sosoru/TrainUtilizingSystem/Schematics/submitted/2012_0119_ethernetboard_forPcbCart/ReadMe_FilieList.txt

Component Side:		EthernetBridge.cmp
Solder Side:		EthernetBridge.sol

Silk screen CMP:	EthernetBridge.plc
Solder stop mask CMP:	EthernetBridge.stc
Solder stop mask SOL:	EthernetBridge.sts
Outline:		EthernetBridge.out

Photoplotter info:	EthernetBridge.gpi
Drill rack:		EthernetBridge.drl
Drill data:		EthernetBridge.drd
Drill station info:	EthernetBridge.dri
