sosoru/TrainUtilizingSystem/Schematics/EthControlling/MotorController.htm

Partlist exported from C:/Users/Administrator/Documents/TrainUtilizingSystem/Schematics/EthControlling/MotorController.sch at 2012/06/23 19:24:36

Assembly variant:

Qty | Value | Device | Parts
4 | | CPOL-EUE2,5-6E | C1, C2, C26, C28
4 | 0.1 | R-EU_R1206 | R12, R15, R29, R35
12 | 0.1u | C-EUC0603 | C3, C4, C6, C7, C10, C14, C15, C16, C19, C20, C25, C27
4 | 1Meg | R-EU_R0603 | R3, R13, R28, R34
4 | 1N4148DO35-7 | 1N4148DO35-7 | D1, D2, D3, D4
8 | 1k | R-EU_R0603 | R6, R7, R17, R19, R25, R26, R32, R33
4 | 2SC1815 | 2SC1815 | T1, T2, T3, T4
12 | 3.3k | R-EU_R0603 | R1, R2, R10, R11, R14, R16, R21, R23, R30, R31, R36, R37
8 | 4.7u | C-EUC0603 | C5, C8, C9, C11, C17, C18, C23, C24
5 | 10k | R-EU_R0603 | R5, R8, R22, R39, R41
1 | 20.000M | XTAL/S | Q1
2 | 22p | C-EUC0603 | C21, C22
4 | 25k | R-EU_R0603 | R18, R20, R24, R27
1 | 47u | L-EUL3216C | L1
4 | 100k | R-EU_R0603 | R4, R9, R38, R40
1 | 100u | CPOL-EUE2-5 | C13
1 | 100u | CPOL-EUE2.5-6 | C12
4 | 942H | 942H | A, B, C, D
1 | AVR-JTAG-10 | AVR-JTAG-10 | JP1
4 | G | LED3MM | LED1, LED3, LED5, LED7
1 | MEGA164P/324P/644P-AU | MEGA164P/324P/644P-AU | IC2
4 | O | LED3MM | LED2, LED4, LED6, LED8
1 | OPA4234P | OPA4234P | IC3
5 | POLYSWITCH_20204/5 | POLYSWITCH_20204/5 | F1, F2, F3, F4, F5
4 | TB6559 | TB6559 | U$1, U$2, U$3, U$4
2 | TLP621-2 | TLP621-2 | IC1, IC4
1 | TUS_MODULE_SUPPLY | TUS_MODULE_SUPPLY | CONN
8 | XH-2 | XH-2 | A_NEXT, A_PREV, B_NEXT, B_PREV, C_NEXT, C_PREV, D_NEXT, D_PREV
