sosoru/TrainUtilizingSystem/(list of files, cad)

Other CAD files:
DeviceSoftware/TrainSensorModule/TrainSensorModule.obj
DeviceSoftware/TrainSensorModule/startup.obj
