sosoru/TrainUtilizingSystem/ServerUtility/TusSolution/TestProject_/VoltageTestCase.csv

Expected | Result
0.5 | 0.5
-0.1 | -0.1
1.1 | 1.1
