sosoru/TrainUtilizingSystem/Schematics/Box/Box_Bottom.pdf

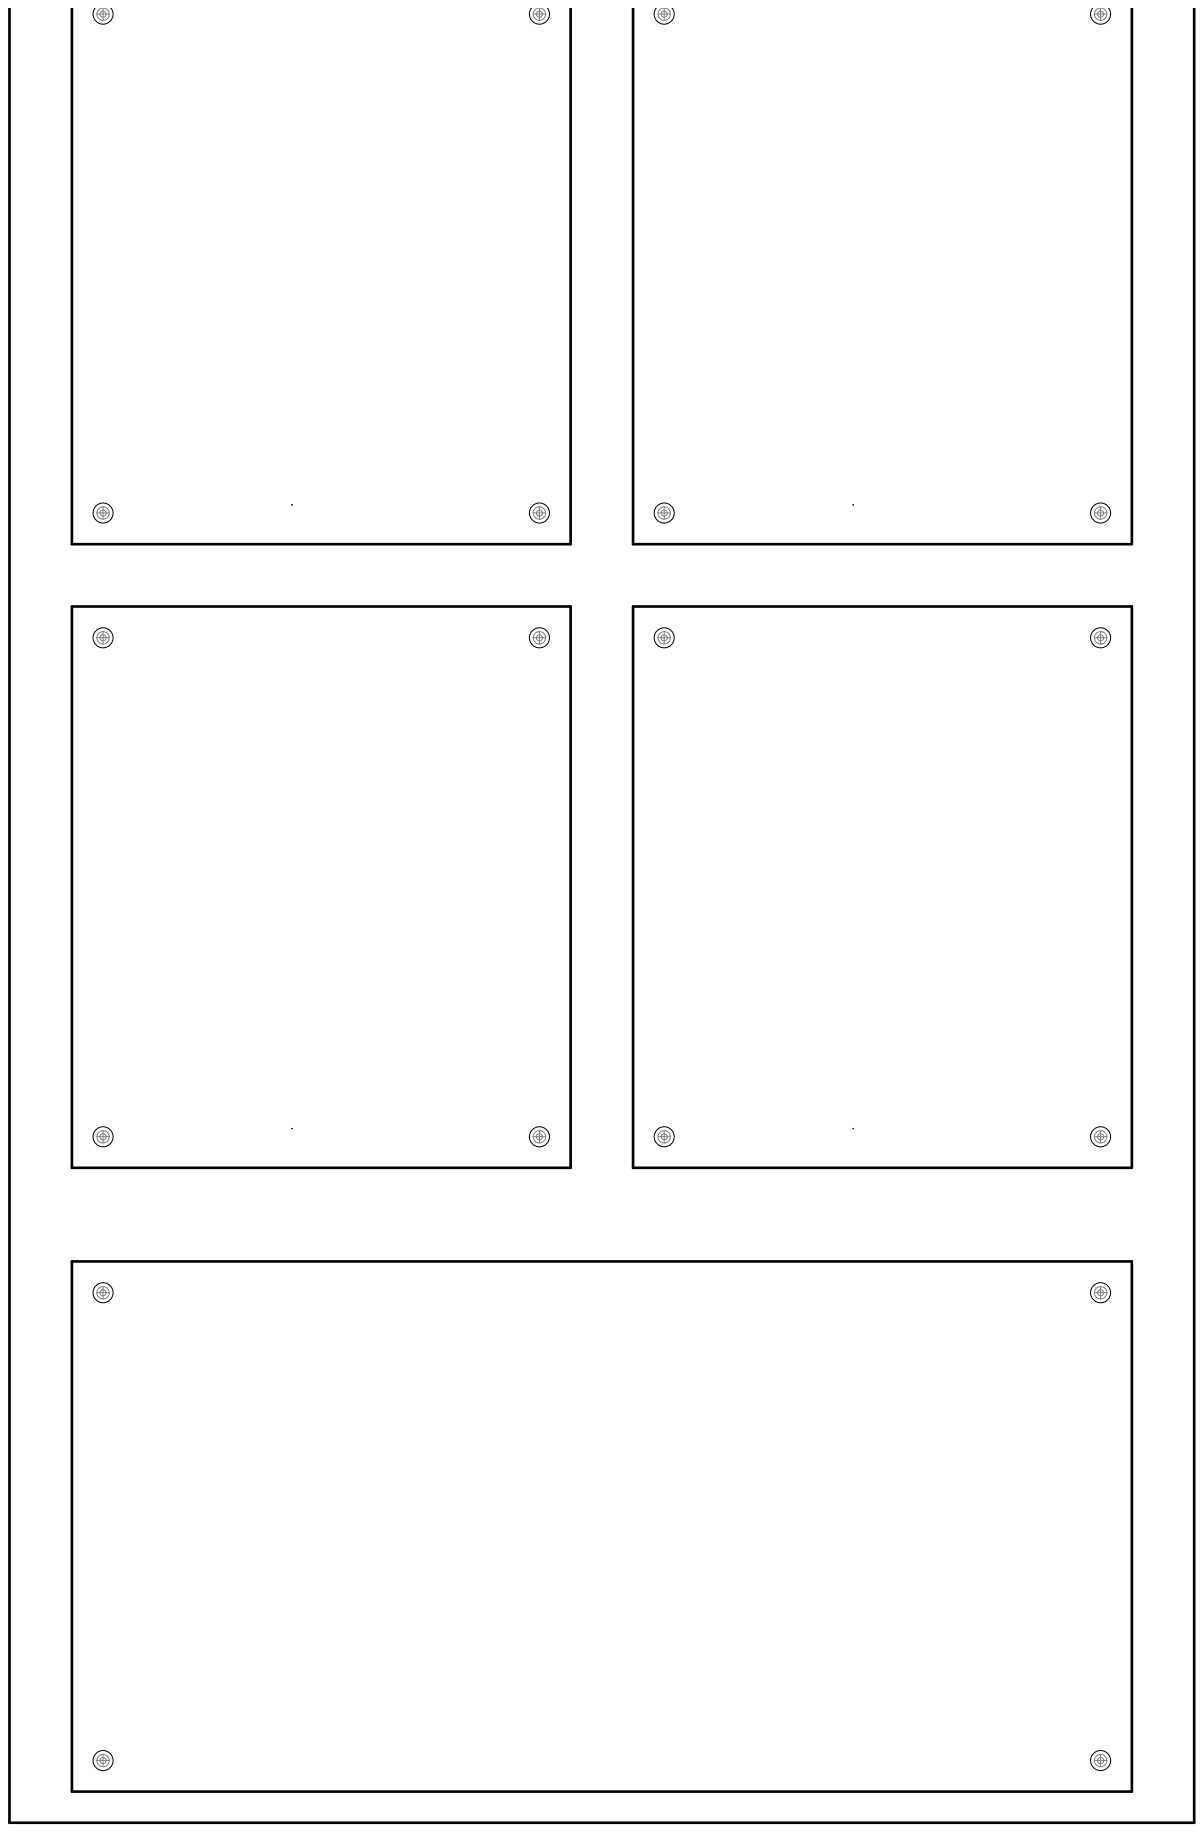
[picture p1: page 1]
