sosoru/TrainUtilizingSystem/Schematics/Box/Box_Side.pdf

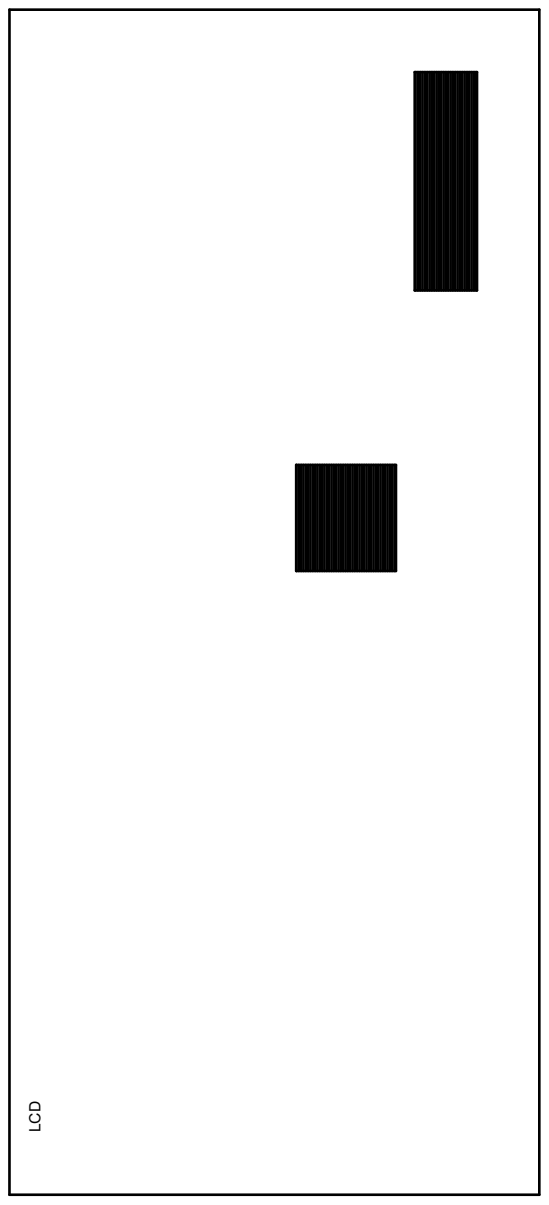
[picture p2: page 1]
