sosoru/TrainUtilizingSystem/Schematics/Box/Box_Top.pdf

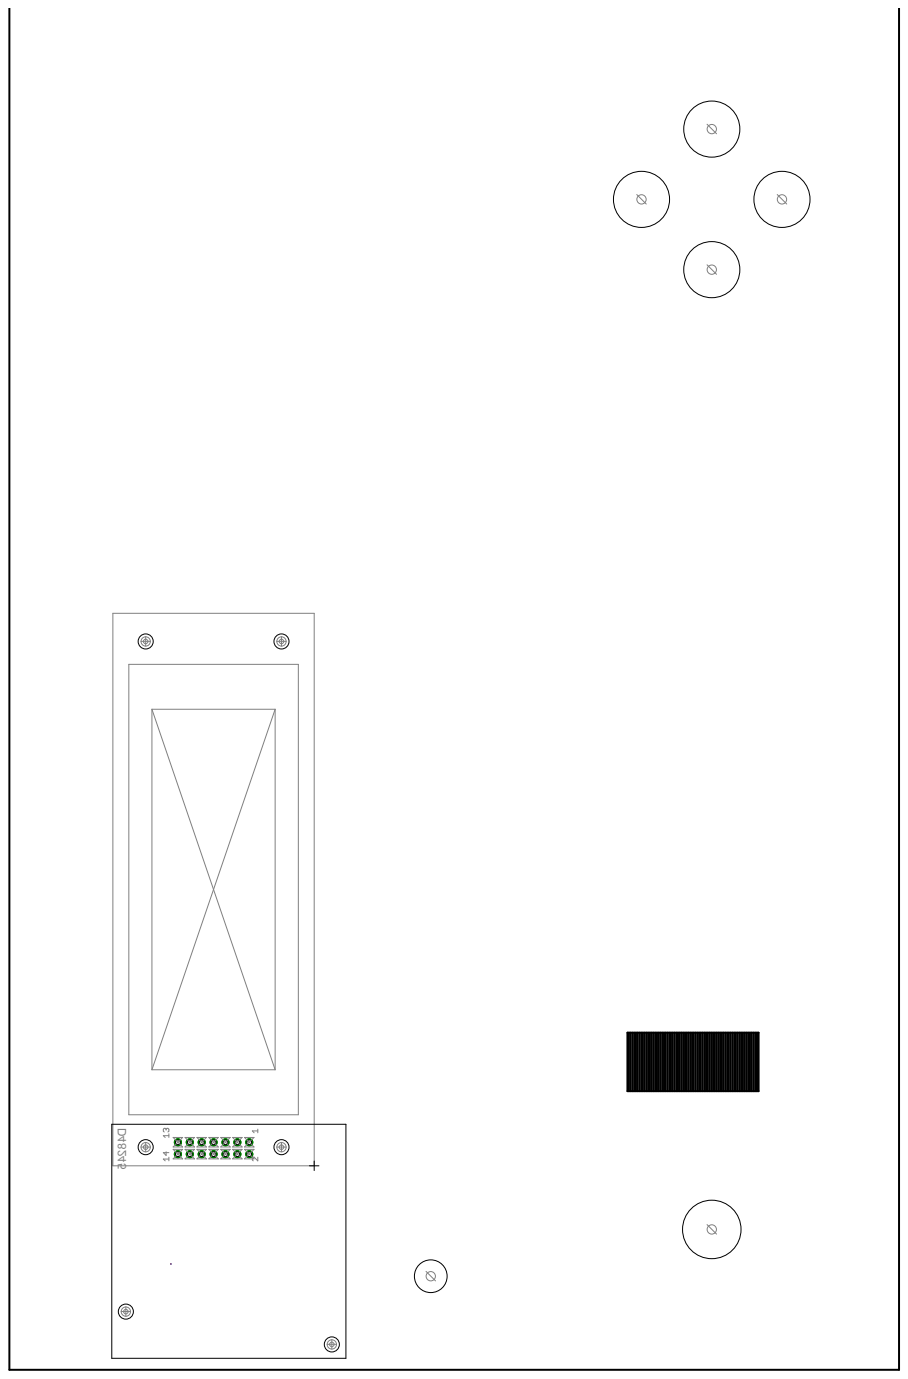
[picture p3: page 1]
