sosoru/TrainUtilizingSystem/Schematics/EthControlling/AtxPowerDispatcher3.brd

## EAGLE design Schematics/EthControlling/AtxPowerDispatcher3.brd (2014-10-11)

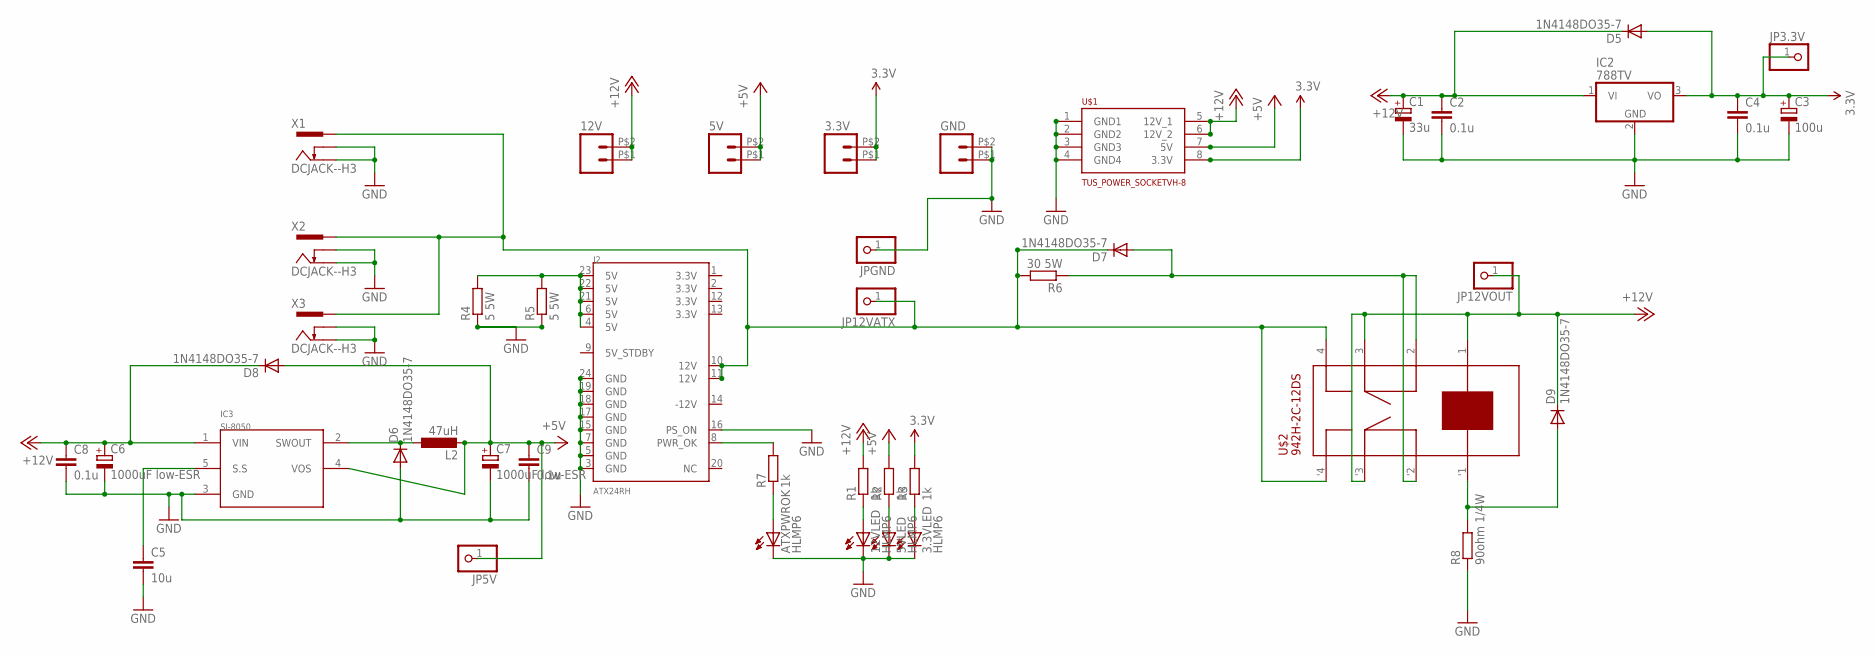
[picture p4: schematic AtxPowerDispatcher3.sch]

Parts:
3.3V, 5V, 12V: M02PTH2; 1X02_BIG
3.3VLED, 5VLED: HLMP6; MPN HLMP-6500
12VLED: HLMP6
ATXPWROK: HLMP6; MPN HLMP-6500
C1: 33u; E2,5-6E
C2, C4, C8, C9: 0.1u; C0603
C3: 100u; E2,5-6E
C5: 10u; C1206
C6, C7: 1000uF low-ESR; E2,5-6E
D5, D6, D7, D8, D9: 1N4148DO35-7; DO35-7
GND: M02PTH2; 1X02_BIG
IC2: 788TV; TO220V
IC3: SI-8050; TO220-5
J2: ATX24RH; ATX24_RIGHT_ANGLE
JP3.3V, JP5V, JP12VATX, JP12VOUT: PINHD-1X1; 1X01
JPGND: PINHD-1X1; 1X01
L2: 47uH; 2200-12.7
R1, R2, R3, R7: 1k; R0603
R4, R5: 5 5W; 0922/22
R6: 30 5W; 0922/22
R8: 90ohm 1/4W; 0207/10
U$1: TUS_POWER_SOCKETVH-8; VH_8
U$2: 942H-2C-12DS; 942H
X1, X2, X3: DCJACK--H3; 2DC-0005D100--H3

Connections:
3.3V: 3.3V.P$1 (1), 3.3V.P$2 (2), C3.+, C4.1, D5.A, IC2.3 (VO), JP3.3V.1, R3.2, U$1.8 (3.3V)
+5V: 5V.P$1 (1), 5V.P$2 (2), C7.+, C9.1, D8.A, IC3.4 (VOS), JP5V.1, L2.2, R2.2, U$1.7 (5V)
+12V: 12V.P$1 (1), 12V.P$2 (2), C1.+, C2.1, C6.+, C8.1, D5.C, D8.C, D9.C, IC2.1 (VI), IC3.1 (VIN), JP12VOUT.1, R1.2, U$1.5 (12V_1), U$1.6 (12V_2), U$2.1 (4), U$2.3 (2), U$2.'3 ('2)
GND: 3.3VLED.K, 5VLED.K, 12VLED.K, ATXPWROK.K, C1.-, C2.2, C3.-, C4.2, C5.2, C6.-, C7.-, C8.2, C9.2, D6.A, GND.P$1 (1), GND.P$2 (2), IC2.2 (GND), IC3.3 (GND), J2.3 (GND), J2.5 (GND), J2.7 (GND), J2.15 (GND), J2.16 (PS_ON), J2.17 (GND), J2.18 (GND), J2.19 (GND), J2.24 (GND), JPGND.1, R4.1, R5.1, R8.1, U$1.1 (GND1), U$1.2 (GND2), U$1.3 (GND3), U$1.4 (GND4), X1.2, X1.3, X2.2, X2.3, X3.2, X3.3
unnamed: 12VLED.A, R1.1
unnamed: J2.8 (PWR_OK), R7.2
unnamed: J2.4 (5V), J2.6 (5V), J2.21 (5V), J2.22 (5V), J2.23 (5V), R4.2, R5.2
unnamed: 5VLED.A, R2.1
unnamed: 3.3VLED.A, R3.1
unnamed: ATXPWROK.A, R7.1
unnamed: D9.A, R8.2, U$2.'1 ('4)
unnamed: D6.C, IC3.2 (SWOUT), L2.1
unnamed: D7.A, R6.1, U$2.2 (3), U$2.'2 ('3)
unnamed: D7.C, J2.10 (12V), J2.11 (12V), JP12VATX.1, R6.2, U$2.4 (1), U$2.'4 ('1), X1.1, X2.1, X3.1
unnamed: C5.1, IC3.5 (S.S)

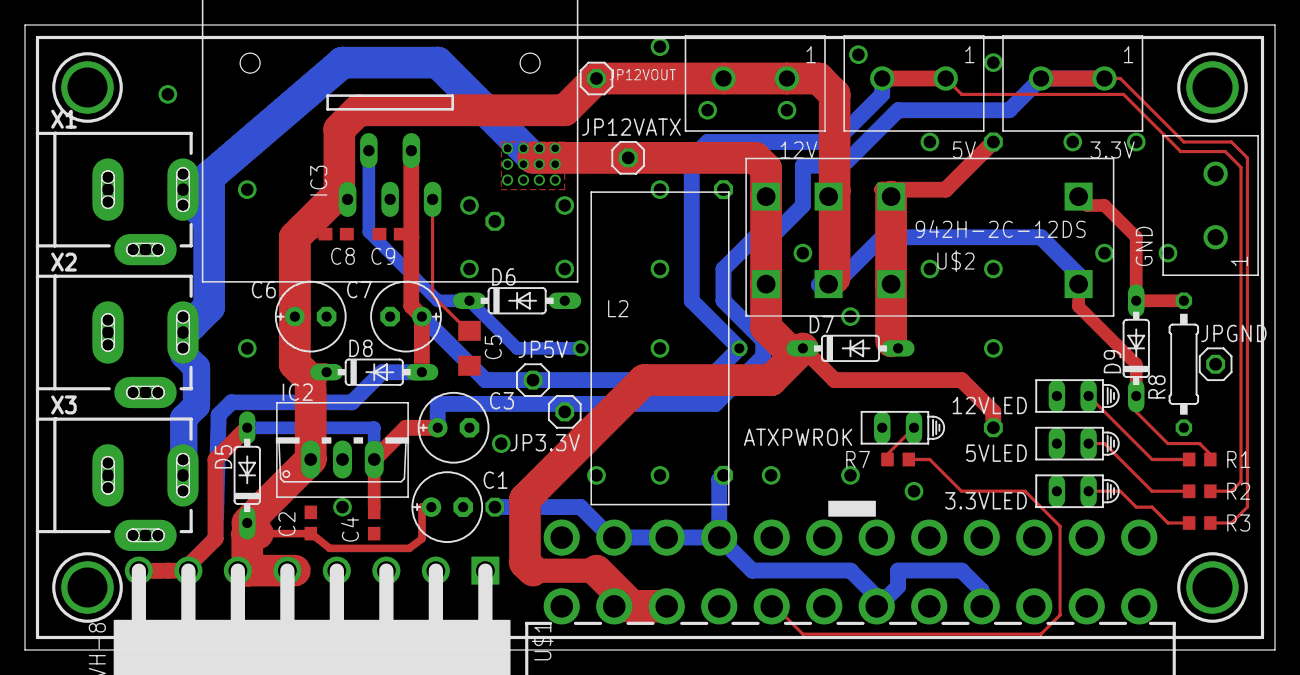
[picture p5: board AtxPowerDispatcher3.brd from above]

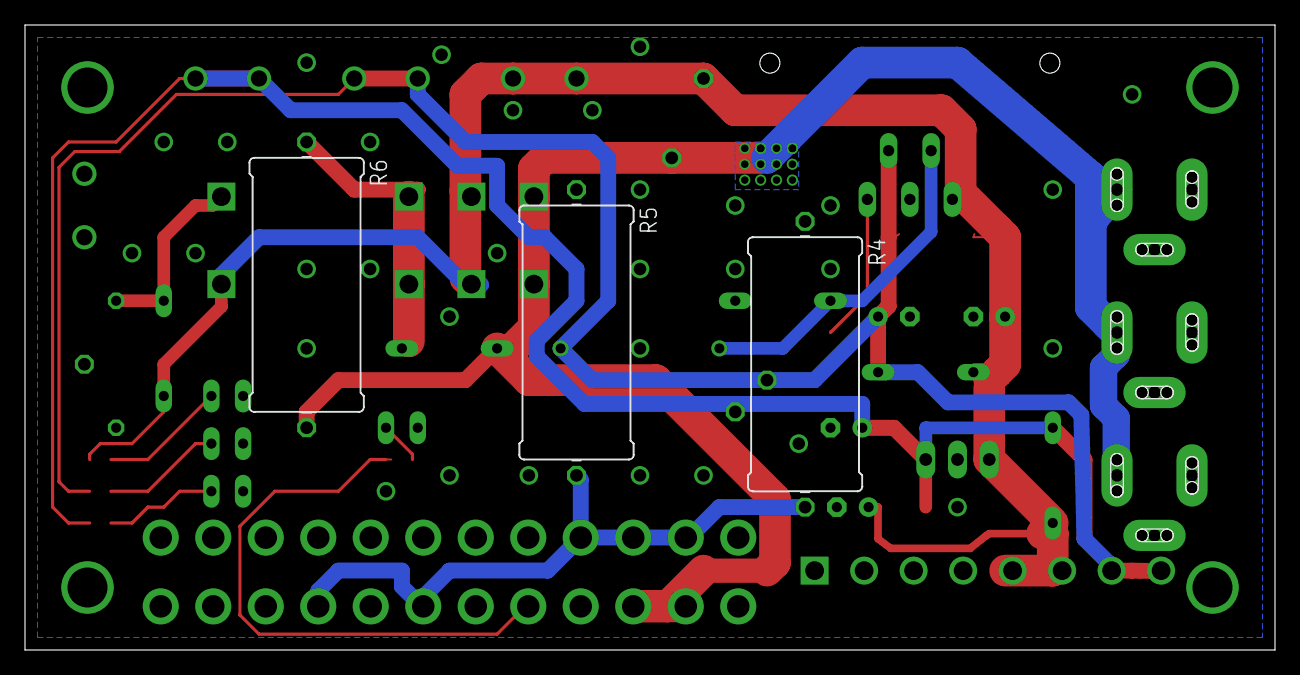
[picture p6: board AtxPowerDispatcher3.brd from below]

Board: 2 copper layers, 100.0 x 50.0 mm, 44 parts (3 on the bottom side), 15 nets.
