sosoru/TrainUtilizingSystem/Schematics/EthControlling/LedSignalDispatcher.brd

## EAGLE design Schematics/EthControlling/LedSignalDispatcher.brd (2013-08-01)

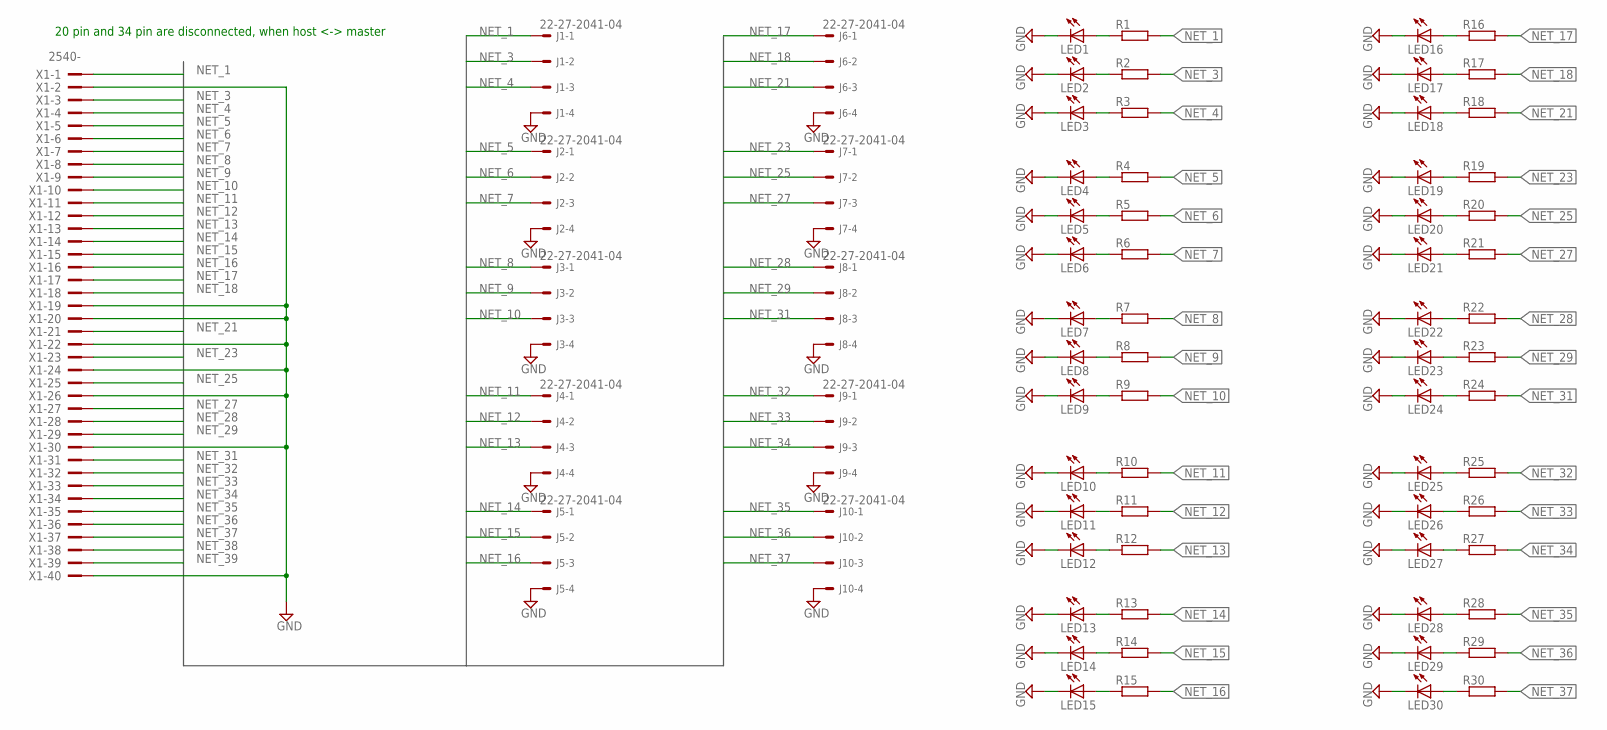
[picture p7: schematic LedSignalDispatcher.sch]

Parts:
J1, J2, J3, J4, J5, J6, J7, J8, J9, J10: 22-27-2041-04; 6410-04
LED1, LED2, LED3, LED4, LED5, LED6, LED7, LED8, LED9, LED10, LED11, LED12, LED13, LED14, LED15, LED16, LED17, LED18, LED19, LED20, LED21, LED22, LED23, LED24, LED25, LED26, LED27, LED28, LED29, LED30: LEDP-LCC-2; P-LCC-2
R1, R2, R3, R4, R5, R6, R7, R8, R9, R10, R11, R12, R13, R14, R15, R16, R17, R18, R19, R20, R21, R22, R23, R24, R25, R26, R27, R28, R29, R30: SMT-REF
X1: 2540-; PAK100/2500-40

Connections:
GND: J1.4, J2.4, J3.4, J4.4, J5.4, J6.4, J7.4, J8.4, J9.4, J10.4, LED1.C, LED2.C, LED3.C, LED4.C, LED5.C, LED6.C, LED7.C, LED8.C, LED9.C, LED10.C, LED11.C, LED12.C, LED13.C, LED14.C, LED15.C, LED16.C, LED17.C, LED18.C, LED19.C, LED20.C, LED21.C, LED22.C, LED23.C, LED24.C, LED25.C, LED26.C, LED27.C, LED28.C, LED29.C, LED30.C, X1.2, X1.19, X1.20, X1.22, X1.24, X1.26, X1.30, X1.40
unnamed: LED1.A, R1.2
unnamed: LED2.A, R2.2
unnamed: LED3.A, R3.2
unnamed: LED4.A, R4.2
unnamed: LED5.A, R5.2
unnamed: LED6.A, R6.2
unnamed: LED7.A, R7.2
unnamed: LED8.A, R8.2
unnamed: LED9.A, R9.2
unnamed: LED10.A, R10.2
unnamed: LED11.A, R11.2
unnamed: LED12.A, R12.2
unnamed: LED13.A, R13.2
unnamed: LED14.A, R14.2
unnamed: LED15.A, R15.2
unnamed: LED16.A, R16.2
unnamed: LED17.A, R17.2
unnamed: LED18.A, R18.2
unnamed: LED19.A, R19.2
unnamed: LED20.A, R20.2
unnamed: LED21.A, R21.2
unnamed: LED22.A, R22.2
unnamed: LED23.A, R23.2
unnamed: LED24.A, R24.2
unnamed: LED25.A, R25.2
unnamed: LED26.A, R26.2
unnamed: LED27.A, R27.2
unnamed: LED28.A, R28.2
unnamed: LED29.A, R29.2
unnamed: LED30.A, R30.2
NET_1: J1.1, R1.1, X1.1
NET_3: J1.2, R2.1, X1.3
NET_4: J1.3, R3.1, X1.4
NET_5: J2.1, R4.1, X1.5
NET_6: J2.2, R5.1, X1.6
NET_7: J2.3, R6.1, X1.7
NET_8: J3.1, R7.1, X1.8
NET_9: J3.2, R8.1, X1.9
NET_10: J3.3, R9.1, X1.10
NET_11: J4.1, R10.1, X1.11
NET_12: J4.2, R11.1, X1.12
NET_13: J4.3, R12.1, X1.13
NET_14: J5.1, R13.1, X1.14
NET_15: J5.2, R14.1, X1.15
NET_16: J5.3, R15.1, X1.16
NET_17: J6.1, R16.1, X1.17
NET_18: J6.2, R17.1, X1.18
NET_21: J6.3, R18.1, X1.21
NET_23: J7.1, R19.1, X1.23
NET_25: J7.2, R20.1, X1.25
NET_27: J7.3, R21.1, X1.27
NET_28: J8.1, R22.1, X1.28
NET_29: J8.2, R23.1, X1.29
NET_31: J8.3, R24.1, X1.31
NET_32: J9.1, R25.1, X1.32
NET_33: J9.2, R26.1, X1.33
NET_34: J9.3, R27.1, X1.34
NET_35: J10.1, R28.1, X1.35
NET_36: J10.2, R29.1, X1.36
NET_37: J10.3, R30.1, X1.37
NET_38: X1.38
NET_39: X1.39

Notes on the sheet:
20 pin and 34 pin are disconnected, when host <-> master

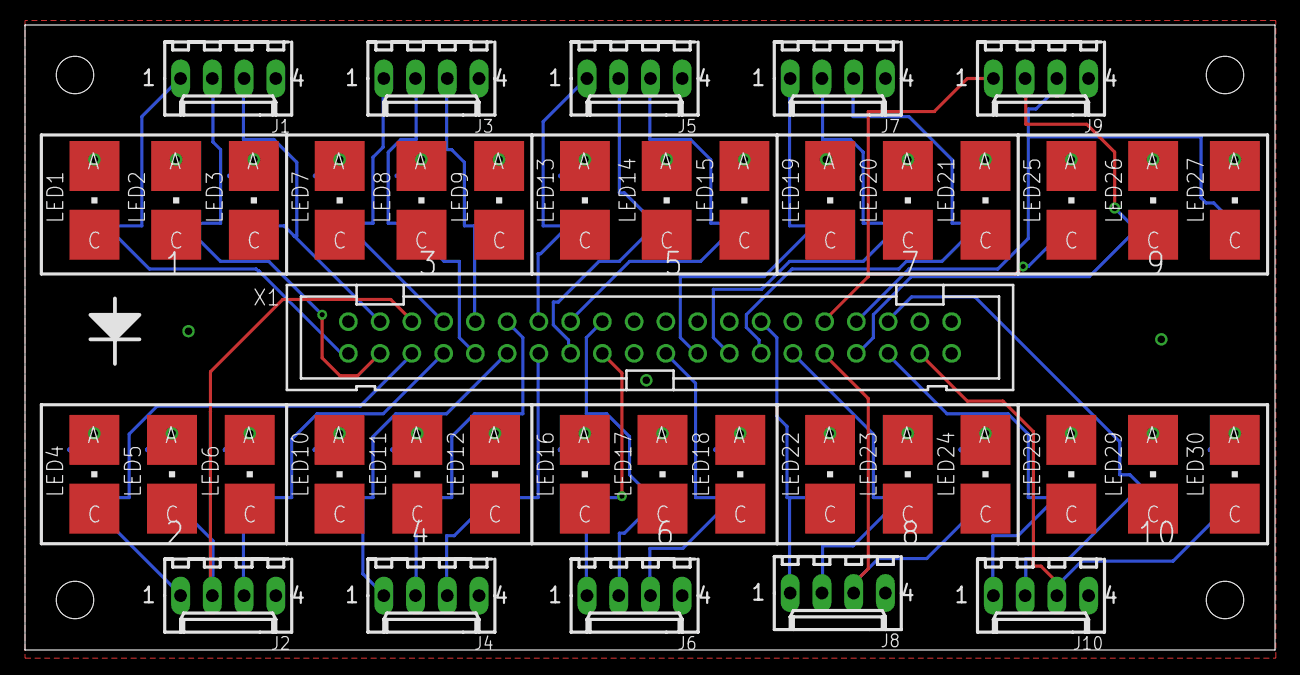
[picture p8: board LedSignalDispatcher.brd from above]

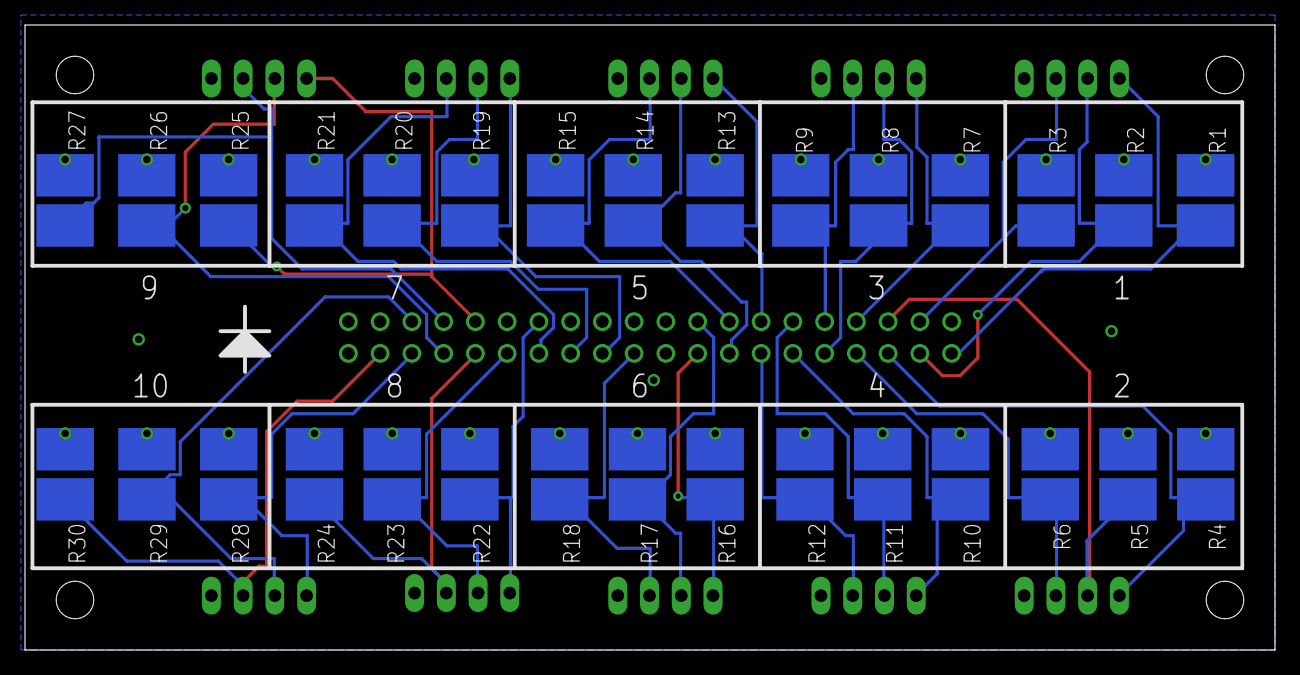
[picture p9: board LedSignalDispatcher.brd from below]

Board: 2 copper layers, 100.0 x 50.0 mm, 71 parts (30 on the bottom side), 61 nets.
