sosoru/TrainUtilizingSystem/Schematics/EthControlling/SerialTrainSensor_drill.brd

## EAGLE design Schematics/EthControlling/SerialTrainSensor_drill.brd (2013-05-04)

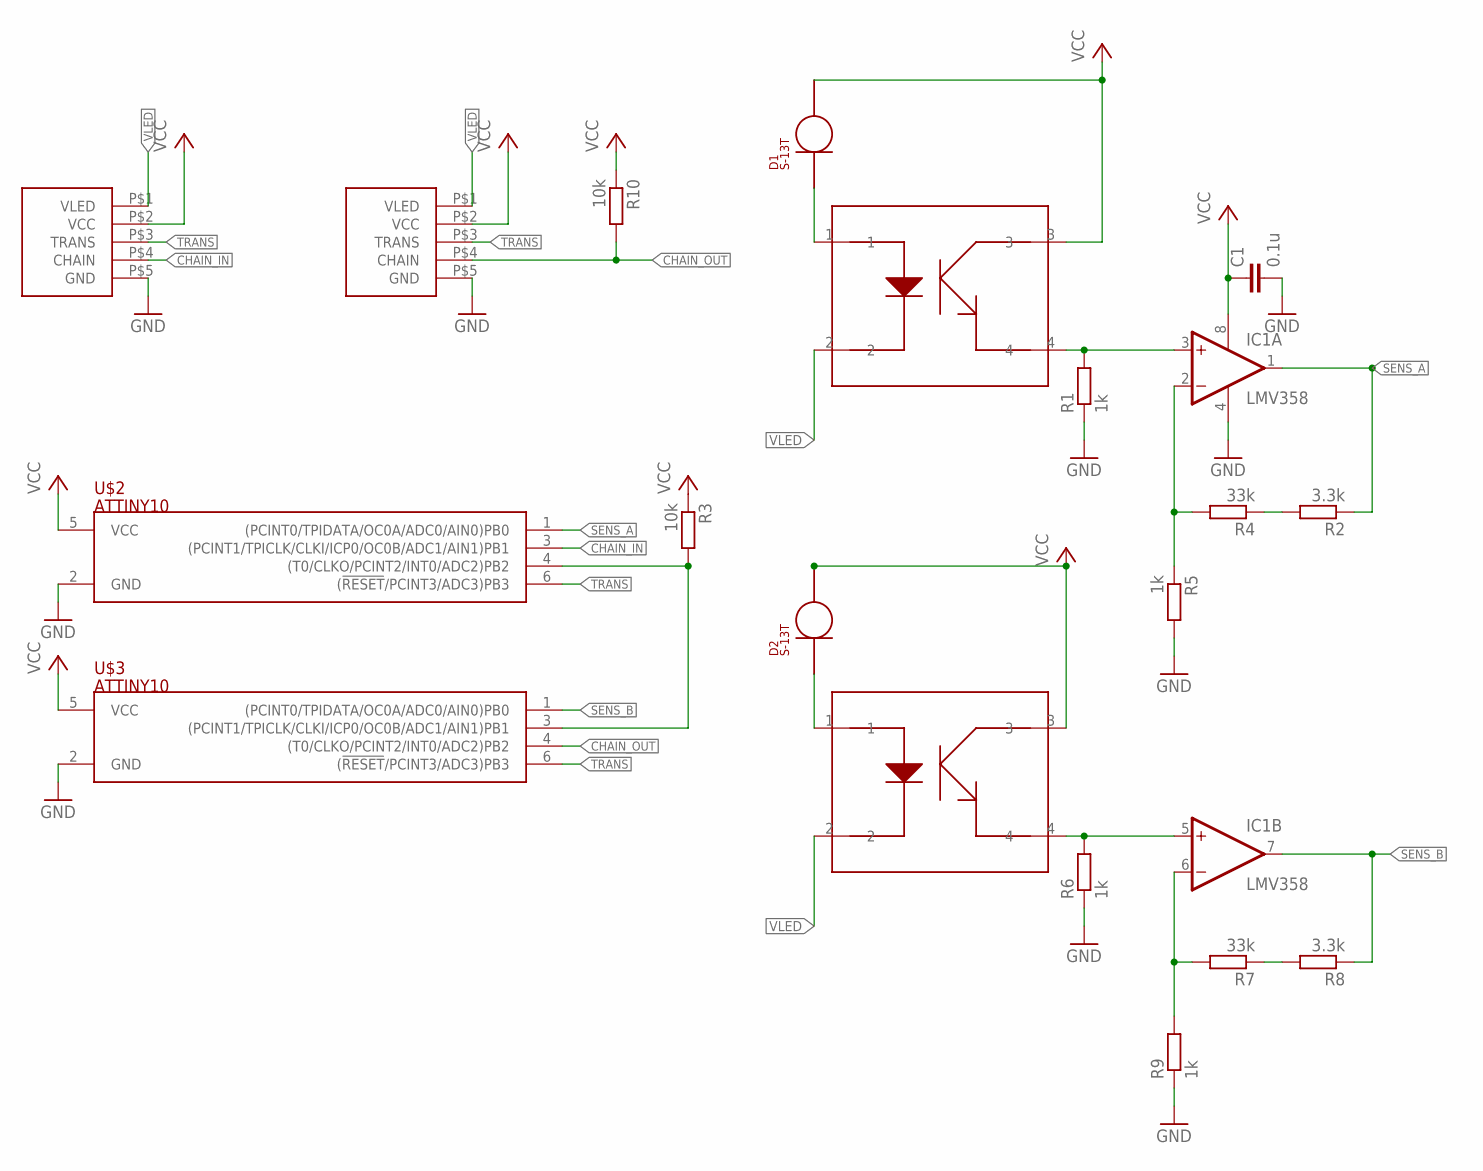
[picture p10: schematic SerialTrainSensor_drill.sch]

Parts:
C1: 0.1u; C0603
D1, D2: S-13T; S-1*3T
IC1: LMV358; TSSOP8
R1, R5, R6, R9: 1k; R0603
R2, R8: 3.3k; R0603
R3, R10: 10k; R0603
R4, R7: 33k; R0603
SMD1, SMD2: SERIAL_SENSORHALF; SERIAL_5_HALF
U$1, U$4: TPR-105F
U$2, U$3: ATTINY10; SOT-23

Connections:
CHAIN_IN: SMD1.P$4 (CHAIN), U$2.3 ((PCINT1/TPICLK/CLKI/ICP0/OC0B/ADC1/AIN1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)
CHAIN_OUT: R10.2, SMD2.P$4 (CHAIN), U$3.4 ((T0/CLKO/PCINT2/INT0/ADC2)PB2)
GND: C1.2, IC1.4 (V-), R1.1, R5.2, R6.1, R9.1, SMD1.P$5 (GND), SMD2.P$5 (GND), U$2.2 (GND), U$3.2 (GND)
unnamed: D1.C, U$1.1
unnamed: IC1.3 (+IN), R1.2, U$1.4
unnamed: D2.C, U$4.1
unnamed: R3.2, U$2.4 ((T0/CLKO/PCINT2/INT0/ADC2)PB2), U$3.3 ((PCINT1/TPICLK/CLKI/ICP0/OC0B/ADC1/AIN1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)
unnamed: IC1.5 (+IN), R6.2, U$4.4
unnamed: IC1.2 (-IN), R4.2, R5.1
unnamed: IC1.6 (-IN), R7.2, R9.2
unnamed: R2.2, R4.1
unnamed: R7.1, R8.2
SENS_A: IC1.1 (OUT), R2.1, U$2.1 ((PCINT0/TPIDATA/OC0A/ADC0/AIN0)PB0)
SENS_B: IC1.7 (OUT), R8.1, U$3.1 ((PCINT0/TPIDATA/OC0A/ADC0/AIN0)PB0)
TRANS: SMD1.P$3 (TRANS), SMD2.P$3 (TRANS), U$2.6 ((!RESET!/PCINT3/ADC3)PB3), U$3.6 ((!RESET!/PCINT3/ADC3)PB3)
VCC: C1.1, D1.A, D2.A, IC1.8 (V+), R3.1, R10.1, SMD1.P$2 (VCC), SMD2.P$2 (VCC), U$1.3, U$2.5 (VCC), U$3.5 (VCC), U$4.3
VLED: SMD1.P$1 (VLED), SMD2.P$1 (VLED), U$1.2, U$4.2

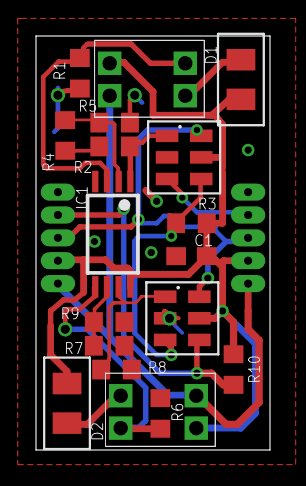
[picture p11: board SerialTrainSensor_drill.brd from above]

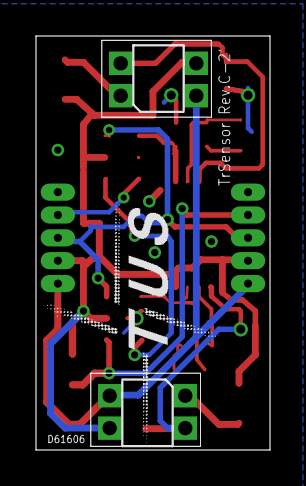
[picture p12: board SerialTrainSensor_drill.brd from below]

Board: 2 copper layers, 13.0 x 23.0 mm, 20 parts (2 on the bottom side), 17 nets.
