sosoru/TrainUtilizingSystem/Schematics/EthControlling/SensorController_revB.brd

## EAGLE design Schematics/EthControlling/SensorController_revB.brd (2012-10-16)

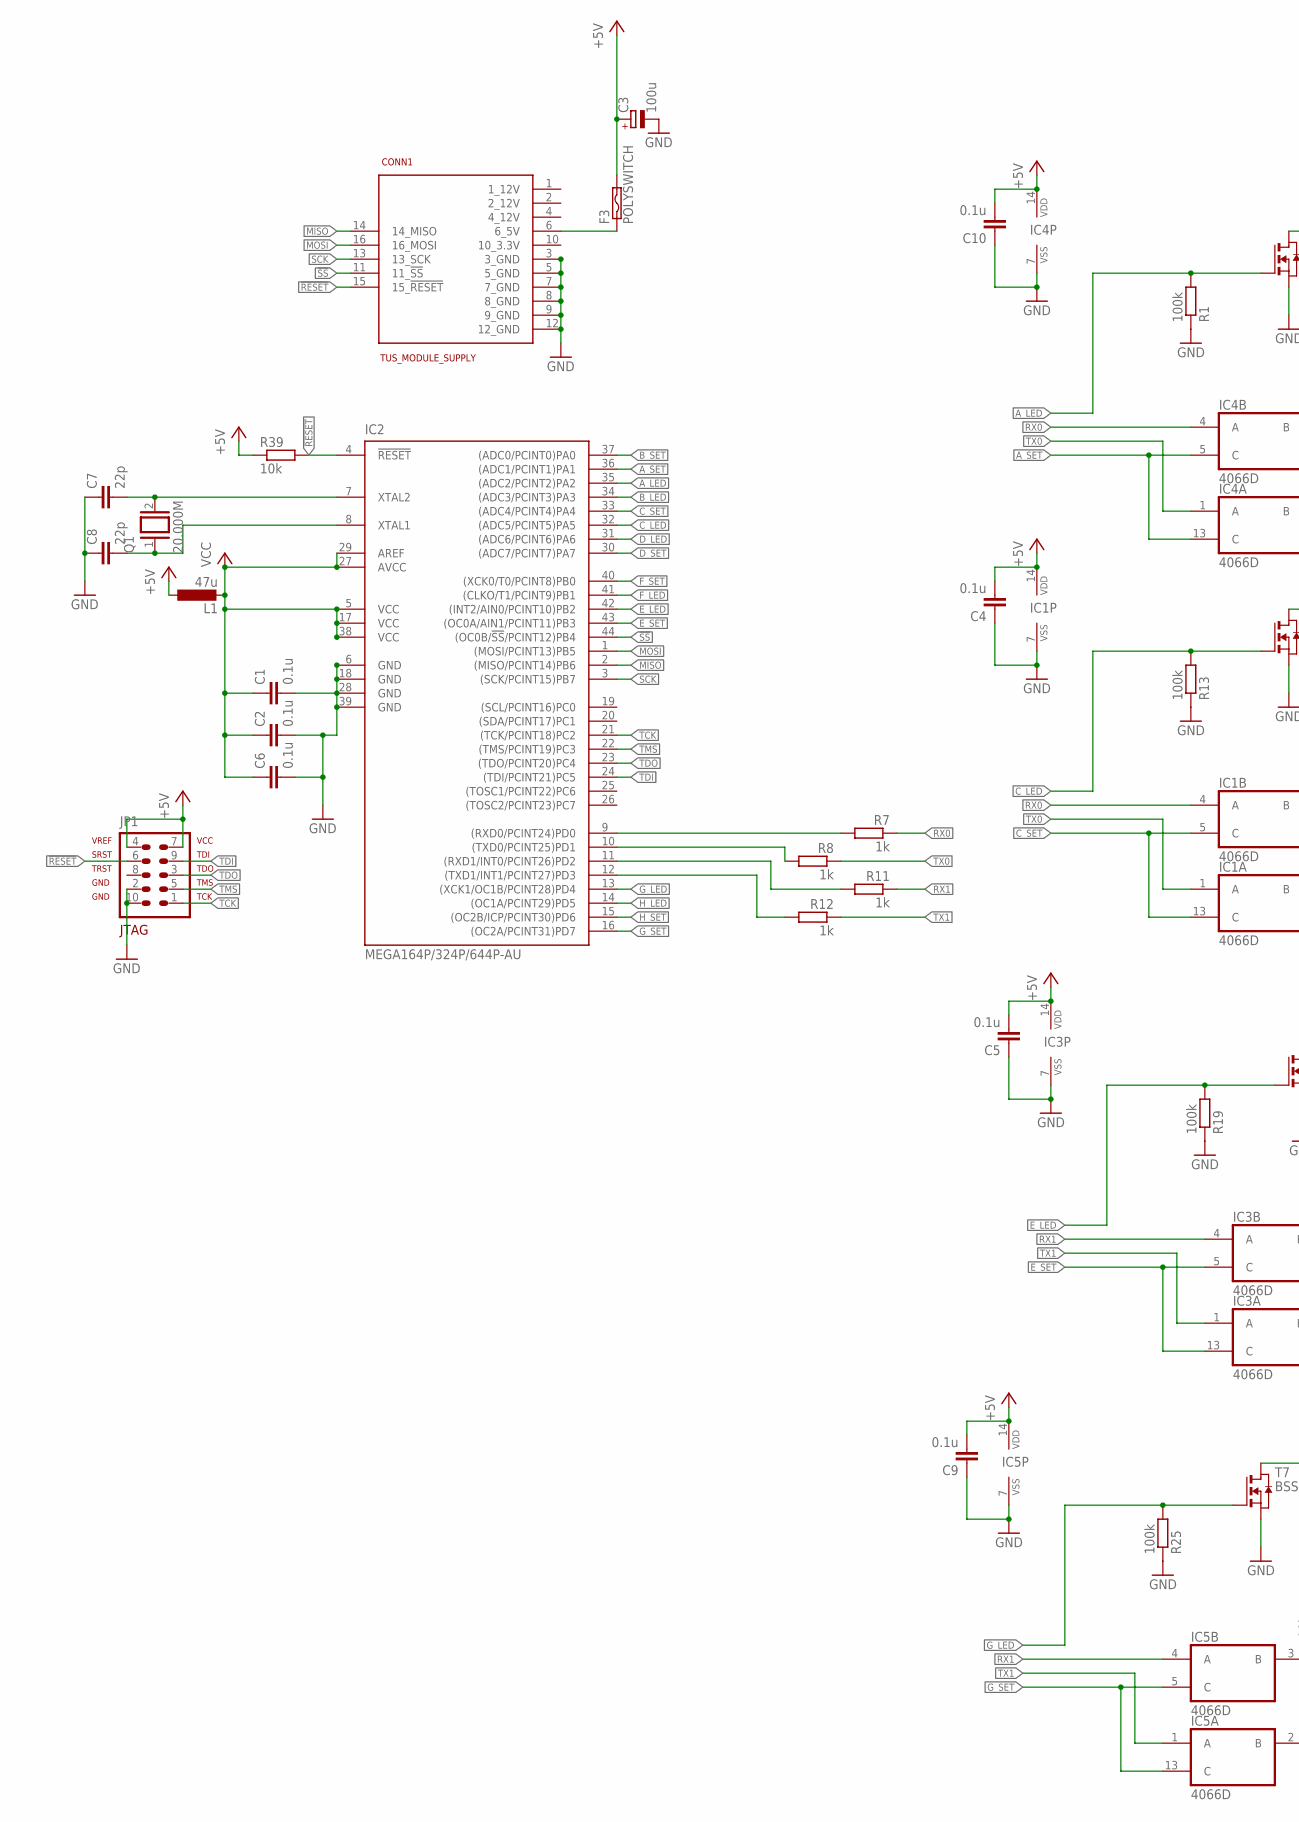
[picture p13: schematic SensorController_revB.sch, part in row 1, column 1]

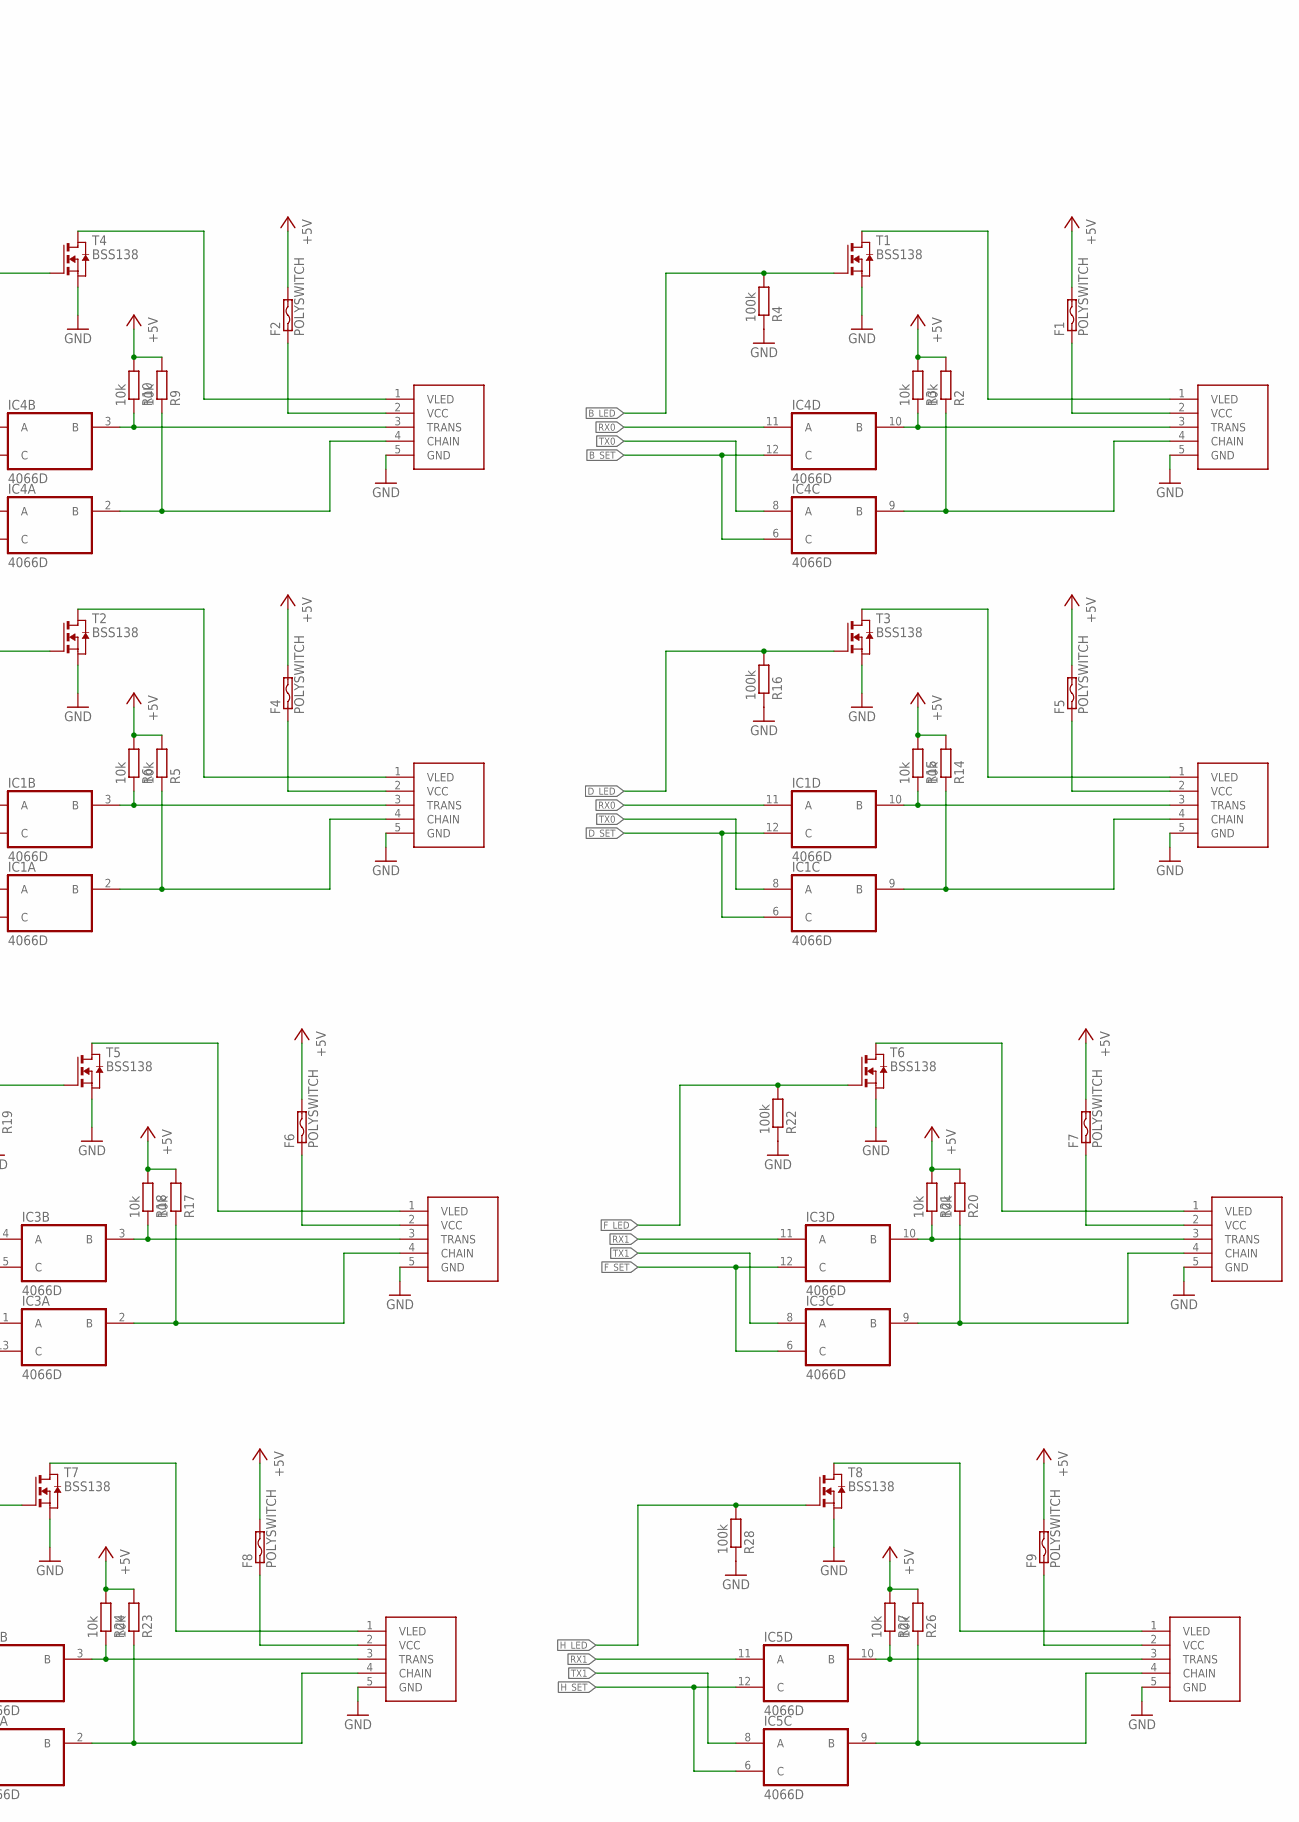
[picture p14: schematic SensorController_revB.sch, part in row 1, column 2]

Parts:
A_OUT: SERIAL_SENSORXH; XH-5
B_OUT: SERIAL_SENSORXH; XH-5
C1, C2, C4, C5, C6, C9, C10: 0.1u; C1608
C3: 100u; E2,5-5
C7, C8: 22p; C1608
CONN1: TUS_MODULE_SUPPLY; 2X08
C_OUT: SERIAL_SENSORXH; XH-5
D_OUT: SERIAL_SENSORXH; XH-5
E_OUT: SERIAL_SENSORXH; XH-5
F1, F2, F3, F4, F5, F6, F7, F8, F9: POLYSWITCH; 0207/2V
F_OUT: SERIAL_SENSORXH; XH-5
G_OUT: SERIAL_SENSORXH; XH-5
H_OUT: SERIAL_SENSORXH; XH-5
IC1, IC3, IC4, IC5: 4066D; SO14
IC2: MEGA164P/324P/644P-AU; TQFP44
JP1: AVR-JTAG-10
L1: 47u; L1812
Q1: 20.000M; QS
R1, R4, R13, R16, R19, R22, R25, R28: 100k; R0603
R2, R3, R5, R6, R9, R10, R14, R15, R17, R18, R20, R21, R23, R24, R26, R27, R39: 10k; R0603
R7, R8, R11, R12: 1k; R0603
T1, T2, T3, T4, T5, T6, T7, T8: BSS138; SOT-23

Connections:
!RESET: CONN1.15 (15_!RESET), IC2.4 (!RESET), JP1.6, R39.2
!SS: CONN1.11 (11_!SS), IC2.44 ((OC0B/!SS!/PCINT12)PB4)
+5V: C3.+, C4.2, C5.2, C9.2, C10.2, F1.2, F2.2, F3.2, F4.2, F5.2, F6.2, F7.2, F8.2, F9.2, IC1.14 (VDD), IC3.14 (VDD), IC4.14 (VDD), IC5.14 (VDD), JP1.4, JP1.7, L1.1, R2.2, R3.2, R5.2, R6.2, R9.2, R10.2, R14.2, R15.2, R17.2, R18.2, R20.2, R21.2, R23.2, R24.2, R26.2, R27.2, R39.1
A_LED: IC2.35 ((ADC2/PCINT2)PA2), R1.2, T4.3 (G)
A_SET: IC2.36 ((ADC1/PCINT1)PA1), IC4.5 (C), IC4.13 (C)
B_LED: IC2.34 ((ADC3/PCINT3)PA3), R4.2, T1.3 (G)
B_SET: IC2.37 ((ADC0/PCINT0)PA0), IC4.6 (C), IC4.12 (C)
C_LED: IC2.32 ((ADC5/PCINT5)PA5), R13.2, T2.3 (G)
C_SET: IC1.5 (C), IC1.13 (C), IC2.33 ((ADC4/PCINT4)PA4)
D_LED: IC2.31 ((ADC6/PCINT6)PA6), R16.2, T3.3 (G)
D_SET: IC1.6 (C), IC1.12 (C), IC2.30 ((ADC7/PCINT7)PA7)
E_LED: IC2.42 ((INT2/AIN0/PCINT10)PB2), R19.2, T5.3 (G)
E_SET: IC2.43 ((OC0A/AIN1/PCINT11)PB3), IC3.5 (C), IC3.13 (C)
F_LED: IC2.41 ((CLKO/T1/PCINT9)PB1), R22.2, T6.3 (G)
F_SET: IC2.40 ((XCK0/T0/PCINT8)PB0), IC3.6 (C), IC3.12 (C)
GND: A_OUT.5 (GND), B_OUT.5 (GND), C1.2, C2.2, C3.-, C4.1, C5.1, C6.2, C7.1, C8.1, C9.1, C10.1, CONN1.3 (3_GND), CONN1.5 (5_GND), CONN1.7 (7_GND), CONN1.8 (8_GND), CONN1.9 (9_GND), CONN1.12 (12_GND), C_OUT.5 (GND), D_OUT.5 (GND), E_OUT.5 (GND), F_OUT.5 (GND), G_OUT.5 (GND), H_OUT.5 (GND), IC1.7 (VSS), IC2.6 (GND), IC2.18 (GND), IC2.28 (GND), IC2.39 (GND), IC3.7 (VSS), IC4.7 (VSS), IC5.7 (VSS), JP1.2, JP1.10, R1.1, R4.1, R13.1, R16.1, R19.1, R22.1, R25.1, R28.1, T1.2 (S), T2.2 (S), T3.2 (S), T4.2 (S), T5.2 (S), T6.2 (S), T7.2 (S), T8.2 (S)
G_LED: IC2.13 ((XCK1/OC1B/PCINT28)PD4), R25.2, T7.3 (G)
G_SET: IC2.16 ((OC2A/PCINT31)PD7), IC5.5 (C), IC5.13 (C)
H_LED: IC2.14 ((OC1A/PCINT29)PD5), R28.2, T8.3 (G)
H_SET: IC2.15 ((OC2B/ICP/PCINT30)PD6), IC5.6 (C), IC5.12 (C)
MISO: CONN1.14 (14_MISO), IC2.2 ((MISO/PCINT14)PB6)
MOSI: CONN1.16 (16_MOSI), IC2.1 ((MOSI/PCINT13)PB5)
unnamed: A_OUT.1 (VLED), T4.1 (D)
unnamed: C8.2, IC2.8 (XTAL1), Q1.1
unnamed: B_OUT.4 (CHAIN), IC4.9 (B), R2.1
unnamed: C7.2, IC2.7 (XTAL2), Q1.2
unnamed: B_OUT.3 (TRANS), IC4.10 (B), R3.1
unnamed: B_OUT.2 (VCC), F1.1
unnamed: B_OUT.1 (VLED), T1.1 (D)
unnamed: C_OUT.4 (CHAIN), IC1.2 (B), R5.1
unnamed: A_OUT.4 (CHAIN), IC4.2 (B), R9.1
unnamed: A_OUT.3 (TRANS), IC4.3 (B), R10.1
unnamed: C_OUT.3 (TRANS), IC1.3 (B), R6.1
unnamed: C_OUT.2 (VCC), F4.1
unnamed: C_OUT.1 (VLED), T2.1 (D)
unnamed: D_OUT.4 (CHAIN), IC1.9 (B), R14.1
unnamed: D_OUT.3 (TRANS), IC1.10 (B), R15.1
unnamed: D_OUT.2 (VCC), F5.1
unnamed: IC2.9 ((RXD0/PCINT24)PD0), R7.2
unnamed: A_OUT.2 (VCC), F2.1
unnamed: D_OUT.1 (VLED), T3.1 (D)
unnamed: IC2.10 ((TXD0/PCINT25)PD1), R8.2
unnamed: CONN1.6 (6_5V), F3.1
unnamed: IC2.11 ((RXD1/INT0/PCINT26)PD2), R11.2
unnamed: IC2.12 ((TXD1/INT1/PCINT27)PD3), R12.2
unnamed: E_OUT.4 (CHAIN), IC3.2 (B), R17.1
unnamed: E_OUT.3 (TRANS), IC3.3 (B), R18.1
unnamed: E_OUT.2 (VCC), F6.1
unnamed: E_OUT.1 (VLED), T5.1 (D)
unnamed: F_OUT.4 (CHAIN), IC3.9 (B), R20.1
unnamed: F_OUT.3 (TRANS), IC3.10 (B), R21.1
unnamed: F7.1, F_OUT.2 (VCC)
unnamed: F_OUT.1 (VLED), T6.1 (D)
unnamed: G_OUT.4 (CHAIN), IC5.2 (B), R23.1
unnamed: G_OUT.3 (TRANS), IC5.3 (B), R24.1
unnamed: F8.1, G_OUT.2 (VCC)
unnamed: G_OUT.1 (VLED), T7.1 (D)
unnamed: H_OUT.4 (CHAIN), IC5.9 (B), R26.1
unnamed: H_OUT.3 (TRANS), IC5.10 (B), R27.1
unnamed: F9.1, H_OUT.2 (VCC)
unnamed: H_OUT.1 (VLED), T8.1 (D)
RX0: IC1.4 (A), IC1.11 (A), IC4.4 (A), IC4.11 (A), R7.1
RX1: IC3.4 (A), IC3.11 (A), IC5.4 (A), IC5.11 (A), R11.1
SCK: CONN1.13 (13_SCK), IC2.3 ((SCK/PCINT15)PB7)
TCK: IC2.21 ((TCK/PCINT18)PC2), JP1.1
TDI: IC2.24 ((TDI/PCINT21)PC5), JP1.9
TDO: IC2.23 ((TDO/PCINT20)PC4), JP1.3
TMS: IC2.22 ((TMS/PCINT19)PC3), JP1.5
TX0: IC1.1 (A), IC1.8 (A), IC4.1 (A), IC4.8 (A), R8.1
TX1: IC3.1 (A), IC3.8 (A), IC5.1 (A), IC5.8 (A), R12.1
VCC: C1.1, C2.1, C6.1, IC2.5 (VCC), IC2.17 (VCC), IC2.27 (AVCC), IC2.29 (AREF), IC2.38 (VCC), L1.2

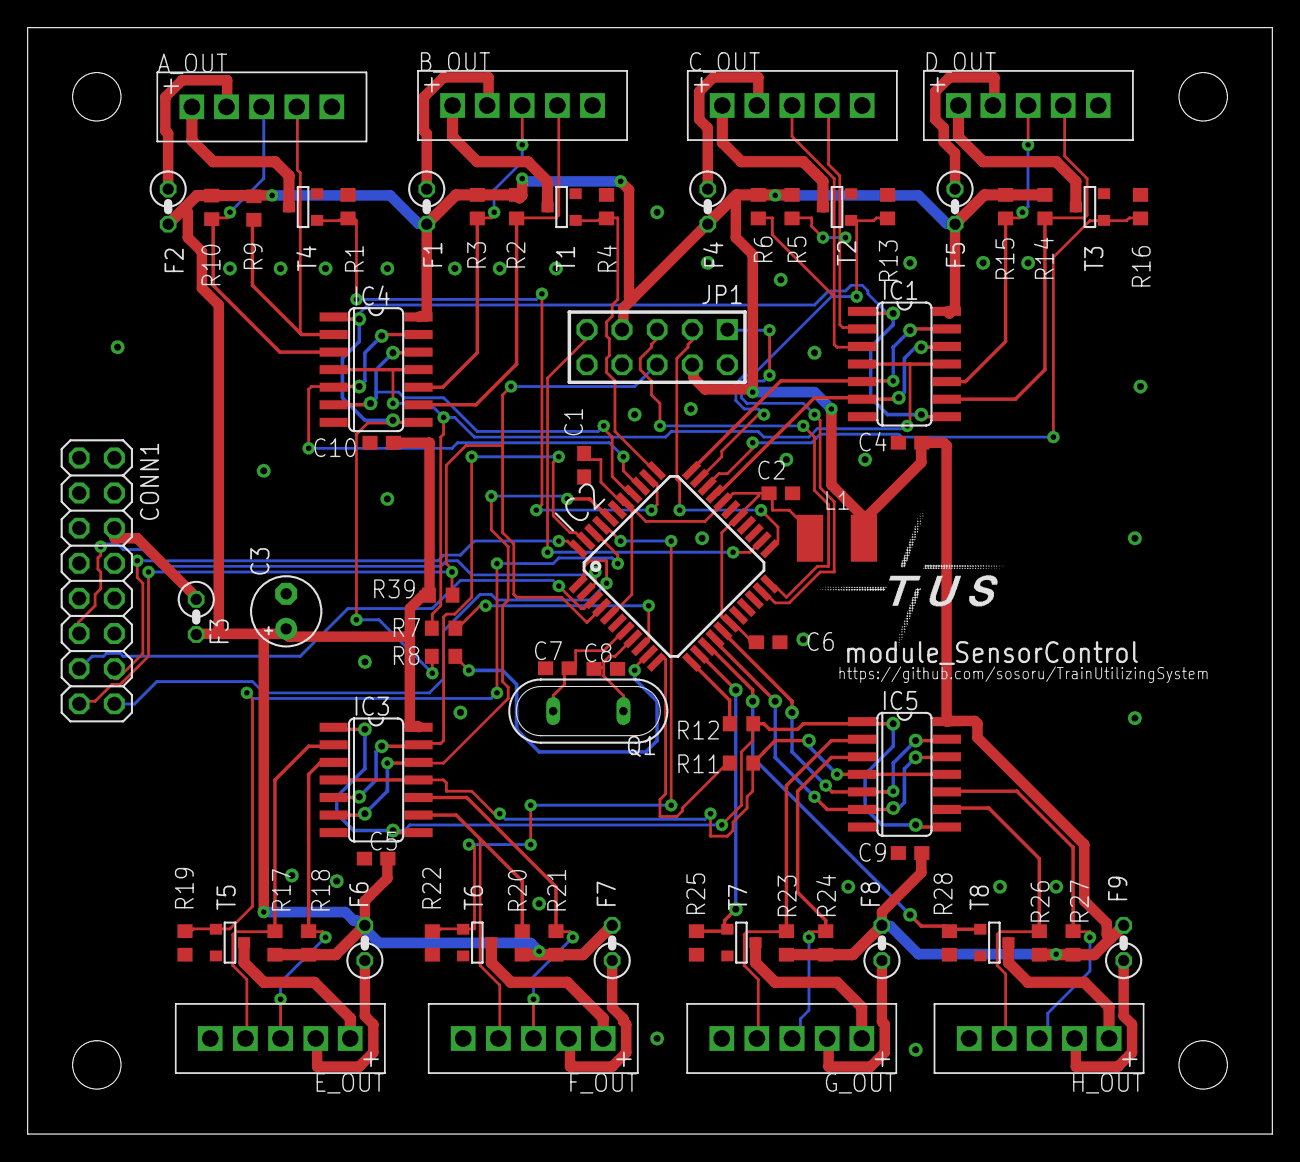
[picture p15: board SensorController_revB.brd from above]

Board: 2 copper layers, 90.0 x 80.0 mm, 73 parts (0 on the bottom side), 71 nets.
