sosoru/TrainUtilizingSystem/Schematics/EthControlling/pikahome.brd

## EAGLE design Schematics/EthControlling/pikahome.brd (2012-10-16)

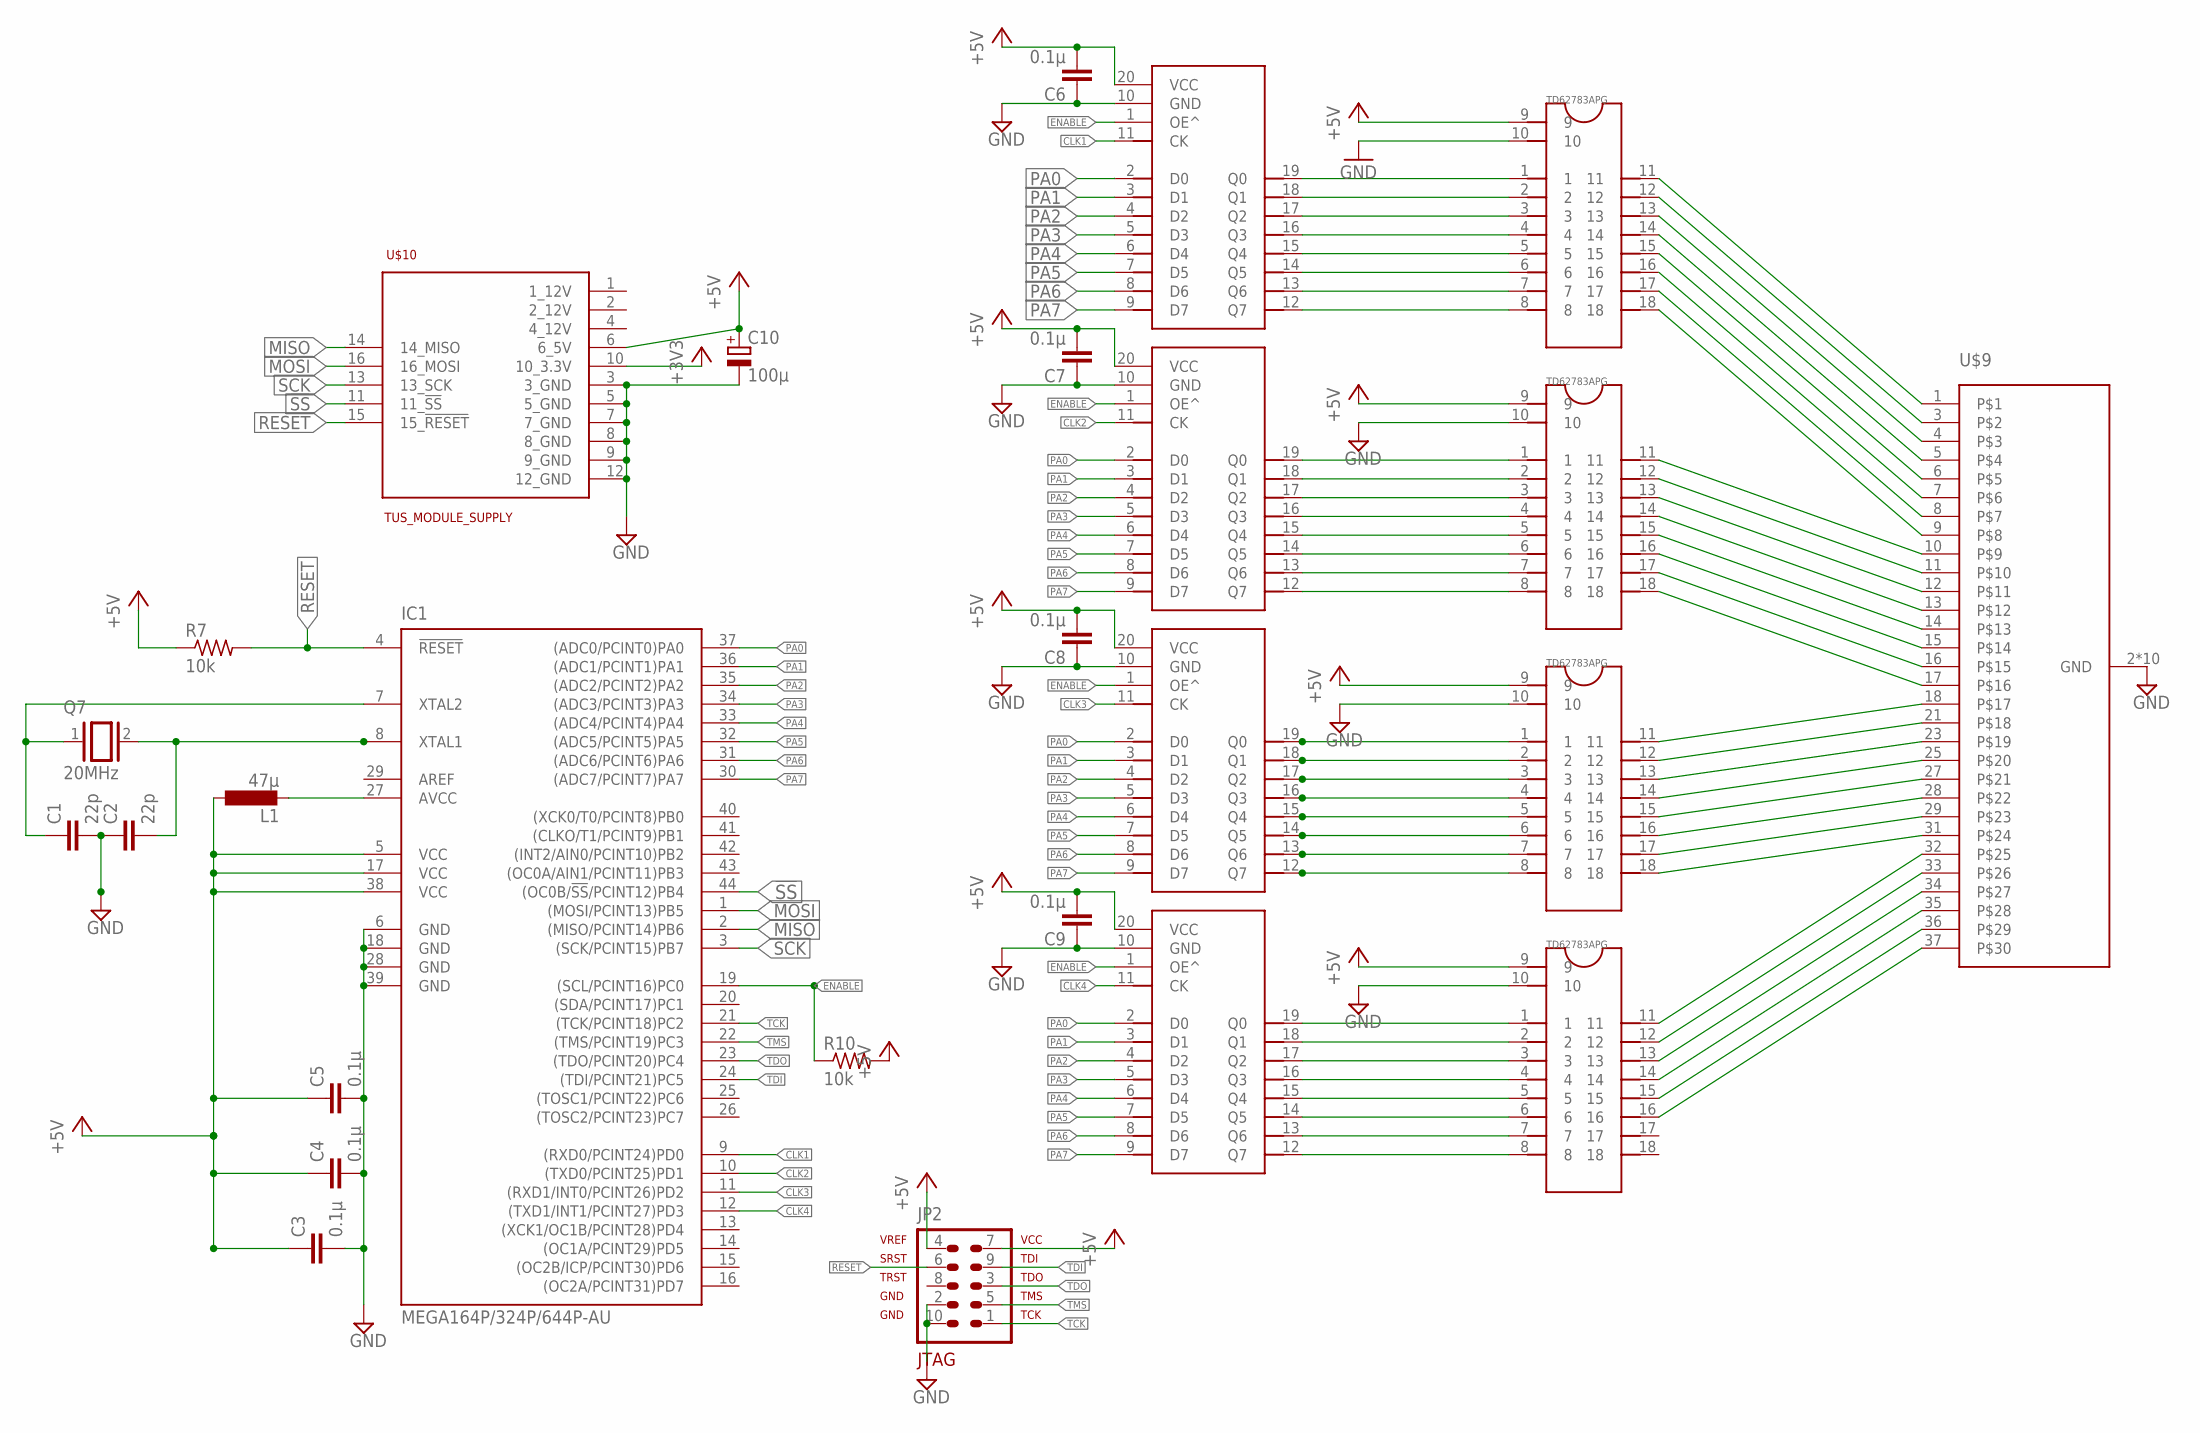
[picture p16: schematic pikahome.sch]

Parts:
C1, C2: 22p; C0603
C3, C4, C5, C6, C7, C8, C9: 0.1μ; C0603
C10: 100μ; TT2D5
IC1: MEGA164P/324P/644P-AU; TQFP44
JP2: AVR-JTAG-10
L1: 47μ; L3216C
Q7: 20MHz; QS
R7, R10: 10k; R0603
U$1, U$2, U$6, U$8: TD62783APG; DIL18
U$3, U$4, U$5, U$7: 74VHC574F; SO20W
U$9: LED_40; PAK100/2500-40
U$10: TUS_MODULE_SUPPLY; 2X08

Connections:
!SS: IC1.44 ((OC0B/!SS!/PCINT12)PB4), U$10.11 (11_!SS)
+3V3: U$10.10 (10_3.3V)
+5V: C3.1, C4.1, C5.1, C6.2, C7.2, C8.2, C9.2, C10.+, IC1.5 (VCC), IC1.17 (VCC), IC1.38 (VCC), JP2.4, JP2.7, L1.1, R7.1, R10.2, U$1.9, U$2.9, U$3.20 (VCC), U$4.20 (VCC), U$5.20 (VCC), U$6.9, U$7.20 (VCC), U$8.9, U$10.6 (6_5V)
AREF: IC1.29 (AREF)
AVCC: IC1.27 (AVCC), L1.2
CLK1: IC1.9 ((RXD0/PCINT24)PD0), U$3.11 (CK)
CLK2: IC1.10 ((TXD0/PCINT25)PD1), U$4.11 (CK)
CLK3: IC1.11 ((RXD1/INT0/PCINT26)PD2), U$5.11 (CK)
CLK4: IC1.12 ((TXD1/INT1/PCINT27)PD3), U$7.11 (CK)
ENABLE: IC1.19 ((SCL/PCINT16)PC0), R10.1, U$3.1 (OE^), U$4.1 (OE^), U$5.1 (OE^), U$7.1 (OE^)
GND: C1.2, C2.1, C3.2, C4.2, C5.2, C6.1, C7.1, C8.1, C9.1, C10.-, IC1.6 (GND), IC1.18 (GND), IC1.28 (GND), IC1.39 (GND), JP2.2, JP2.10, U$1.10, U$2.10, U$3.10 (GND), U$4.10 (GND), U$5.10 (GND), U$6.10, U$7.10 (GND), U$8.10, U$9.2 (GND), U$9.19 (GND), U$9.20 (GND), U$9.22 (GND), U$9.24 (GND), U$9.26 (GND), U$9.30 (GND), U$9.38 (GND), U$9.39 (GND), U$9.40 (GND), U$10.3 (3_GND), U$10.5 (5_GND), U$10.7 (7_GND), U$10.8 (8_GND), U$10.9 (9_GND), U$10.12 (12_GND)
MISO: IC1.2 ((MISO/PCINT14)PB6), U$10.14 (14_MISO)
MOSI: IC1.1 ((MOSI/PCINT13)PB5), U$10.16 (16_MOSI)
unnamed: U$1.1, U$3.19 (Q0)
unnamed: U$1.2, U$3.18 (Q1)
unnamed: U$7.19 (Q0), U$8.1
unnamed: U$1.3, U$3.17 (Q2)
unnamed: U$1.4, U$3.16 (Q3)
unnamed: U$2.8, U$4.12 (Q7)
unnamed: U$7.18 (Q1), U$8.2
unnamed: U$7.17 (Q2), U$8.3
unnamed: U$1.5, U$3.15 (Q4)
unnamed: C1.1, IC1.7 (XTAL2), Q7.1
unnamed: C2.2, IC1.8 (XTAL1), Q7.2
unnamed: U$1.6, U$3.14 (Q5)
unnamed: U$1.7, U$3.13 (Q6)
unnamed: U$2.1, U$4.19 (Q0)
unnamed: U$5.19 (Q0), U$6.1
unnamed: U$1.8, U$3.12 (Q7)
unnamed: U$7.16 (Q3), U$8.4
unnamed: U$7.15 (Q4), U$8.5
unnamed: U$2.2, U$4.18 (Q1)
unnamed: U$5.18 (Q1), U$6.2
unnamed: U$5.17 (Q2), U$6.3
unnamed: U$2.3, U$4.17 (Q2)
unnamed: U$2.4, U$4.16 (Q3)
unnamed: U$5.16 (Q3), U$6.4
unnamed: U$5.15 (Q4), U$6.5
unnamed: U$5.14 (Q5), U$6.6
unnamed: U$5.13 (Q6), U$6.7
unnamed: U$5.12 (Q7), U$6.8
unnamed: U$2.5, U$4.15 (Q4)
unnamed: U$2.6, U$4.14 (Q5)
unnamed: U$2.7, U$4.13 (Q6)
unnamed: U$7.14 (Q5), U$8.6
unnamed: U$7.13 (Q6), U$8.7
unnamed: U$7.12 (Q7), U$8.8
unnamed: U$1.11, U$9.1
unnamed: U$1.12, U$9.3
unnamed: U$1.13, U$9.4
unnamed: U$1.14, U$9.5
unnamed: U$1.15, U$9.6
unnamed: U$1.16, U$9.7
unnamed: U$1.17, U$9.8
unnamed: U$1.18, U$9.9
unnamed: U$2.11, U$9.10
unnamed: U$2.12, U$9.11
unnamed: U$2.13, U$9.12
unnamed: U$2.14, U$9.13
unnamed: U$2.15, U$9.14
unnamed: U$2.16, U$9.15
unnamed: U$2.17, U$9.16
unnamed: U$2.18, U$9.17
unnamed: U$6.11, U$9.18
unnamed: U$6.12, U$9.21
unnamed: U$6.13, U$9.23
unnamed: U$6.14, U$9.25
unnamed: U$6.15, U$9.27
unnamed: U$6.16, U$9.28
unnamed: U$6.17, U$9.29
unnamed: U$6.18, U$9.31
unnamed: U$8.11, U$9.32
unnamed: U$8.12, U$9.33
unnamed: U$8.13, U$9.34
unnamed: U$8.14, U$9.35
unnamed: U$8.15, U$9.36
unnamed: U$8.16, U$9.37
PA0: IC1.37 ((ADC0/PCINT0)PA0), U$3.2 (D0), U$4.2 (D0), U$5.2 (D0), U$7.2 (D0)
PA1: IC1.36 ((ADC1/PCINT1)PA1), U$3.3 (D1), U$4.3 (D1), U$5.3 (D1), U$7.3 (D1)
PA2: IC1.35 ((ADC2/PCINT2)PA2), U$3.4 (D2), U$4.4 (D2), U$5.4 (D2), U$7.4 (D2)
PA3: IC1.34 ((ADC3/PCINT3)PA3), U$3.5 (D3), U$4.5 (D3), U$5.5 (D3), U$7.5 (D3)
PA4: IC1.33 ((ADC4/PCINT4)PA4), U$3.6 (D4), U$4.6 (D4), U$5.6 (D4), U$7.6 (D4)
PA5: IC1.32 ((ADC5/PCINT5)PA5), U$3.7 (D5), U$4.7 (D5), U$5.7 (D5), U$7.7 (D5)
PA6: IC1.31 ((ADC6/PCINT6)PA6), U$3.8 (D6), U$4.8 (D6), U$5.8 (D6), U$7.8 (D6)
PA7: IC1.30 ((ADC7/PCINT7)PA7), U$3.9 (D7), U$4.9 (D7), U$5.9 (D7), U$7.9 (D7)
RESET: IC1.4 (!RESET), JP2.6, R7.2, U$10.15 (15_!RESET)
SCK: IC1.3 ((SCK/PCINT15)PB7), U$10.13 (13_SCK)
TCK: IC1.21 ((TCK/PCINT18)PC2), JP2.1
TDI: IC1.24 ((TDI/PCINT21)PC5), JP2.9
TDO: IC1.23 ((TDO/PCINT20)PC4), JP2.3
TMS: IC1.22 ((TMS/PCINT19)PC3), JP2.5

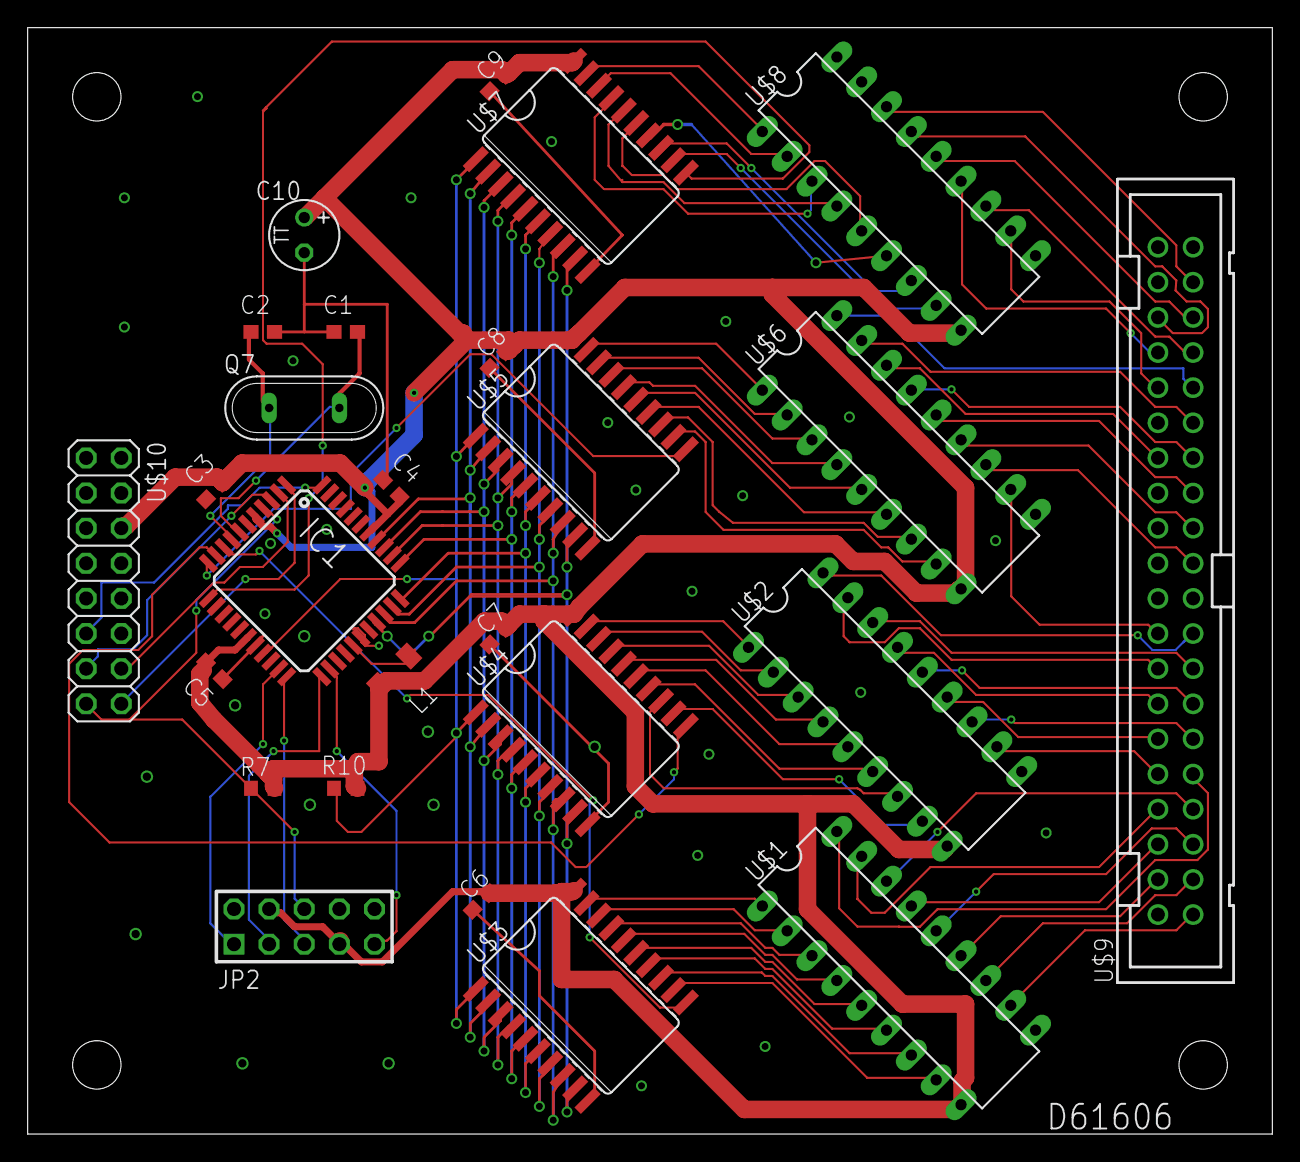
[picture p17: board pikahome.brd from above]

Board: 2 copper layers, 90.0 x 80.0 mm, 26 parts (0 on the bottom side), 89 nets.
