sosoru/TrainUtilizingSystem/Schematics/EthControlling/MotorController.brd

## EAGLE design Schematics/EthControlling/MotorController.brd (2012-10-16)

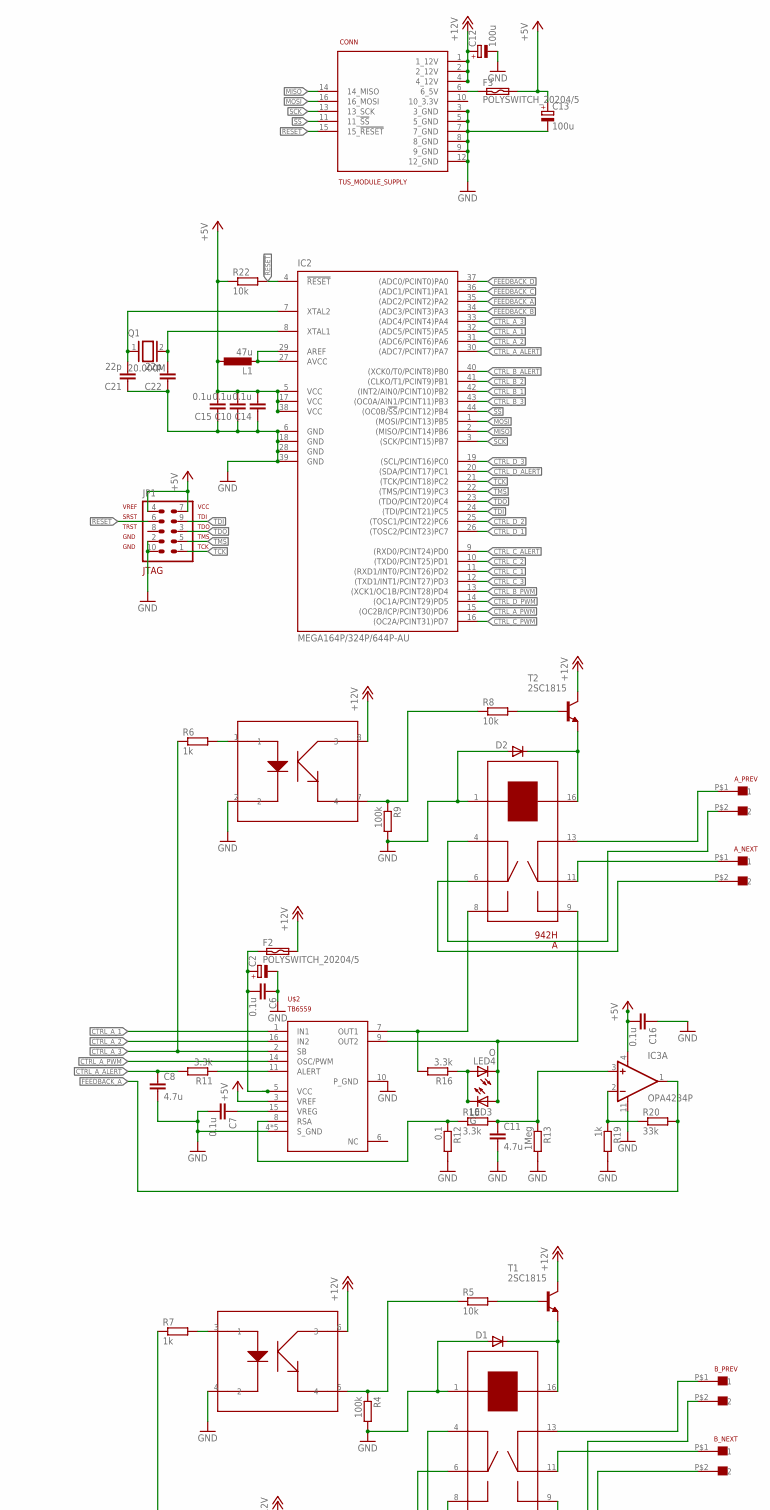
[picture p18: schematic MotorController.sch, part in row 1, column 1]

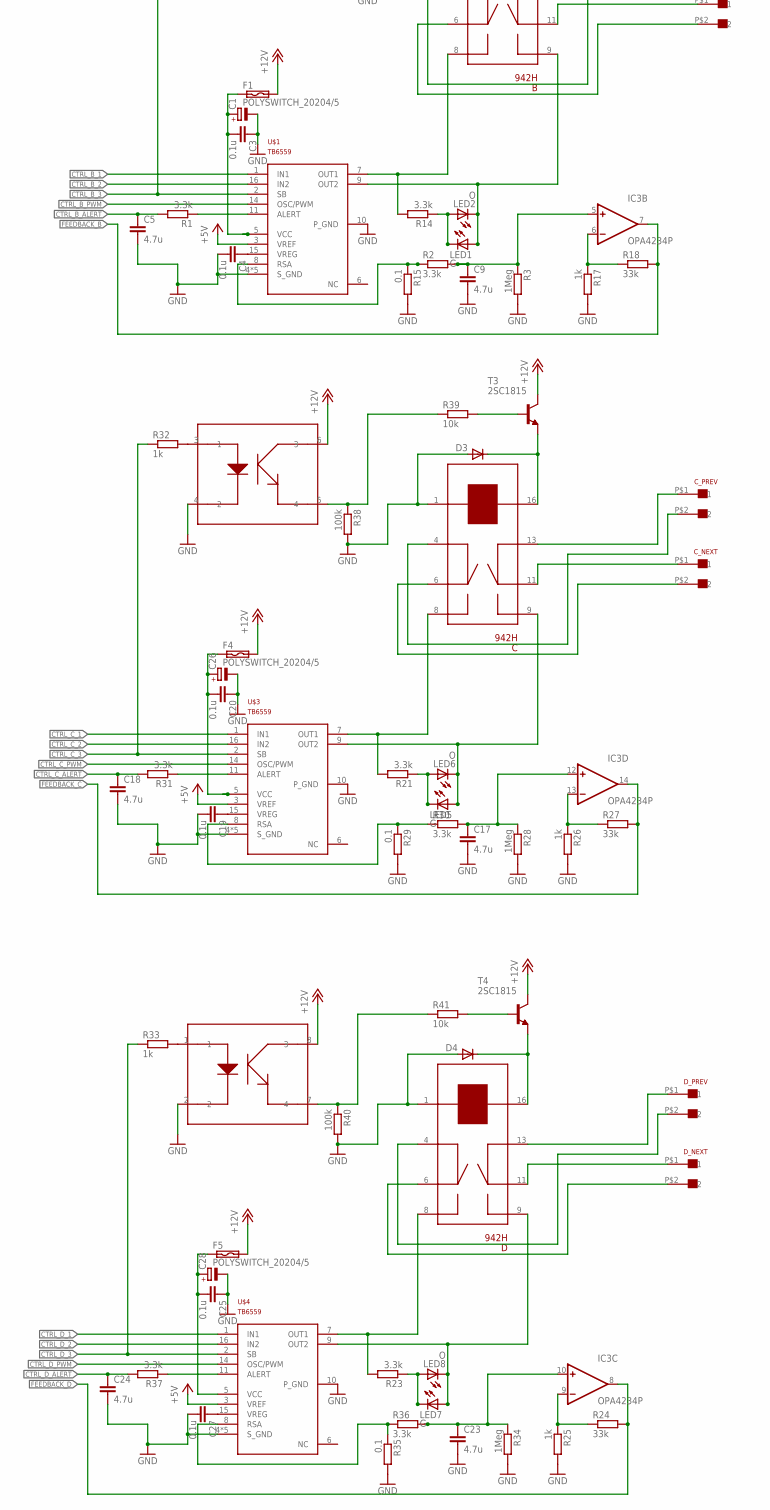
[picture p19: schematic MotorController.sch, part in row 2, column 1]

Parts:
A: 942H; 941H-2C-12D
A_NEXT: XH-2
A_PREV: XH-2
B: 942H; 941H-2C-12D
B_NEXT: XH-2
B_PREV: XH-2
C: 942H; 941H-2C-12D
C1, C2, C26, C28: CPOL-EUE2,5-6E; E2,5-6E
C3, C4, C6, C7, C10, C14, C15, C16, C19, C20, C25, C27: 0.1u; C0603
C5, C8, C9, C11, C17, C18, C23, C24: 4.7u; C0603
C12: 100u; E2,5-6
C13: 100u; E2-5
C21, C22: 22p; C0603
CONN: TUS_MODULE_SUPPLY; 2X08
C_NEXT: XH-2
C_PREV: XH-2
D: 942H; 941H-2C-12D
D1, D2, D3, D4: 1N4148DO35-7; DO35-7
D_NEXT: XH-2
D_PREV: XH-2
F1, F2, F3, F4, F5: POLYSWITCH_20204/5; 0204/5
IC1, IC4: TLP621-2; SOCKET-08
IC2: MEGA164P/324P/644P-AU; TQFP44
IC3: OPA4234P; DIL14
JP1: AVR-JTAG-10
L1: 47u; L3216C
LED1, LED3, LED5, LED7: G; LED3MM
LED2, LED4, LED6, LED8: O; LED3MM
Q1: 20.000M; QS
R1, R2, R10, R11, R14, R16, R21, R23, R30, R31, R36, R37: 3.3k; R0603
R3, R13, R28, R34: 1Meg; R0603
R4, R9, R38, R40: 100k; R0603
R5, R8, R22, R39, R41: 10k; R0603
R6, R7, R17, R19, R25, R26, R32, R33: 1k; R0603
R12, R15, R29, R35: 0.1; R1206
R18, R20, R24, R27: 33k; R0603
T1, T2, T3, T4: 2SC1815; TO92-ECB
U$1, U$2, U$3, U$4: TB6559; HSOP-16

Connections:
!RESET: CONN.15 (15_!RESET), IC2.4 (!RESET), JP1.6, R22.2
!SS: CONN.11 (11_!SS), IC2.44 ((OC0B/!SS!/PCINT12)PB4)
+5V: C10.2, C13.+, C14.2, C15.2, C16.2, F3.2, IC2.5 (VCC), IC2.17 (VCC), IC2.38 (VCC), IC3.4 (V+), JP1.4, JP1.7, L1.1, R22.1, U$1.3 (VREF), U$2.3 (VREF), U$3.3 (VREF), U$4.3 (VREF)
+12V: C12.+, CONN.1 (1_12V), CONN.2 (2_12V), CONN.4 (4_12V), F1.2, F2.2, F4.2, F5.2, IC1.6 (3), IC1.8 (3), IC4.6 (3), IC4.8 (3), T1.C, T2.C, T3.C, T4.C
A_OUT1: A.8 (1), R16.2, U$2.7 (OUT1)
A_OUT2: A.9 ('1), LED3.A, LED4.K (C), U$2.9 (OUT2)
A_OUT3: C.8 (1), R21.2, U$3.7 (OUT1)
A_OUT4: C.9 ('1), LED5.A, LED6.K (C), U$3.9 (OUT2)
A_OUT5: B.8 (1), R14.2, U$1.7 (OUT1)
A_OUT6: B.9 ('1), LED1.A, LED2.K (C), U$1.9 (OUT2)
A_OUT7: D.8 (1), R23.2, U$4.7 (OUT1)
A_OUT8: D.9 ('1), LED7.A, LED8.K (C), U$4.9 (OUT2)
CTRL_A_1: IC2.32 ((ADC5/PCINT5)PA5), U$2.1 (IN1)
CTRL_A_2: IC2.31 ((ADC6/PCINT6)PA6), U$2.16 (IN2)
CTRL_A_3: IC2.33 ((ADC4/PCINT4)PA4), R6.1, U$2.2 (SB)
CTRL_A_ALERT: C8.1, IC2.30 ((ADC7/PCINT7)PA7), R11.2
CTRL_A_PWM: IC2.15 ((OC2B/ICP/PCINT30)PD6), U$2.14 (OSC/PWM)
CTRL_B_1: IC2.42 ((INT2/AIN0/PCINT10)PB2), U$1.1 (IN1)
CTRL_B_2: IC2.41 ((CLKO/T1/PCINT9)PB1), U$1.16 (IN2)
CTRL_B_3: IC2.43 ((OC0A/AIN1/PCINT11)PB3), R7.1, U$1.2 (SB)
CTRL_B_ALERT: C5.1, IC2.40 ((XCK0/T0/PCINT8)PB0), R1.2
CTRL_B_PWM: IC2.13 ((XCK1/OC1B/PCINT28)PD4), U$1.14 (OSC/PWM)
CTRL_C_1: IC2.11 ((RXD1/INT0/PCINT26)PD2), U$3.1 (IN1)
CTRL_C_2: IC2.10 ((TXD0/PCINT25)PD1), U$3.16 (IN2)
CTRL_C_3: IC2.12 ((TXD1/INT1/PCINT27)PD3), R32.1, U$3.2 (SB)
CTRL_C_ALERT: C18.1, IC2.9 ((RXD0/PCINT24)PD0), R31.2
CTRL_C_PWM: IC2.16 ((OC2A/PCINT31)PD7), U$3.14 (OSC/PWM)
CTRL_D_1: IC2.26 ((TOSC2/PCINT23)PC7), U$4.1 (IN1)
CTRL_D_2: IC2.25 ((TOSC1/PCINT22)PC6), U$4.16 (IN2)
CTRL_D_3: IC2.19 ((SCL/PCINT16)PC0), R33.1, U$4.2 (SB)
CTRL_D_ALERT: C24.1, IC2.20 ((SDA/PCINT17)PC1), R37.2
CTRL_D_PWM: IC2.14 ((OC1A/PCINT29)PD5), U$4.14 (OSC/PWM)
D: D.4 (3), D_PREV.P$2 (2)
FEEDBACK_A: IC2.35 ((ADC2/PCINT2)PA2), IC3.1 (OUT), R20.2
FEEDBACK_B: IC2.34 ((ADC3/PCINT3)PA3), IC3.7 (OUT), R18.2
FEEDBACK_C: IC2.36 ((ADC1/PCINT1)PA1), IC3.14 (OUT), R27.2
FEEDBACK_D: IC2.37 ((ADC0/PCINT0)PA0), IC3.8 (OUT), R24.2
GND: A.1 (4), B.1 (4), C.1 (4), C1.-, C2.-, C3.1, C4.2, C5.2, C6.1, C7.2, C8.2, C9.2, C10.1, C11.2, C12.-, C13.-, C14.1, C15.1, C16.1, C17.2, C18.2, C19.2, C20.1, C21.1, C22.1, C23.2, C24.2, C25.1, C26.-, C27.2, C28.-, CONN.3 (3_GND), CONN.5 (5_GND), CONN.7 (7_GND), CONN.8 (8_GND), CONN.9 (9_GND), CONN.12 (12_GND), D.1 (4), D1.A, D2.A, D3.A, D4.A, IC1.2, IC1.4 (2), IC2.6 (GND), IC2.18 (GND), IC2.28 (GND), IC2.39 (GND), IC3.11 (V-), IC4.2, IC4.4 (2), JP1.2, JP1.10, R3.2, R4.2, R9.2, R12.2, R13.2, R15.2, R17.2, R19.2, R25.2, R26.2, R28.2, R29.2, R34.2, R35.2, R38.2, R40.2, U$1.4 (S_GND), U$1.10 (P_GND), U$1.12 (S_GND), U$1.13 (S_GND), U$1.FIN_1 (S_GND), U$1.FIN_2 (S_GND), U$2.4 (S_GND), U$2.10 (P_GND), U$2.12 (S_GND), U$2.13 (S_GND), U$2.FIN_1 (S_GND), U$2.FIN_2 (S_GND), U$3.4 (S_GND), U$3.10 (P_GND), U$3.12 (S_GND), U$3.13 (S_GND), U$3.FIN_1 (S_GND), U$3.FIN_2 (S_GND), U$4.4 (S_GND), U$4.10 (P_GND), U$4.12 (S_GND), U$4.13 (S_GND), U$4.FIN_1 (S_GND), U$4.FIN_2 (S_GND)
MISO: CONN.14 (14_MISO), IC2.2 ((MISO/PCINT14)PB6)
MOSI: CONN.16 (16_MOSI), IC2.1 ((MOSI/PCINT13)PB5)
unnamed: IC2.27 (AVCC), IC2.29 (AREF), L1.2
unnamed: C21.2, IC2.7 (XTAL2), Q1.1
unnamed: C22.2, IC2.8 (XTAL1), Q1.2
unnamed: R11.1, U$2.11 (ALERT)
unnamed: C7.1, U$2.15 (VREG)
unnamed: IC1.1, R6.2
unnamed: IC1.7 (4), R8.1, R9.1
unnamed: LED3.K (C), LED4.A, R16.1
unnamed: C19.1, U$3.15 (VREG)
unnamed: C2.+, C6.2, F2.1, U$2.5 (VCC)
unnamed: IC3.2 (-IN), R19.1, R20.1
unnamed: R31.1, U$3.11 (ALERT)
unnamed: A.6 (2), A_NEXT.P$2 (2)
unnamed: R10.1, R12.1, U$2.8 (RSA)
unnamed: A.11 ('2), A_NEXT.P$1 (1)
unnamed: A.4 (3), A_PREV.P$2 (2)
unnamed: A.13 ('3), A_PREV.P$1 (1)
unnamed: C20.2, C26.+, F4.1, U$3.5 (VCC)
unnamed: LED5.K (C), LED6.A, R21.1
unnamed: IC1.3 (1), R7.2
unnamed: C11.1, IC3.3 (+IN), R10.2, R13.1
unnamed: C.6 (2), C_NEXT.P$2 (2)
unnamed: C.11 ('2), C_NEXT.P$1 (1)
unnamed: C.4 (3), C_PREV.P$2 (2)
unnamed: C.13 ('3), C_PREV.P$1 (1)
unnamed: IC4.5 (4), R38.1, R39.1
unnamed: C.16 ('4), D3.C, T3.E
unnamed: R39.2, T3.B
unnamed: IC3.13 (-IN), R26.1, R27.1
unnamed: C17.1, IC3.12 (+IN), R28.1, R30.2
unnamed: R29.1, R30.1, U$3.8 (RSA)
unnamed: C4.1, U$1.15 (VREG)
unnamed: R1.1, U$1.11 (ALERT)
unnamed: C1.+, C3.2, F1.1, U$1.5 (VCC)
unnamed: LED1.K (C), LED2.A, R14.1
unnamed: IC4.1, R33.2
unnamed: B.6 (2), B_NEXT.P$2 (2)
unnamed: B.11 ('2), B_NEXT.P$1 (1)
unnamed: B.4 (3), B_PREV.P$2 (2)
unnamed: B.13 ('3), B_PREV.P$1 (1)
unnamed: IC1.5 (4), R4.1, R5.1
unnamed: B.16 ('4), D1.C, T1.E
unnamed: R5.2, T1.B
unnamed: IC3.6 (-IN), R17.1, R18.1
unnamed: C9.1, IC3.5 (+IN), R2.2, R3.1
unnamed: R2.1, R15.1, U$1.8 (RSA)
unnamed: C27.1, U$4.15 (VREG)
unnamed: R37.1, U$4.11 (ALERT)
unnamed: C25.2, C28.+, F5.1, U$4.5 (VCC)
unnamed: LED7.K (C), LED8.A, R23.1
unnamed: IC4.3 (1), R32.2
unnamed: D.6 (2), D_NEXT.P$2 (2)
unnamed: D.11 ('2), D_NEXT.P$1 (1)
unnamed: CONN.6 (6_5V), F3.1
unnamed: D.13 ('3), D_PREV.P$1 (1)
unnamed: IC4.7 (4), R40.1, R41.1
unnamed: D.16 ('4), D4.C, T4.E
unnamed: R41.2, T4.B
unnamed: IC3.9 (-IN), R24.1, R25.1
unnamed: C23.1, IC3.10 (+IN), R34.1, R36.2
unnamed: R35.1, R36.1, U$4.8 (RSA)
unnamed: A.16 ('4), D2.C, T2.E
unnamed: R8.2, T2.B
SCK: CONN.13 (13_SCK), IC2.3 ((SCK/PCINT15)PB7)
TCK: IC2.21 ((TCK/PCINT18)PC2), JP1.1
TDI: IC2.24 ((TDI/PCINT21)PC5), JP1.9
TDO: IC2.23 ((TDO/PCINT20)PC4), JP1.3
TMS: IC2.22 ((TMS/PCINT19)PC3), JP1.5

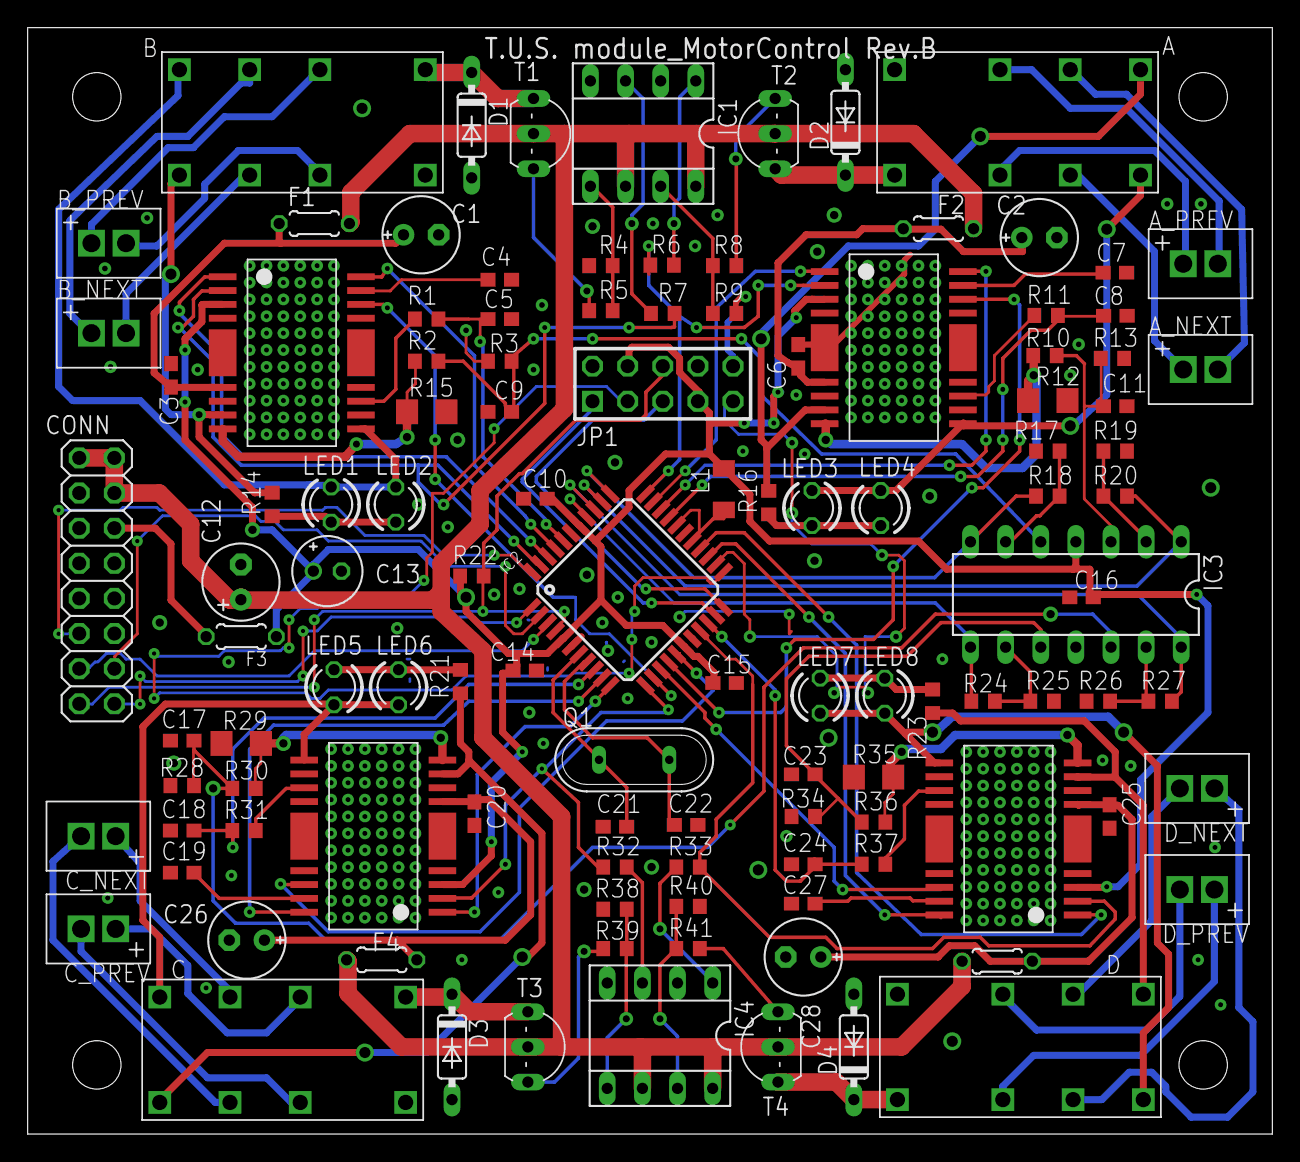
[picture p20: board MotorController.brd from above]

Board: 2 copper layers, 90.0 x 80.0 mm, 114 parts (0 on the bottom side), 108 nets.
