sosoru/TrainUtilizingSystem/Schematics/EthControlling/EmergencySwitch.brd

## EAGLE design Schematics/EthControlling/EmergencySwitch.brd (2012-10-16)

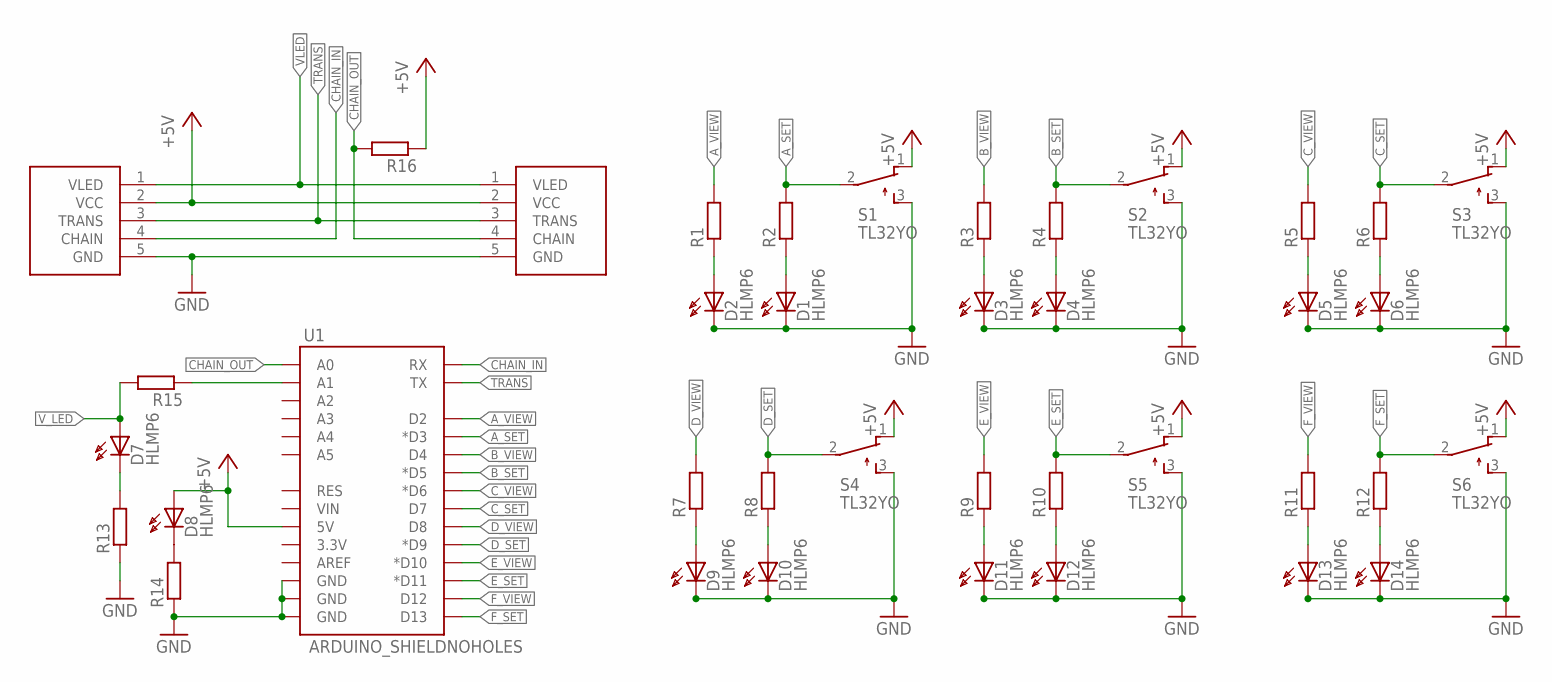
[picture p21: schematic EmergencySwitch.sch]

Parts:
CONN_IN: SERIAL_SENSORXH; XH-5
CONN_OUT: SERIAL_SENSORXH; XH-5
D1, D4, D6, D10, D12, D14: HLMP6
D2, D3, D5, D7, D8, D9, D11, D13: HLMP6; MPN HLMP-6500
R1, R2, R3, R4, R5, R6, R7, R8, R9, R10, R11, R12, R13, R14, R15, R16: R-EU_R0603; R0603
S1, S2, S3, S4, S5, S6: TL32YO; TL3XYO
U1: ARDUINO_SHIELDNOHOLES; DUEMILANOVE_SHIELD_NOHOLES

Connections:
+5V: CONN_IN.2 (VCC), CONN_OUT.2 (VCC), D8.A, R16.1, S1.1 (O), S2.1 (O), S3.1 (O), S4.1 (O), S5.1 (O), S6.1 (O), U1.5V
A_SET: R2.2, S1.2, U1.D3 (*D3)
A_VIEW: R1.2, U1.D2
B_SET: R4.2, S2.2, U1.D5 (*D5)
B_VIEW: R3.2, U1.D4
CHAIN_IN: CONN_IN.4 (CHAIN), U1.RX
CHAIN_OUT: CONN_OUT.4 (CHAIN), R16.2, U1.A0
C_SET: R6.2, S3.2, U1.D7
C_VIEW: R5.2, U1.D6 (*D6)
D_SET: R8.2, S4.2, U1.D9 (*D9)
D_VIEW: R7.2, U1.D8
E_SET: R10.2, S5.2, U1.D11 (*D11)
E_VIEW: R9.2, U1.D10 (*D10)
F_SET: R12.2, S6.2, U1.D13
F_VIEW: R11.2, U1.D12
GND: CONN_IN.5 (GND), CONN_OUT.5 (GND), D1.K, D2.K, D3.K, D4.K, D5.K, D6.K, D9.K, D10.K, D11.K, D12.K, D13.K, D14.K, R13.1, R14.1, S1.3 (S), S2.3 (S), S3.3 (S), S4.3 (S), S5.3 (S), S6.3 (S), U1.GND@0 (GND), U1.GND@1 (GND), U1.GND@2 (GND)
unnamed: D7.K, R13.2
unnamed: D8.K, R14.2
unnamed: D1.A, R2.1
unnamed: D4.A, R4.1
unnamed: D3.A, R3.1
unnamed: D6.A, R6.1
unnamed: D2.A, R1.1
unnamed: D5.A, R5.1
unnamed: D10.A, R8.1
unnamed: D9.A, R7.1
unnamed: D12.A, R10.1
unnamed: D11.A, R9.1
unnamed: D14.A, R12.1
unnamed: D13.A, R11.1
unnamed: R15.1, U1.A1
TRANS: CONN_IN.3 (TRANS), CONN_OUT.3 (TRANS), U1.TX
VLED: CONN_IN.1 (VLED), CONN_OUT.1 (VLED)
V_LED: D7.A, R15.2

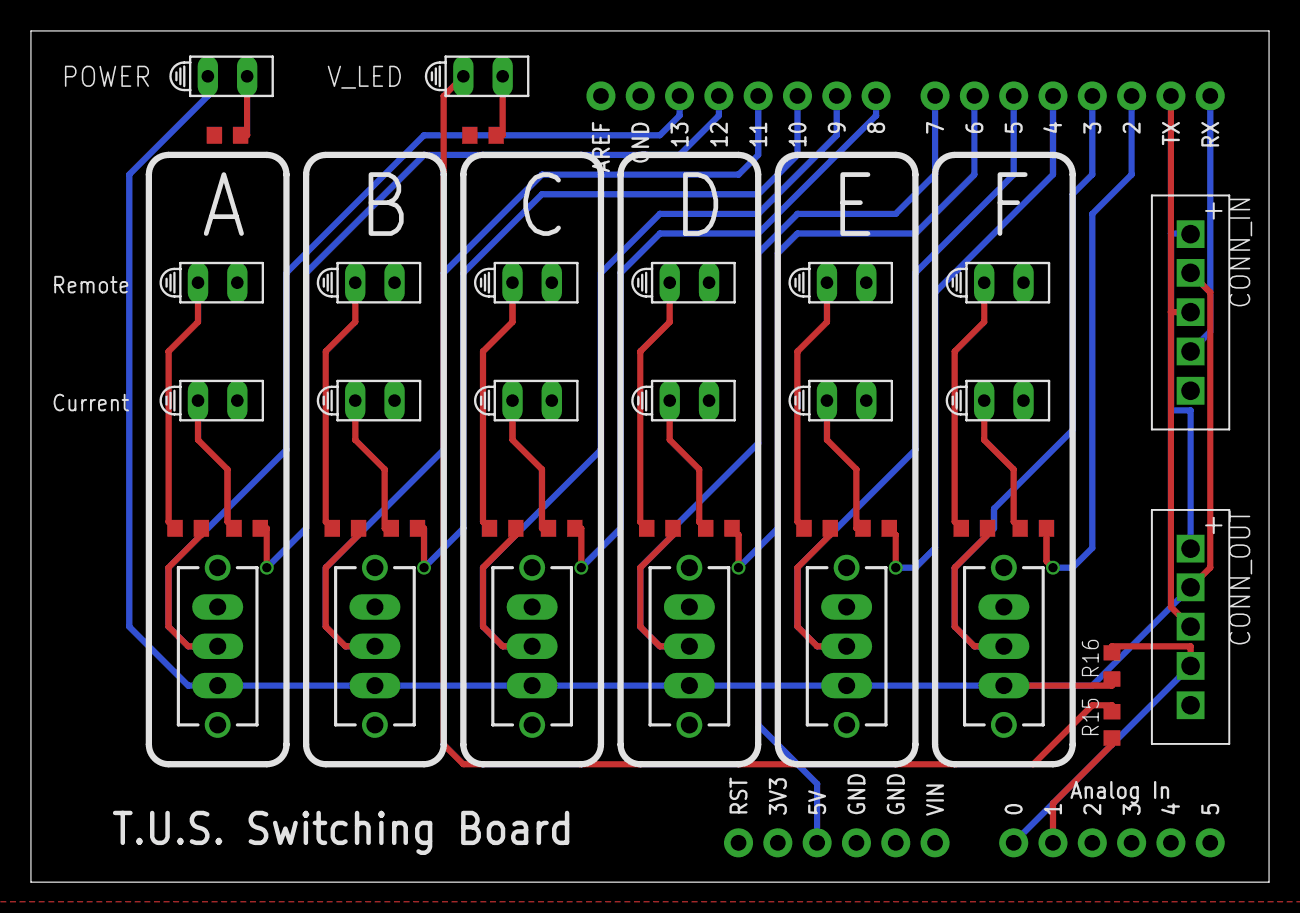
[picture p22: board EmergencySwitch.brd from above]

Board: 2 copper layers, 80.0 x 55.0 mm, 39 parts (0 on the bottom side), 34 nets.
