sosoru/TrainUtilizingSystem/Schematics/EthControlling/EthernetBridge.brd

## EAGLE design Schematics/EthControlling/EthernetBridge.brd (2012-10-16)

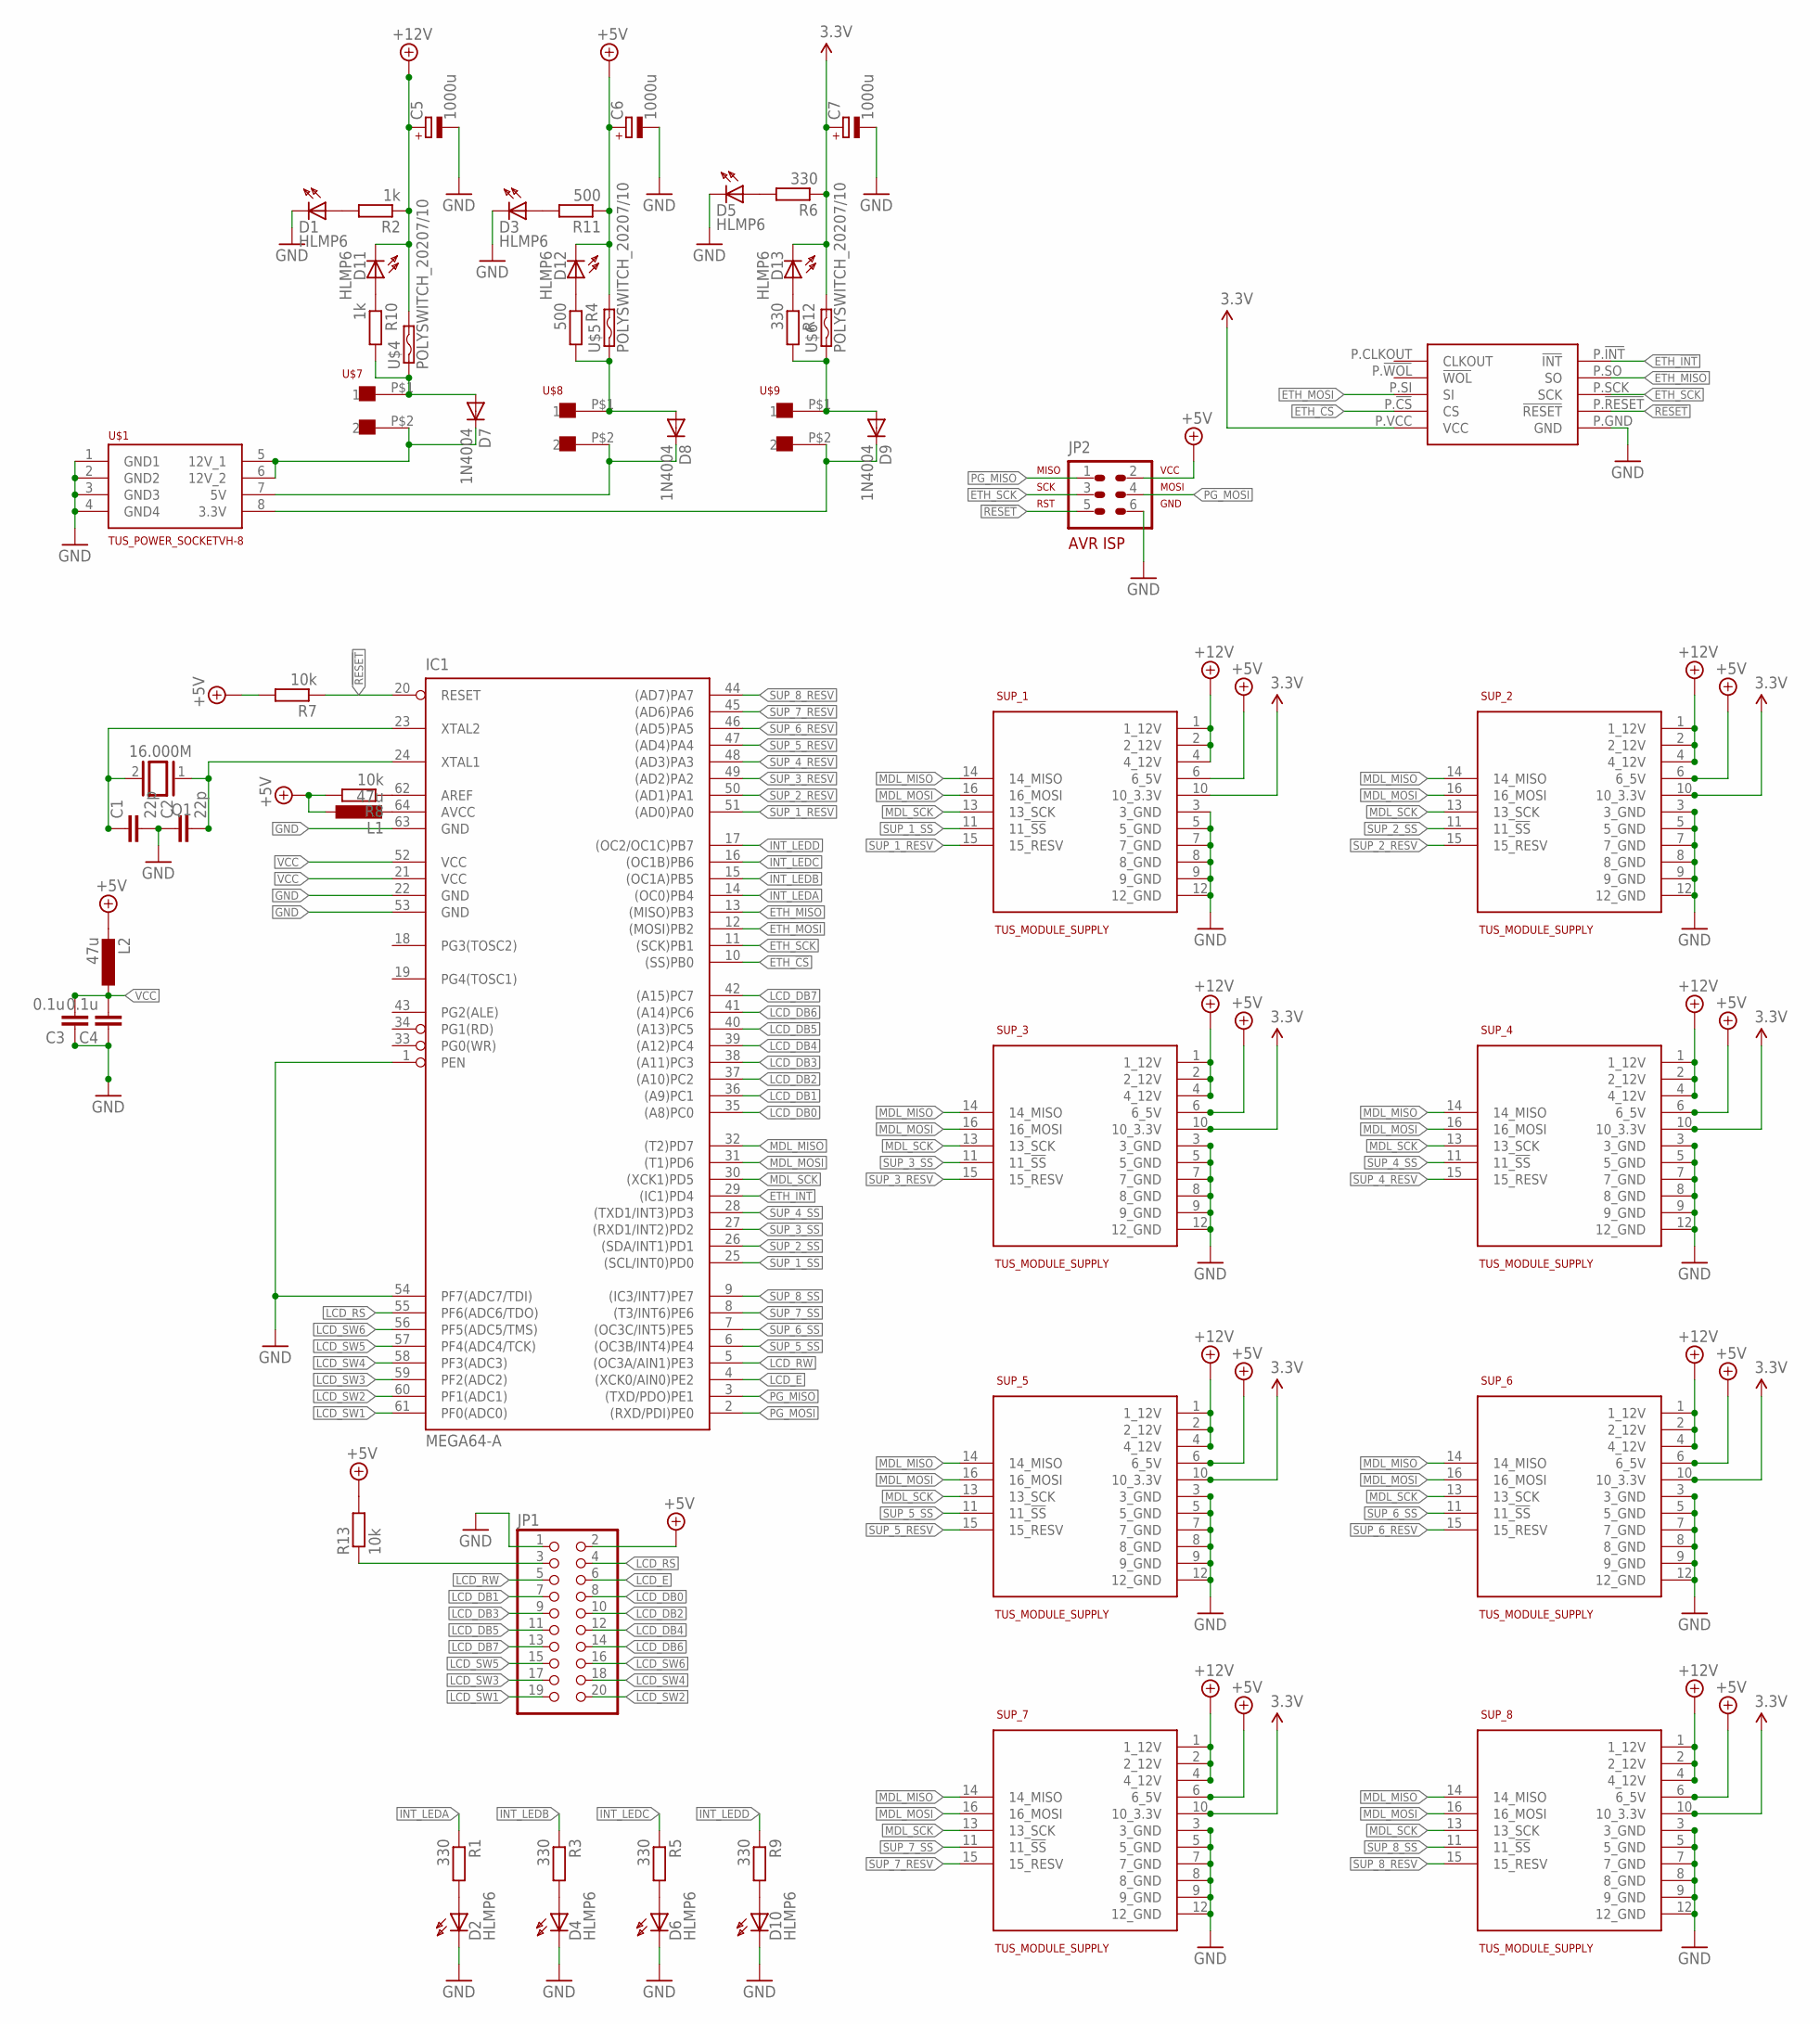
[picture p23: schematic EthernetBridge.sch]

Parts:
C1, C2: 22p; C2.5-3
C3, C4: 0.1u; C2.5-3
C5, C6, C7: 1000u; E5-10,5
D1, D2, D3, D4, D5, D6, D10, D11, D12, D13: HLMP6
D7, D8, D9: 1N4004; DO41-10
IC1: MEGA64-A; TQFP64
JP1: PINHD-2X10; 2X10
JP2: AVR-ISP-6VERT; AVR-ISP-6
L1, L2: 47u; 0204/7
Q1: 16.000M; QS
R1, R3, R5, R6, R9, R12: 330; 0204/7
R2, R10: 1k; 0204/7
R4, R11: 500; 0204/7
R7, R8, R13: 10k; 0204/7
SUP_1, SUP_2, SUP_3, SUP_4, SUP_5, SUP_6, SUP_7, SUP_8: TUS_MODULE_SUPPLY; 2X08
U$1: TUS_POWER_SOCKETVH-8; VH_8
U$2: AITENDO_ENC28J60
U$4, U$5, U$6: POLYSWITCH_20207/10; 0207/10
U$7, U$8, U$9: VH-2

Connections:
3.3V: C7.+, D13.K, R6.1, SUP_1.10 (10_3.3V), SUP_2.10 (10_3.3V), SUP_3.10 (10_3.3V), SUP_4.10 (10_3.3V), SUP_5.10 (10_3.3V), SUP_6.10 (10_3.3V), SUP_7.10 (10_3.3V), SUP_8.10 (10_3.3V), U$2.P.VCC (VCC), U$6.2
!RESET: IC1.20 (RESET), JP2.5, R7.1, U$2.P.!RESET (!RESET)
+5V: C6.+, D12.K, JP1.2, JP2.2, L1.1, L2.2, R7.2, R8.2, R11.1, R13.2, SUP_1.6 (6_5V), SUP_2.6 (6_5V), SUP_3.6 (6_5V), SUP_4.6 (6_5V), SUP_5.6 (6_5V), SUP_6.6 (6_5V), SUP_7.6 (6_5V), SUP_8.6 (6_5V), U$5.2
+12V: C5.+, D11.K, R2.1, SUP_1.1 (1_12V), SUP_1.2 (2_12V), SUP_1.4 (4_12V), SUP_2.1 (1_12V), SUP_2.2 (2_12V), SUP_2.4 (4_12V), SUP_3.1 (1_12V), SUP_3.2 (2_12V), SUP_3.4 (4_12V), SUP_4.1 (1_12V), SUP_4.2 (2_12V), SUP_4.4 (4_12V), SUP_5.1 (1_12V), SUP_5.2 (2_12V), SUP_5.4 (4_12V), SUP_6.1 (1_12V), SUP_6.2 (2_12V), SUP_6.4 (4_12V), SUP_7.1 (1_12V), SUP_7.2 (2_12V), SUP_7.4 (4_12V), SUP_8.1 (1_12V), SUP_8.2 (2_12V), SUP_8.4 (4_12V), U$4.2
ETH_!CS: IC1.10 ((SS)PB0), U$2.P.!CS (CS)
ETH_!INT: IC1.29 ((IC1)PD4), U$2.P.!INT (!INT)
ETH_MISO: IC1.13 ((MISO)PB3), U$2.P.SO (SO)
ETH_MOSI: IC1.12 ((MOSI)PB2), U$2.P.SI (SI)
ETH_SCK: IC1.11 ((SCK)PB1), JP2.3, U$2.P.SCK (SCK)
GND: C1.2, C2.1, C3.1, C4.1, C5.-, C6.-, C7.-, D1.K, D2.K, D3.K, D4.K, D5.K, D6.K, D10.K, IC1.1 (PEN), IC1.22 (GND), IC1.53 (GND), IC1.54 (PF7(ADC7/TDI)), IC1.63 (GND), JP1.1, JP2.6, SUP_1.3 (3_GND), SUP_1.5 (5_GND), SUP_1.7 (7_GND), SUP_1.8 (8_GND), SUP_1.9 (9_GND), SUP_1.12 (12_GND), SUP_2.3 (3_GND), SUP_2.5 (5_GND), SUP_2.7 (7_GND), SUP_2.8 (8_GND), SUP_2.9 (9_GND), SUP_2.12 (12_GND), SUP_3.3 (3_GND), SUP_3.5 (5_GND), SUP_3.7 (7_GND), SUP_3.8 (8_GND), SUP_3.9 (9_GND), SUP_3.12 (12_GND), SUP_4.3 (3_GND), SUP_4.5 (5_GND), SUP_4.7 (7_GND), SUP_4.8 (8_GND), SUP_4.9 (9_GND), SUP_4.12 (12_GND), SUP_5.3 (3_GND), SUP_5.5 (5_GND), SUP_5.7 (7_GND), SUP_5.8 (8_GND), SUP_5.9 (9_GND), SUP_5.12 (12_GND), SUP_6.3 (3_GND), SUP_6.5 (5_GND), SUP_6.7 (7_GND), SUP_6.8 (8_GND), SUP_6.9 (9_GND), SUP_6.12 (12_GND), SUP_7.3 (3_GND), SUP_7.5 (5_GND), SUP_7.7 (7_GND), SUP_7.8 (8_GND), SUP_7.9 (9_GND), SUP_7.12 (12_GND), SUP_8.3 (3_GND), SUP_8.5 (5_GND), SUP_8.7 (7_GND), SUP_8.8 (8_GND), SUP_8.9 (9_GND), SUP_8.12 (12_GND), U$1.1 (GND1), U$1.2 (GND2), U$1.3 (GND3), U$1.4 (GND4), U$2.P.GND (GND)
INT_LEDA: IC1.14 ((OC0)PB4), R1.1
INT_LEDB: IC1.15 ((OC1A)PB5), R3.1
INT_LEDC: IC1.16 ((OC1B)PB6), R5.1
INT_LEDD: IC1.17 ((OC2/OC1C)PB7), R9.1
LCD_DB0: IC1.35 ((A8)PC0), JP1.8
LCD_DB1: IC1.36 ((A9)PC1), JP1.7
LCD_DB2: IC1.37 ((A10)PC2), JP1.10
LCD_DB3: IC1.38 ((A11)PC3), JP1.9
LCD_DB4: IC1.39 ((A12)PC4), JP1.12
LCD_DB5: IC1.40 ((A13)PC5), JP1.11
LCD_DB6: IC1.41 ((A14)PC6), JP1.14
LCD_DB7: IC1.42 ((A15)PC7), JP1.13
LCD_E: IC1.4 ((XCK0/AIN0)PE2), JP1.6
LCD_RS: IC1.55 (PF6(ADC6/TDO)), JP1.4
LCD_RW: IC1.5 ((OC3A/AIN1)PE3), JP1.5
LCD_SW1: IC1.61 (PF0(ADC0)), JP1.19
LCD_SW2: IC1.60 (PF1(ADC1)), JP1.20
LCD_SW3: IC1.59 (PF2(ADC2)), JP1.17
LCD_SW4: IC1.58 (PF3(ADC3)), JP1.18
LCD_SW5: IC1.57 (PF4(ADC4/TCK)), JP1.15
LCD_SW6: IC1.56 (PF5(ADC5/TMS)), JP1.16
LCD_VO: JP1.3, R13.1
MDL_MISO: IC1.32 ((T2)PD7), SUP_1.14 (14_MISO), SUP_2.14 (14_MISO), SUP_3.14 (14_MISO), SUP_4.14 (14_MISO), SUP_5.14 (14_MISO), SUP_6.14 (14_MISO), SUP_7.14 (14_MISO), SUP_8.14 (14_MISO)
MDL_MOSI: IC1.31 ((T1)PD6), SUP_1.16 (16_MOSI), SUP_2.16 (16_MOSI), SUP_3.16 (16_MOSI), SUP_4.16 (16_MOSI), SUP_5.16 (16_MOSI), SUP_6.16 (16_MOSI), SUP_7.16 (16_MOSI), SUP_8.16 (16_MOSI)
MDL_SCK: IC1.30 ((XCK1)PD5), SUP_1.13 (13_SCK), SUP_2.13 (13_SCK), SUP_3.13 (13_SCK), SUP_4.13 (13_SCK), SUP_5.13 (13_SCK), SUP_6.13 (13_SCK), SUP_7.13 (13_SCK), SUP_8.13 (13_SCK)
unnamed: IC1.64 (AVCC), L1.2
unnamed: D1.A, R2.2
unnamed: D2.A, R1.2
unnamed: D4.A, R3.2
unnamed: D8.A, R4.2, U$5.1, U$8.P$1 (1)
unnamed: D9.C, U$1.8 (3.3V), U$9.P$2 (2)
unnamed: D6.A, R5.2
unnamed: D5.A, R6.2
unnamed: C2.2, IC1.24 (XTAL1), Q1.1
unnamed: D10.A, R9.2
unnamed: C1.1, IC1.23 (XTAL2), Q1.2
unnamed: IC1.62 (AREF), R8.1
unnamed: D7.A, R10.2, U$4.1, U$7.P$1 (1)
unnamed: D11.A, R10.1
unnamed: D3.A, R11.2
unnamed: D12.A, R4.1
unnamed: D13.A, R12.1
unnamed: D9.A, R12.2, U$6.1, U$9.P$1 (1)
unnamed: D7.C, U$1.5 (12V_1), U$1.6 (12V_2), U$7.P$2 (2)
unnamed: D8.C, U$1.7 (5V), U$8.P$2 (2)
PG_MISO: IC1.3 ((TXD/PDO)PE1), JP2.1
PG_MOSI: IC1.2 ((RXD/PDI)PE0), JP2.4
SUP_1_RESV: IC1.51 ((AD0)PA0), SUP_1.15 (15_RESV)
SUP_1_SS: IC1.25 ((SCL/INT0)PD0), SUP_1.11 (11_!SS)
SUP_2_RESV: IC1.50 ((AD1)PA1), SUP_2.15 (15_RESV)
SUP_2_SS: IC1.26 ((SDA/INT1)PD1), SUP_2.11 (11_!SS)
SUP_3_RESV: IC1.49 ((AD2)PA2), SUP_3.15 (15_RESV)
SUP_3_SS: IC1.27 ((RXD1/INT2)PD2), SUP_3.11 (11_!SS)
SUP_4_RESV: IC1.48 ((AD3)PA3), SUP_4.15 (15_RESV)
SUP_4_SS: IC1.28 ((TXD1/INT3)PD3), SUP_4.11 (11_!SS)
SUP_5_RESV: IC1.47 ((AD4)PA4), SUP_5.15 (15_RESV)
SUP_5_SS: IC1.6 ((OC3B/INT4)PE4), SUP_5.11 (11_!SS)
SUP_6_RESV: IC1.46 ((AD5)PA5), SUP_6.15 (15_RESV)
SUP_6_SS: IC1.7 ((OC3C/INT5)PE5), SUP_6.11 (11_!SS)
SUP_7_RESV: IC1.45 ((AD6)PA6), SUP_7.15 (15_RESV)
SUP_7_SS: IC1.8 ((T3/INT6)PE6), SUP_7.11 (11_!SS)
SUP_8_RESV: IC1.44 ((AD7)PA7), SUP_8.15 (15_RESV)
SUP_8_SS: IC1.9 ((IC3/INT7)PE7), SUP_8.11 (11_!SS)
VCC: C3.2, C4.2, IC1.21 (VCC), IC1.52 (VCC), L2.1

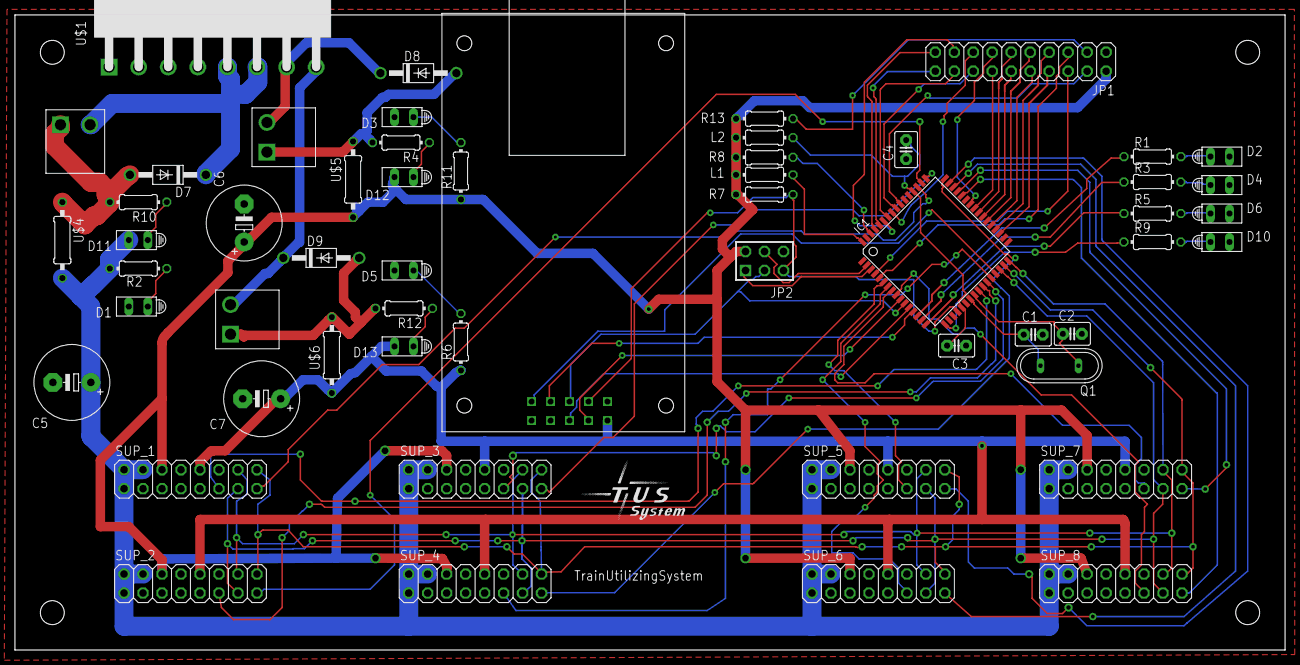
[picture p24: board EthernetBridge.brd from above]

Board: 2 copper layers, 170.0 x 85.0 mm, 55 parts (0 on the bottom side), 74 nets.
