sosoru/TrainUtilizingSystem/Schematics/EthControlling/writer_attiny10.brd

## EAGLE design Schematics/EthControlling/writer_attiny10.brd (2012-04-20)

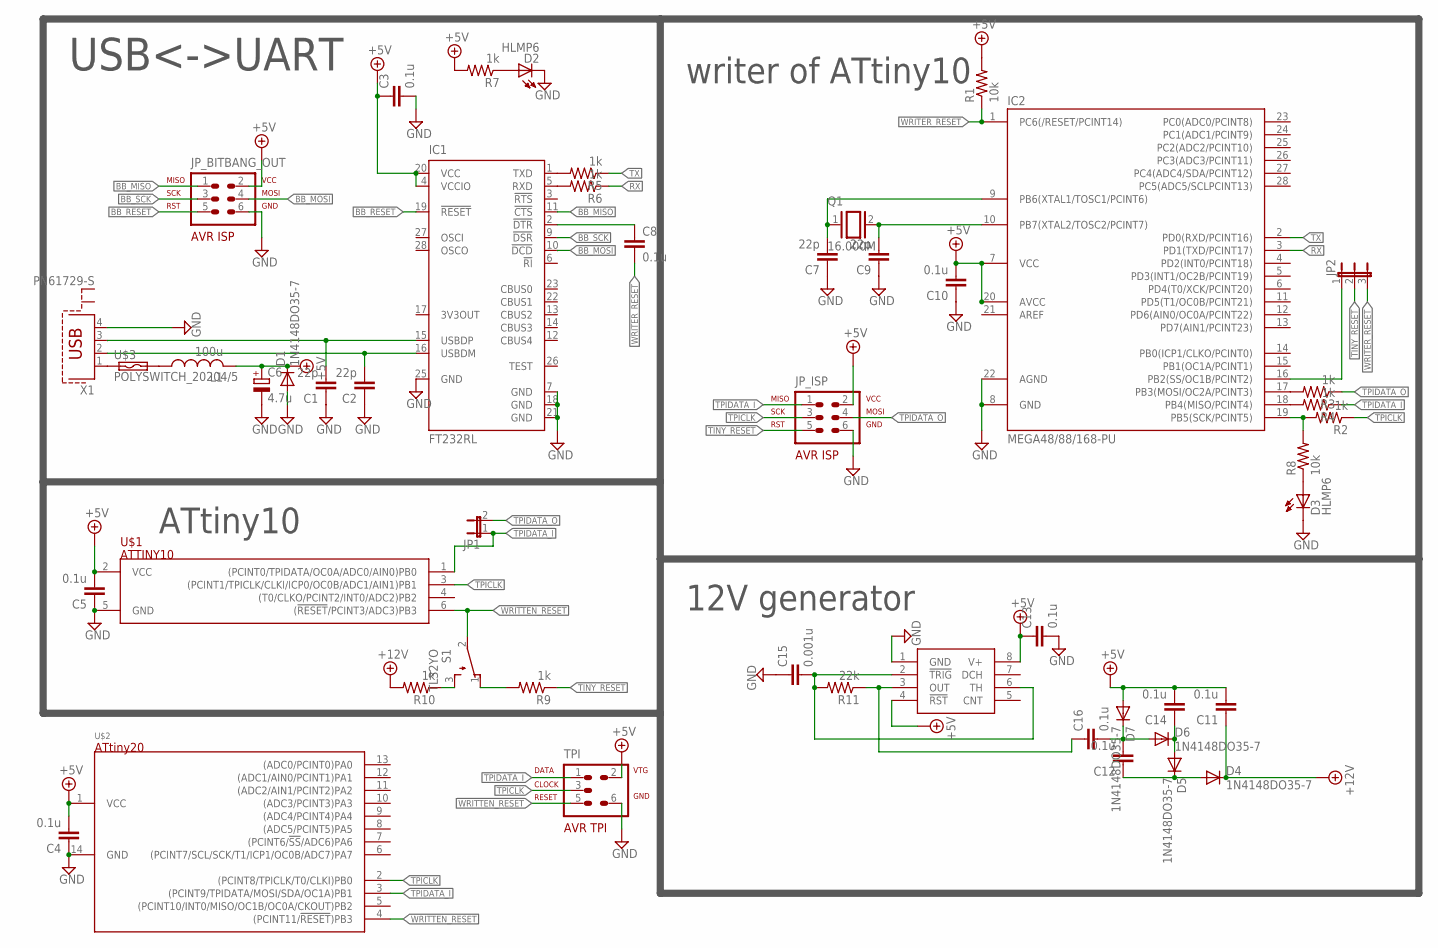
[picture p25: schematic writer_attiny10.sch]

Parts:
C1, C2, C7, C9: 22p; C0603
C3, C4, C5, C8, C10, C11, C12, C13, C14, C16: 0.1u; C0603
C6: 4.7u; CT3216
C15: 0.001u; C0603
D1, D4, D5, D6, D7: 1N4148DO35-7; DO35-7
D2: HLMP6; MPN HLMP-6500
D3: HLMP6
IC1: FT232RL; SSOP28
IC2: MEGA48/88/168-PU; DIL28-3
IC3: LMC555; DIL08
JP1: JP1E; JP1
JP2: JP2E; JP2
JP_BITBANG_OUT: AVR-ISP-6VERT; AVR-ISP-6
JP_ISP: AVR-ISP-6VERT; AVR-ISP-6
L1: 100u; 0207/10
Q1: 16.000M; QS
R1, R8: 10k; R0603
R2, R3, R4, R5, R6, R7, R9, R10: 1k; R0603
R11: 22k; R0603
S1: TL32YO; TL3XYO
TPI: AVR-TPIVERT; AVR-ISP-6
U$1: ATTINY10; SOT-23
U$2: ATTINY20; SOIC14
U$3: POLYSWITCH_20204/5; 0204/5
X1: PN61729-S

Connections:
+5V: C3.1, C4.2, C5.2, C6.+, C10.2, C11.2, C13.1, C14.2, D1.C, D7.A, IC1.4 (VCCIO), IC1.20 (VCC), IC2.7 (VCC), IC2.20 (AVCC), IC3.4 (!RST), IC3.8 (V+), JP_BITBANG_OUT.2, JP_ISP.2, L1.2, R1.2, R7.2, TPI.2, U$1.2 (VCC), U$2.1 (VCC)
+12V: C11.1, D4.C, R10.2
BB_MISO: IC1.11 (!CTS), JP_BITBANG_OUT.1
BB_MOSI: IC1.10 (!DCD), JP_BITBANG_OUT.4
BB_RESET: IC1.19 (!RESET), JP_BITBANG_OUT.5
BB_SCK: IC1.9 (!DSR), JP_BITBANG_OUT.3
GND: C1.1, C2.1, C3.2, C4.1, C5.1, C6.-, C7.1, C9.1, C10.1, C13.2, C15.1, D1.A, D2.K, D3.K, IC1.7 (GND), IC1.18 (GND), IC1.21 (GND), IC1.25 (GND), IC2.8 (GND), IC2.22 (AGND), IC3.1 (GND), JP_BITBANG_OUT.6, JP_ISP.6, TPI.6, U$1.5 (GND), U$2.14 (GND), X1.4
unnamed: C2.2, IC1.16 (USBDM), X1.2
unnamed: C1.2, IC1.15 (USBDP), X1.3
unnamed: U$3.1, X1.1
unnamed: C7.2, IC2.9 (PB6(XTAL1/TOSC1/PCINT6)), Q1.1
unnamed: C9.2, IC2.10 (PB7(XTAL2/TOSC2/PCINT7)), Q1.2
unnamed: IC2.18 (PB4(MISO/PCINT4)), R4.2
unnamed: D2.A, R7.1
unnamed: D3.A, R8.1
unnamed: IC1.5 (RXD), R6.2
unnamed: C12.2, C16.2, D6.A, D7.C
unnamed: IC1.1 (TXD), R5.2
unnamed: C15.2, IC3.2 (!TRIG), IC3.6 (TH), R11.2
unnamed: C16.1, IC3.3 (OUT), R11.1
unnamed: C14.1, D5.A, D6.C
unnamed: C12.1, D4.A, D5.C
unnamed: R10.1, S1.3 (S)
unnamed: R9.2, S1.1 (O)
unnamed: L1.1, U$3.2
unnamed: IC2.17 (PB3(MOSI/OC2A/PCINT3)), R3.2
unnamed: IC2.16 (PB2(SS/OC1B/PCINT2)), JP2.1
unnamed: C8.1, IC1.2 (!DTR)
unnamed: IC2.19 (PB5(SCK/PCINT5)), R2.2, R8.2
RX: IC2.3 (PD1(TXD/PCINT17)), R6.1
TINY_RESET: JP2.2, JP_ISP.5, R9.1
TPICLK: JP_ISP.3, R2.1, TPI.3, U$1.3 ((PCINT1/TPICLK/CLKI/ICP0/OC0B/ADC1/AIN1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), U$2.2 ((PCINT8/TPICLK/T0/CLKI)PB0)
TPIDATA_I: JP1.1, JP_ISP.1, R4.1, TPI.1, U$1.1 ((PCINT0/TPIDATA/OC0A/ADC0/AIN0)PB0), U$2.3 ((PCINT9/TPIDATA/MOSI/SDA/OC1A)PB1)
TPIDATA_O: JP1.2, JP_ISP.4, R3.1
TX: IC2.2 (PD0(RXD/PCINT16)), R5.1
WRITER_RESET: C8.2, IC2.1 (PC6(/RESET/PCINT14)), JP2.3, R1.1
WRITTEN_RESET: S1.2, TPI.5, U$1.6 ((!RESET!/PCINT3/ADC3)PB3), U$2.4 ((PCINT11/!RESET!)PB3)

Notes on the sheet:
USB<->UART
writer of ATtiny10
ATtiny10
12V generator

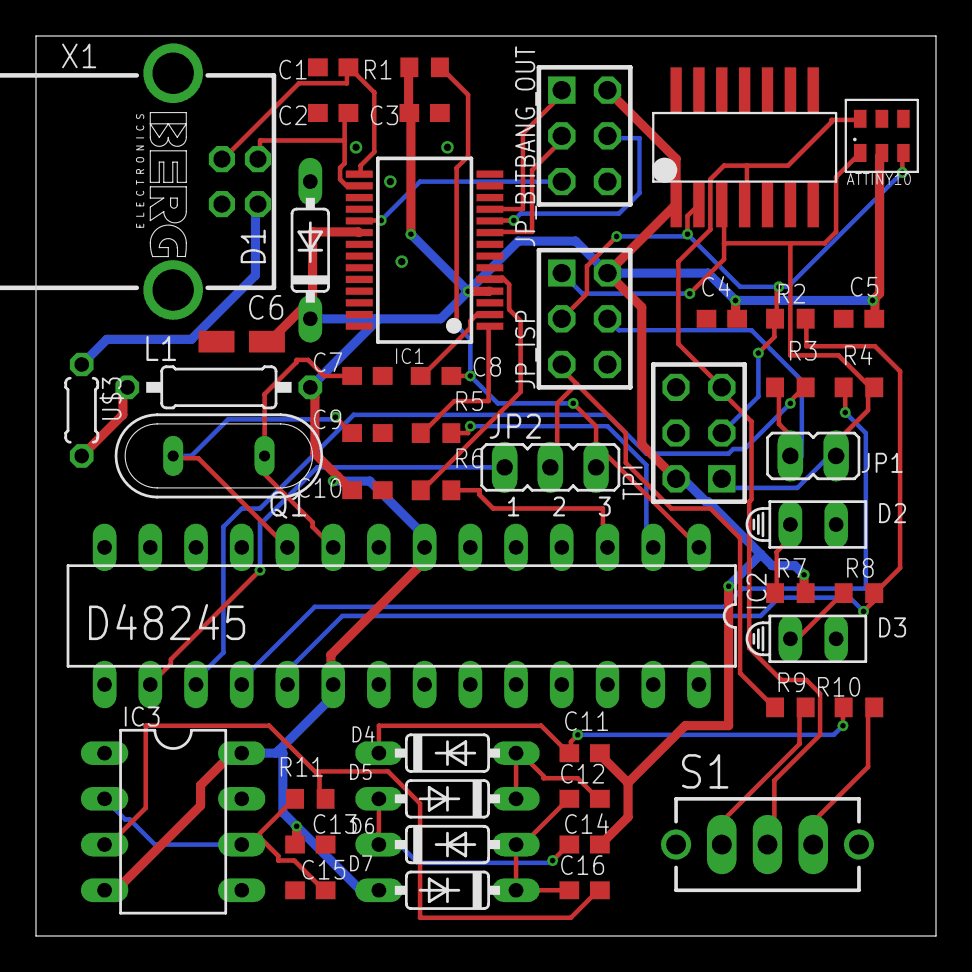
[picture p26: board writer_attiny10.brd from above]

Board: 2 copper layers, 50.0 x 50.0 mm, 49 parts (0 on the bottom side), 37 nets.
