sosoru/TrainUtilizingSystem/Schematics/EthControlling/SerialSignal.brd

## EAGLE design Schematics/EthControlling/SerialSignal.brd (2012-04-20)

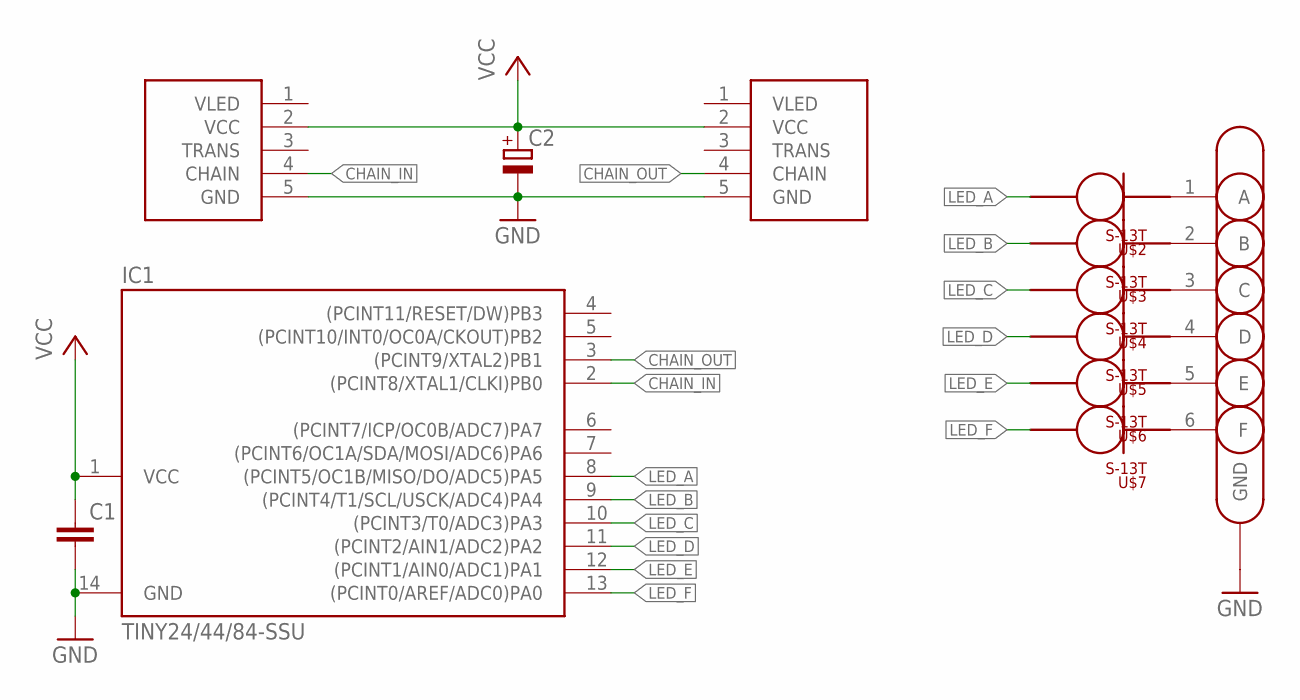
[picture p27: schematic SerialSignal.sch]

Parts:
C1: C-EUC0603; C0603
C2: CPOL-EUSMCC; SMC_C
IC1: TINY24/44/84-SSU; SOIC14
SMD1, SMD2: SERIAL_SENSOR; SERIAL_4
U$1: SIGNAL_CONNECTOR; SIGNEL_CONNECTOR
U$2, U$3, U$4, U$5, U$6, U$7: S-13T; S-1*3T

Connections:
CHAIN_IN: IC1.2 ((PCINT8/XTAL1/CLKI)PB0), SMD1.4 (CHAIN)
CHAIN_OUT: IC1.3 ((PCINT9/XTAL2)PB1), SMD2.4 (CHAIN)
GND: C1.2, C2.-, IC1.14 (GND), SMD1.5 (GND), SMD2.5 (GND), U$1.GND
LED_A: IC1.8 ((PCINT5/OC1B/MISO/DO/ADC5)PA5), U$2.A
LED_B: IC1.9 ((PCINT4/T1/SCL/USCK/ADC4)PA4), U$3.A
LED_C: IC1.10 ((PCINT3/T0/ADC3)PA3), U$4.A
LED_D: IC1.11 ((PCINT2/AIN1/ADC2)PA2), U$5.A
LED_E: IC1.12 ((PCINT1/AIN0/ADC1)PA1), U$6.A
LED_F: IC1.13 ((PCINT0/AREF/ADC0)PA0), U$7.A
unnamed: U$1.1 (A), U$2.C
unnamed: U$1.2 (B), U$3.C
unnamed: U$1.3 (C), U$4.C
unnamed: U$1.4 (D), U$5.C
unnamed: U$1.5 (E), U$6.C
unnamed: U$1.6 (F), U$7.C
VCC: C1.1, C2.+, IC1.1 (VCC), SMD1.2 (VCC), SMD2.2 (VCC)

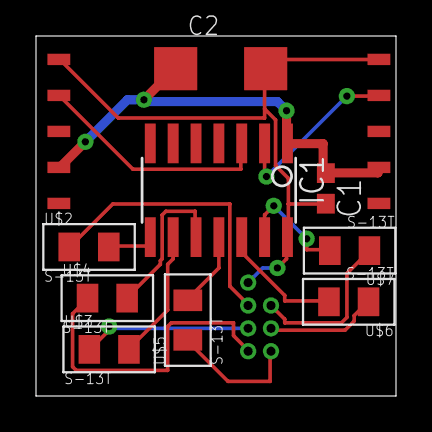
[picture p28: board SerialSignal.brd from above]

Board: 2 copper layers, 20.0 x 20.0 mm, 12 parts (0 on the bottom side), 16 nets.
