sosoru/TrainUtilizingSystem/Schematics/EthControlling/EthernetBoardPanel.brd

## EAGLE design Schematics/EthControlling/EthernetBoardPanel.brd (2012-04-20)

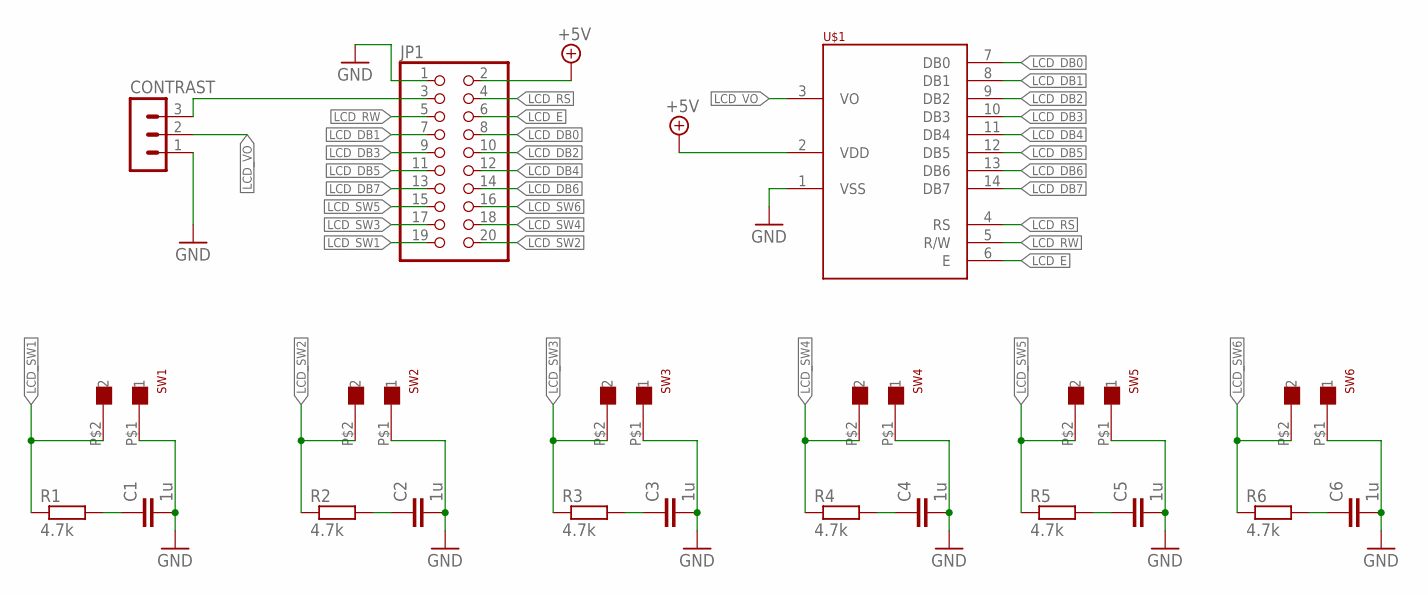
[picture p29: schematic EthernetBoardPanel.sch]

Parts:
C1, C2, C3, C4, C5, C6: 1u; C025-025X050
CONTRAST: MA03-1
JP1: PINHD-2X10; 2X10
R1, R2, R3, R4, R5, R6: 4.7k; 0204/7
SW1, SW2, SW3, SW4, SW5, SW6: XH-2
U$1: SC2004

Connections:
+5V: JP1.2, U$1.2 (VDD)
GND: C1.2, C2.2, C3.2, C4.2, C5.2, C6.2, CONTRAST.1, JP1.1, SW1.P$1 (1), SW2.P$1 (1), SW3.P$1 (1), SW4.P$1 (1), SW5.P$1 (1), SW6.P$1 (1), U$1.1 (VSS)
LCD_DB0: JP1.8, U$1.7 (DB0)
LCD_DB1: JP1.7, U$1.8 (DB1)
LCD_DB2: JP1.10, U$1.9 (DB2)
LCD_DB3: JP1.9, U$1.10 (DB3)
LCD_DB4: JP1.12, U$1.11 (DB4)
LCD_DB5: JP1.11, U$1.12 (DB5)
LCD_DB6: JP1.14, U$1.13 (DB6)
LCD_DB7: JP1.13, U$1.14 (DB7)
LCD_E: JP1.6, U$1.6 (E)
LCD_RS: JP1.4, U$1.4 (RS)
LCD_RW: JP1.5, U$1.5 (R/W)
LCD_SW1: JP1.19, R1.1, SW1.P$2 (2)
LCD_SW2: JP1.20, R2.1, SW2.P$2 (2)
LCD_SW3: JP1.17, R3.1, SW3.P$2 (2)
LCD_SW4: JP1.18, R4.1, SW4.P$2 (2)
LCD_SW5: JP1.15, R5.1, SW5.P$2 (2)
LCD_SW6: JP1.16, R6.1, SW6.P$2 (2)
LCD_VO: CONTRAST.2, U$1.3 (VO)
unnamed: CONTRAST.3, JP1.3
unnamed: C5.1, R5.2
unnamed: C2.1, R2.2
unnamed: C3.1, R3.2
unnamed: C4.1, R4.2
unnamed: C1.1, R1.2
unnamed: C6.1, R6.2

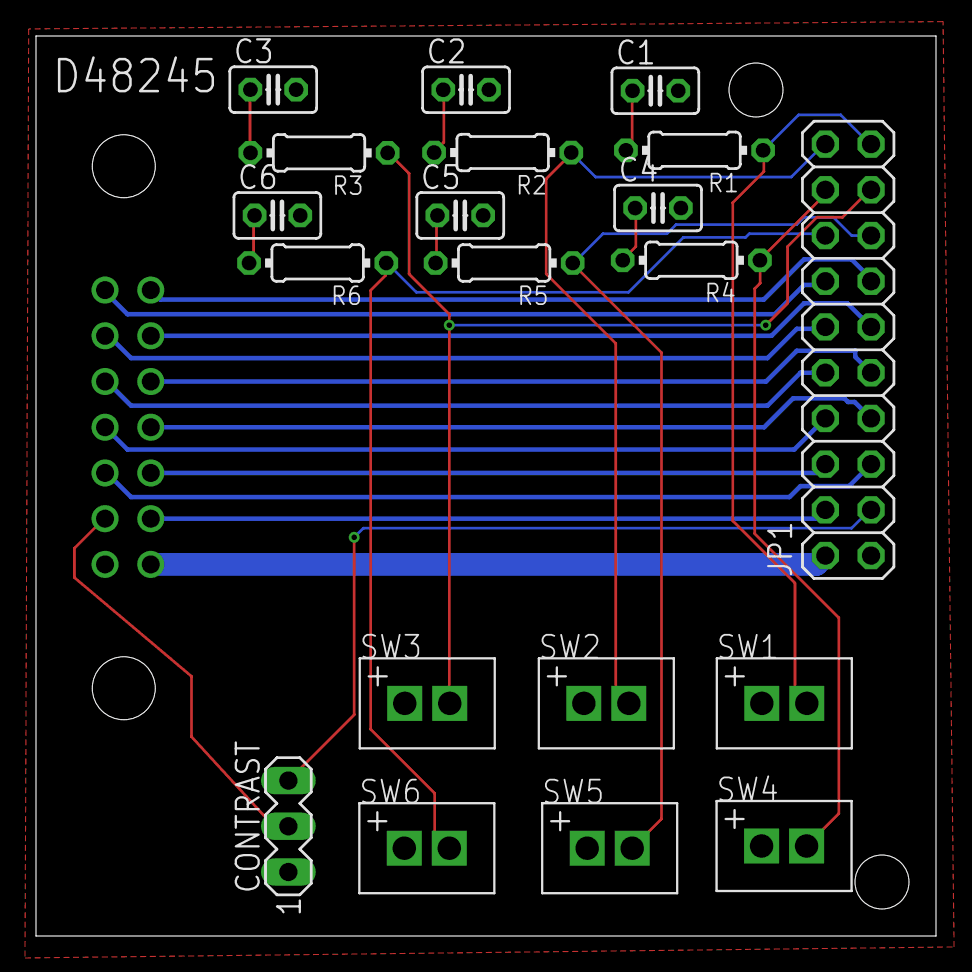
[picture p30: board EthernetBoardPanel.brd from above]

Board: 2 copper layers, 50.0 x 50.0 mm, 21 parts (1 on the bottom side), 27 nets.
