sosoru/TrainUtilizingSystem/Schematics/EthControlling/SensorController.brd

## EAGLE design Schematics/EthControlling/SensorController.brd (2012-04-20, an earlier design)

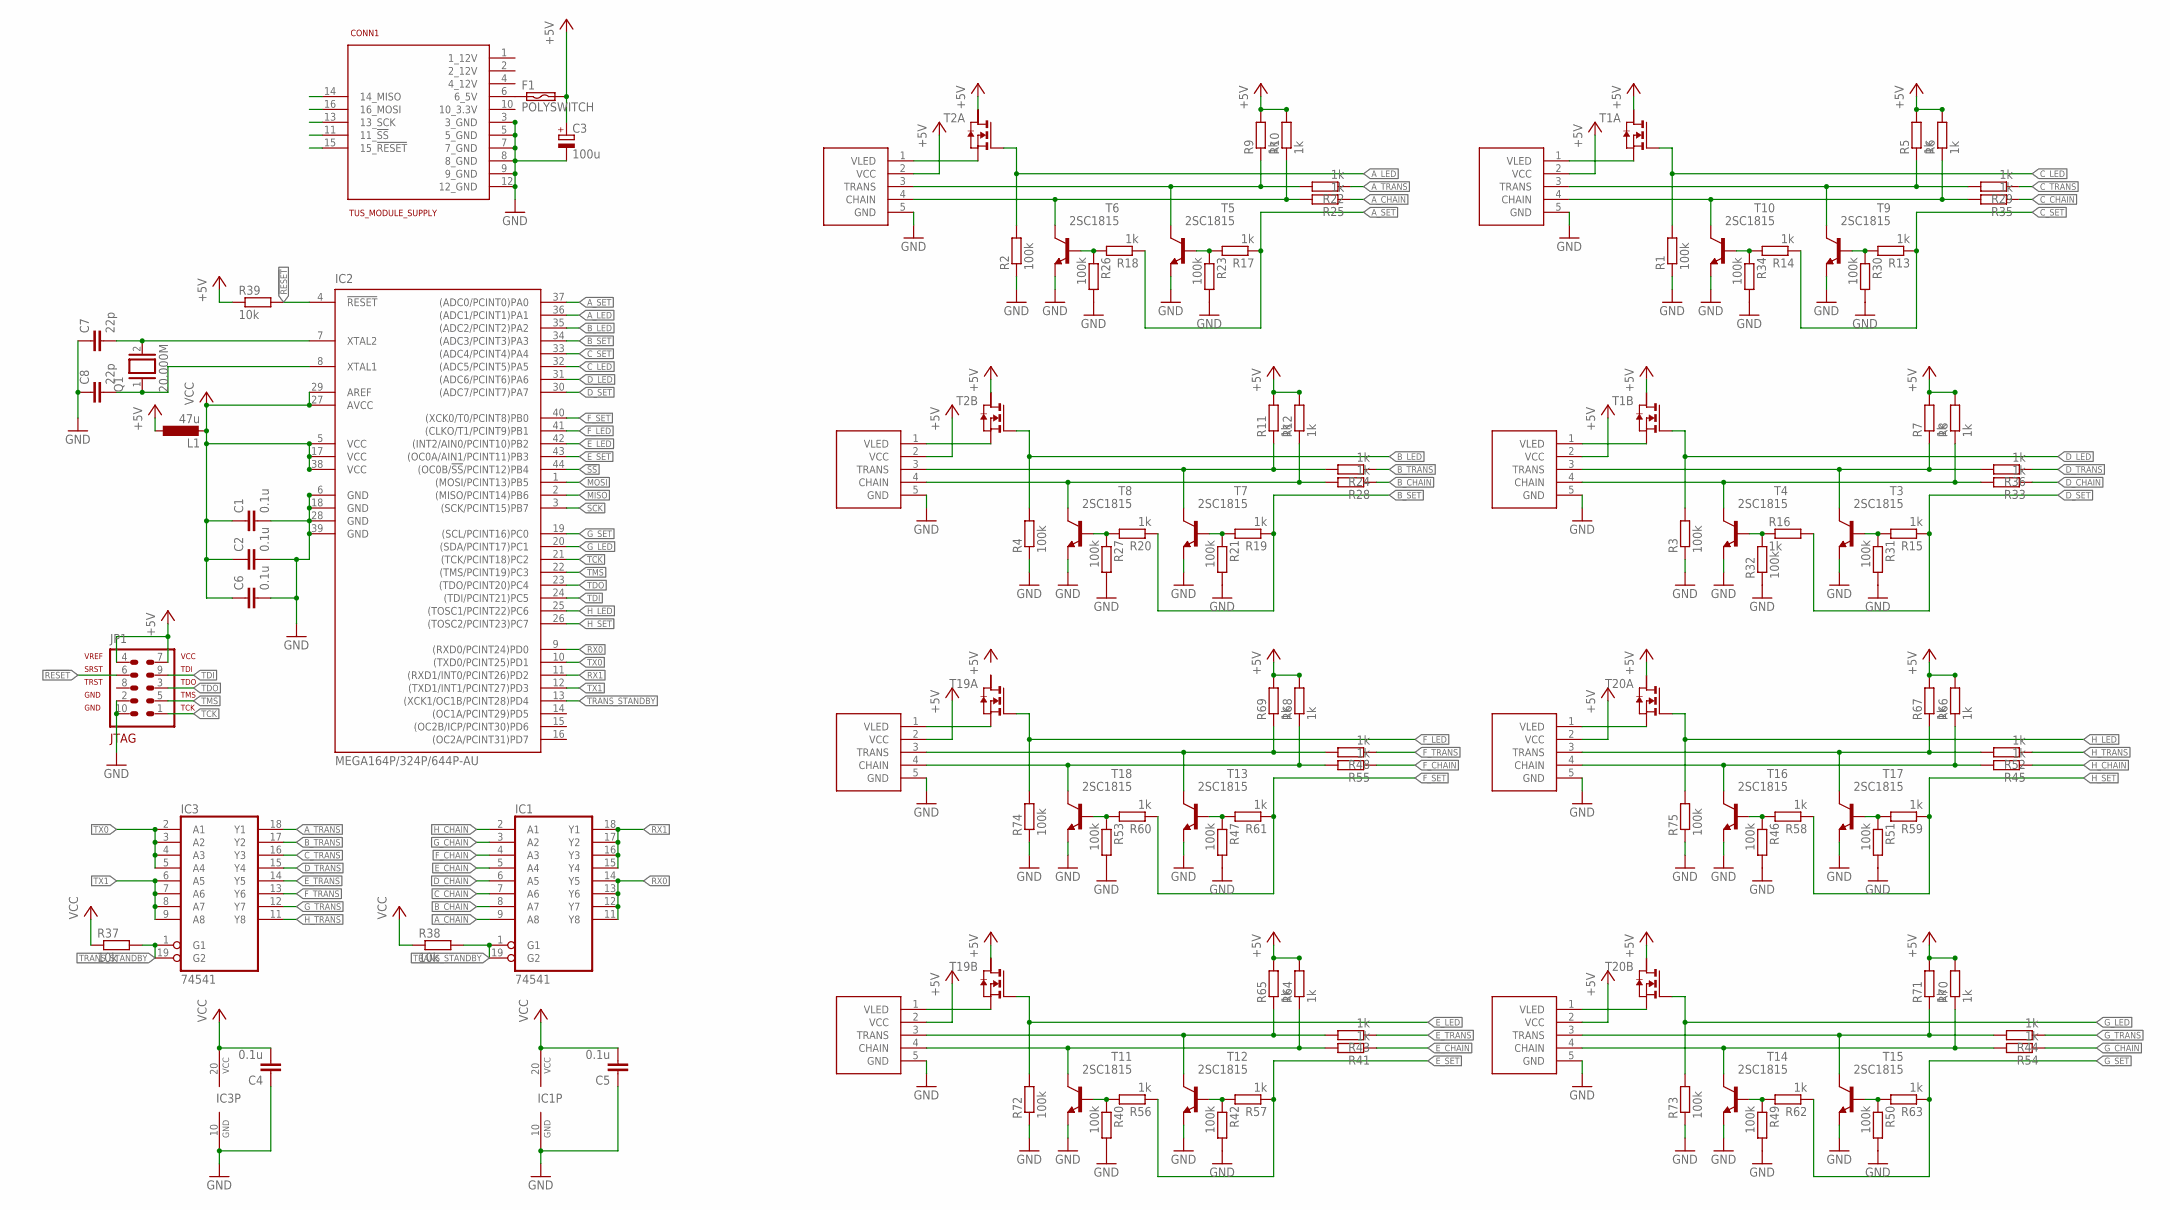
[picture p31: schematic SensorController.sch]

Parts:
A_OUT: SERIAL_SENSORXH; XH-5
B_OUT: SERIAL_SENSORXH; XH-5
C1, C2, C4, C5, C6: 0.1u; C1608
C3: 100u; E2,5-7
C7, C8: 22p; C1608
CONN1: TUS_MODULE_SUPPLY; 2X08
C_OUT: SERIAL_SENSORXH; XH-5
D_OUT: SERIAL_SENSORXH; XH-5
E_OUT: SERIAL_SENSORXH; XH-5
F1: POLYSWITCH; 0207/2V
F_OUT: SERIAL_SENSORXH; XH-5
G_OUT: SERIAL_SENSORXH; XH-5
H_OUT: SERIAL_SENSORXH; XH-5
IC1, IC3: 74541; SSOP20
IC2: MEGA164P/324P/644P-AU; TQFP44
JP1: AVR-JTAG-10
L1: 47u; L1812
Q1: 20.000M; QS
R1, R2, R3, R4, R21, R23, R26, R27, R30, R31, R32, R34, R40, R42, R46, R47, R49, R50, R51, R53, R72, R73, R74, R75: 100k; R0603
R5, R6, R7, R8, R9, R10, R11, R12, R13, R14, R15, R16, R17, R18, R19, R20, R22, R24, R25, R28, R29, R33, R35, R36, R41, R43, R44, R45, R48, R52, R54, R55, R56, R57, R58, R59, R60, R61, R62, R63, R64, R65, R66, R67, R68, R69, R70, R71: 1k; R0603
R37, R38, R39: 10k; R0603
T1, T2, T19, T20: NMOS2SO8; SO8
T3, T4, T5, T6, T7, T8, T9, T10, T11, T12, T13, T14, T15, T16, T17, T18: 2SC1815; TO92-ECB

Connections:
!RESET: CONN1.15 (15_!RESET), IC2.4 (!RESET), JP1.6, R39.2
!SS: CONN1.11 (11_!SS), IC2.44 ((OC0B/!SS!/PCINT12)PB4)
+5V: A_OUT.2 (VCC), B_OUT.2 (VCC), C3.+, C_OUT.2 (VCC), D_OUT.2 (VCC), E_OUT.2 (VCC), F1.2, F_OUT.2 (VCC), G_OUT.2 (VCC), H_OUT.2 (VCC), JP1.4, JP1.7, L1.1, R5.2, R6.2, R7.2, R8.2, R9.2, R10.2, R11.2, R12.2, R39.1, R64.2, R65.2, R66.2, R67.2, R68.2, R69.2, R70.2, R71.2, T1.6 (D), T1.8 (D), T2.6 (D), T2.8 (D), T19.6 (D), T20.6 (D), T20.8 (D)
A_CHAIN: IC1.9 (A8), R25.1
A_LED: IC2.36 ((ADC1/PCINT1)PA1), R2.2, T2.2 (G)
A_SET: IC2.37 ((ADC0/PCINT0)PA0), R17.1, R18.1
A_TRANS: IC3.18 (Y1), R22.1
B_CHAIN: IC1.8 (A7), R28.1
B_LED: IC2.35 ((ADC2/PCINT2)PA2), R4.2, T2.4 (G)
B_SET: IC2.34 ((ADC3/PCINT3)PA3), R19.1, R20.1
B_TRANS: IC3.17 (Y2), R24.1
C_CHAIN: IC1.7 (A6), R35.1
C_LED: IC2.32 ((ADC5/PCINT5)PA5), R1.2, T1.2 (G)
C_SET: IC2.33 ((ADC4/PCINT4)PA4), R13.1, R14.1
C_TRANS: IC3.16 (Y3), R29.1
D_CHAIN: IC1.6 (A5), R33.1
D_LED: IC2.31 ((ADC6/PCINT6)PA6), R3.2, T1.4 (G)
D_SET: IC2.30 ((ADC7/PCINT7)PA7), R15.1, R16.2
D_TRANS: IC3.15 (Y4), R36.1
E_CHAIN: IC1.5 (A4), R41.1
E_LED: IC2.42 ((INT2/AIN0/PCINT10)PB2), R72.2, T19.4 (G)
E_SET: IC2.43 ((OC0A/AIN1/PCINT11)PB3), R56.1, R57.1
E_TRANS: IC3.14 (Y5), R43.1
F_CHAIN: IC1.4 (A3), R55.1
F_LED: IC2.41 ((CLKO/T1/PCINT9)PB1), R74.2, T19.2 (G)
F_SET: IC2.40 ((XCK0/T0/PCINT8)PB0), R60.1, R61.1
F_TRANS: IC3.13 (Y6), R48.1
GND: A_OUT.5 (GND), B_OUT.5 (GND), C1.2, C2.2, C3.-, C4.1, C5.1, C6.2, C7.1, C8.1, CONN1.3 (3_GND), CONN1.5 (5_GND), CONN1.7 (7_GND), CONN1.8 (8_GND), CONN1.9 (9_GND), CONN1.12 (12_GND), C_OUT.5 (GND), D_OUT.5 (GND), E_OUT.5 (GND), F_OUT.5 (GND), G_OUT.5 (GND), H_OUT.5 (GND), IC1.10 (GND), IC2.6 (GND), IC2.18 (GND), IC2.28 (GND), IC2.39 (GND), IC3.10 (GND), JP1.2, JP1.10, R1.1, R2.1, R3.1, R4.1, R21.2, R23.2, R26.2, R27.2, R30.2, R31.2, R32.1, R34.2, R40.2, R42.2, R46.2, R47.2, R49.2, R50.2, R51.2, R53.2, R72.1, R73.1, R74.1, R75.1, T3.E, T4.E, T5.E, T6.E, T7.E, T8.E, T9.E, T10.E, T11.E, T12.E, T13.E, T14.E, T15.E, T16.E, T17.E, T18.E
G_CHAIN: IC1.3 (A2), R54.1
G_LED: IC2.20 ((SDA/PCINT17)PC1), R73.2, T20.4 (G)
G_SET: IC2.19 ((SCL/PCINT16)PC0), R62.1, R63.1
G_TRANS: IC3.12 (Y7), R44.1
H_CHAIN: IC1.2 (A1), R45.1
H_LED: IC2.25 ((TOSC1/PCINT22)PC6), R75.2, T20.2 (G)
H_SET: IC2.26 ((TOSC2/PCINT23)PC7), R58.1, R59.1
H_TRANS: IC3.11 (Y8), R52.1
MISO: CONN1.14 (14_MISO), IC2.2 ((MISO/PCINT14)PB6)
MOSI: CONN1.16 (16_MOSI), IC2.1 ((MOSI/PCINT13)PB5)
unnamed: A_OUT.1 (VLED), T2.1 (S)
unnamed: C8.2, IC2.8 (XTAL1), Q1.1
unnamed: R17.2, R23.1, T5.B
unnamed: C7.2, IC2.7 (XTAL2), Q1.2
unnamed: R18.2, R26.1, T6.B
unnamed: B_OUT.1 (VLED), T2.3 (S)
unnamed: R19.2, R21.1, T7.B
unnamed: R20.2, R27.1, T8.B
unnamed: F_OUT.1 (VLED), T19.1 (S)
unnamed: R47.1, R61.2, T13.B
unnamed: R53.1, R60.2, T18.B
unnamed: E_OUT.1 (VLED), T19.3 (S)
unnamed: R42.1, R57.2, T12.B
unnamed: R40.1, R56.2, T11.B
unnamed: C_OUT.1 (VLED), T1.1 (S)
unnamed: R13.2, R30.1, T9.B
unnamed: R14.2, R34.1, T10.B
unnamed: D_OUT.1 (VLED), T1.3 (S)
unnamed: R15.2, R31.1, T3.B
unnamed: R16.1, R32.2, T4.B
unnamed: H_OUT.1 (VLED), T20.1 (S)
unnamed: R51.1, R59.2, T17.B
unnamed: R46.1, R58.2, T16.B
unnamed: G_OUT.1 (VLED), T20.3 (S)
unnamed: R50.1, R63.2, T15.B
unnamed: R49.1, R62.2, T14.B
unnamed: CONN1.6 (6_5V), F1.1
unnamed: A_OUT.3 (TRANS), R9.1, R22.2, T5.C
unnamed: B_OUT.3 (TRANS), R11.1, R24.2, T7.C
unnamed: C_OUT.3 (TRANS), R5.1, R29.2, T9.C
unnamed: D_OUT.3 (TRANS), R7.1, R36.2, T3.C
unnamed: F_OUT.3 (TRANS), R48.2, R69.1, T13.C
unnamed: H_OUT.3 (TRANS), R52.2, R67.1, T17.C
unnamed: E_OUT.3 (TRANS), R43.2, R65.1, T12.C
unnamed: G_OUT.3 (TRANS), R44.2, R71.1, T15.C
unnamed: A_OUT.4 (CHAIN), R10.1, R25.2, T6.C
unnamed: B_OUT.4 (CHAIN), R12.1, R28.2, T8.C
unnamed: F_OUT.4 (CHAIN), R55.2, R68.1, T18.C
unnamed: E_OUT.4 (CHAIN), R41.2, R64.1, T11.C
unnamed: D_OUT.4 (CHAIN), R8.1, R33.2, T4.C
unnamed: C_OUT.4 (CHAIN), R6.1, R35.2, T10.C
unnamed: H_OUT.4 (CHAIN), R45.2, R66.1, T16.C
unnamed: G_OUT.4 (CHAIN), R54.2, R70.1, T14.C
RX0: IC1.11 (Y8), IC1.12 (Y7), IC1.13 (Y6), IC1.14 (Y5), IC2.9 ((RXD0/PCINT24)PD0)
RX1: IC1.15 (Y4), IC1.16 (Y3), IC1.17 (Y2), IC1.18 (Y1), IC2.11 ((RXD1/INT0/PCINT26)PD2)
SCK: CONN1.13 (13_SCK), IC2.3 ((SCK/PCINT15)PB7)
TCK: IC2.21 ((TCK/PCINT18)PC2), JP1.1
TDI: IC2.24 ((TDI/PCINT21)PC5), JP1.9
TDO: IC2.23 ((TDO/PCINT20)PC4), JP1.3
TMS: IC2.22 ((TMS/PCINT19)PC3), JP1.5
TRANS_STANDBY: IC1.1 (G1), IC1.19 (G2), IC2.13 ((XCK1/OC1B/PCINT28)PD4), IC3.1 (G1), IC3.19 (G2), R37.2, R38.2
TX0: IC2.10 ((TXD0/PCINT25)PD1), IC3.2 (A1), IC3.3 (A2), IC3.4 (A3), IC3.5 (A4)
TX1: IC2.12 ((TXD1/INT1/PCINT27)PD3), IC3.6 (A5), IC3.7 (A6), IC3.8 (A7), IC3.9 (A8)
VCC: C1.1, C2.1, C4.2, C5.2, C6.1, IC1.20 (VCC), IC2.5 (VCC), IC2.17 (VCC), IC2.27 (AVCC), IC2.29 (AREF), IC2.38 (VCC), IC3.20 (VCC), L1.2, R37.1, R38.1

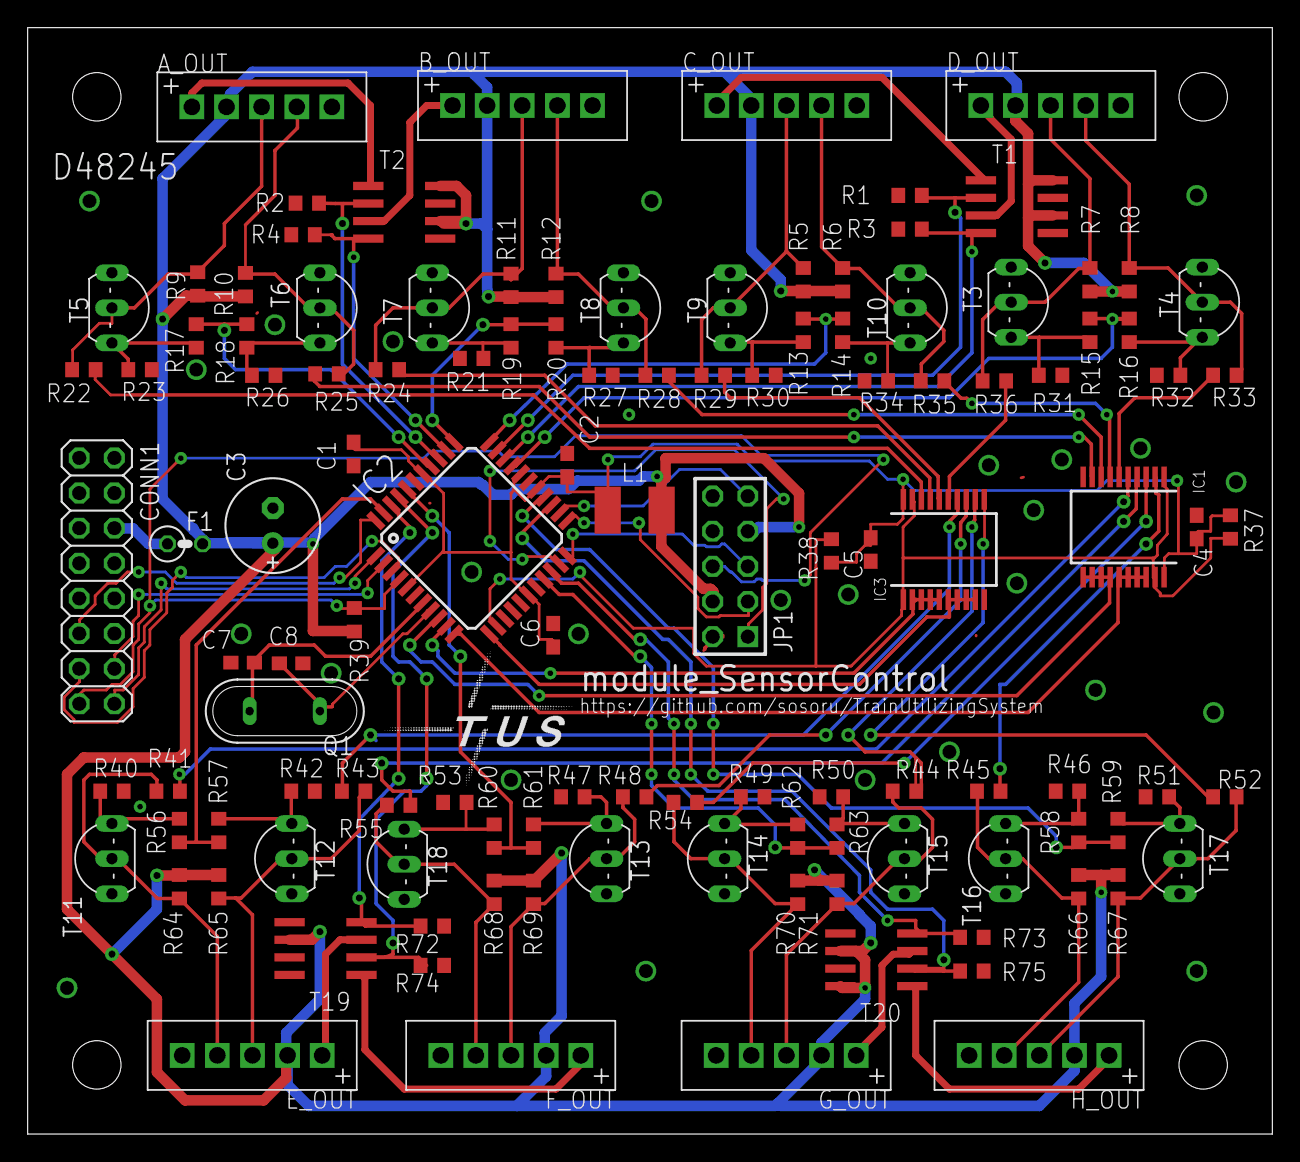
[picture p32: board SensorController.brd from above]

Board: 2 copper layers, 90.0 x 80.0 mm, 119 parts (0 on the bottom side), 92 nets.
