sosoru/TrainUtilizingSystem/Schematics/EthControlling/PointController.brd

## EAGLE design Schematics/EthControlling/PointController.brd (2012-04-20)

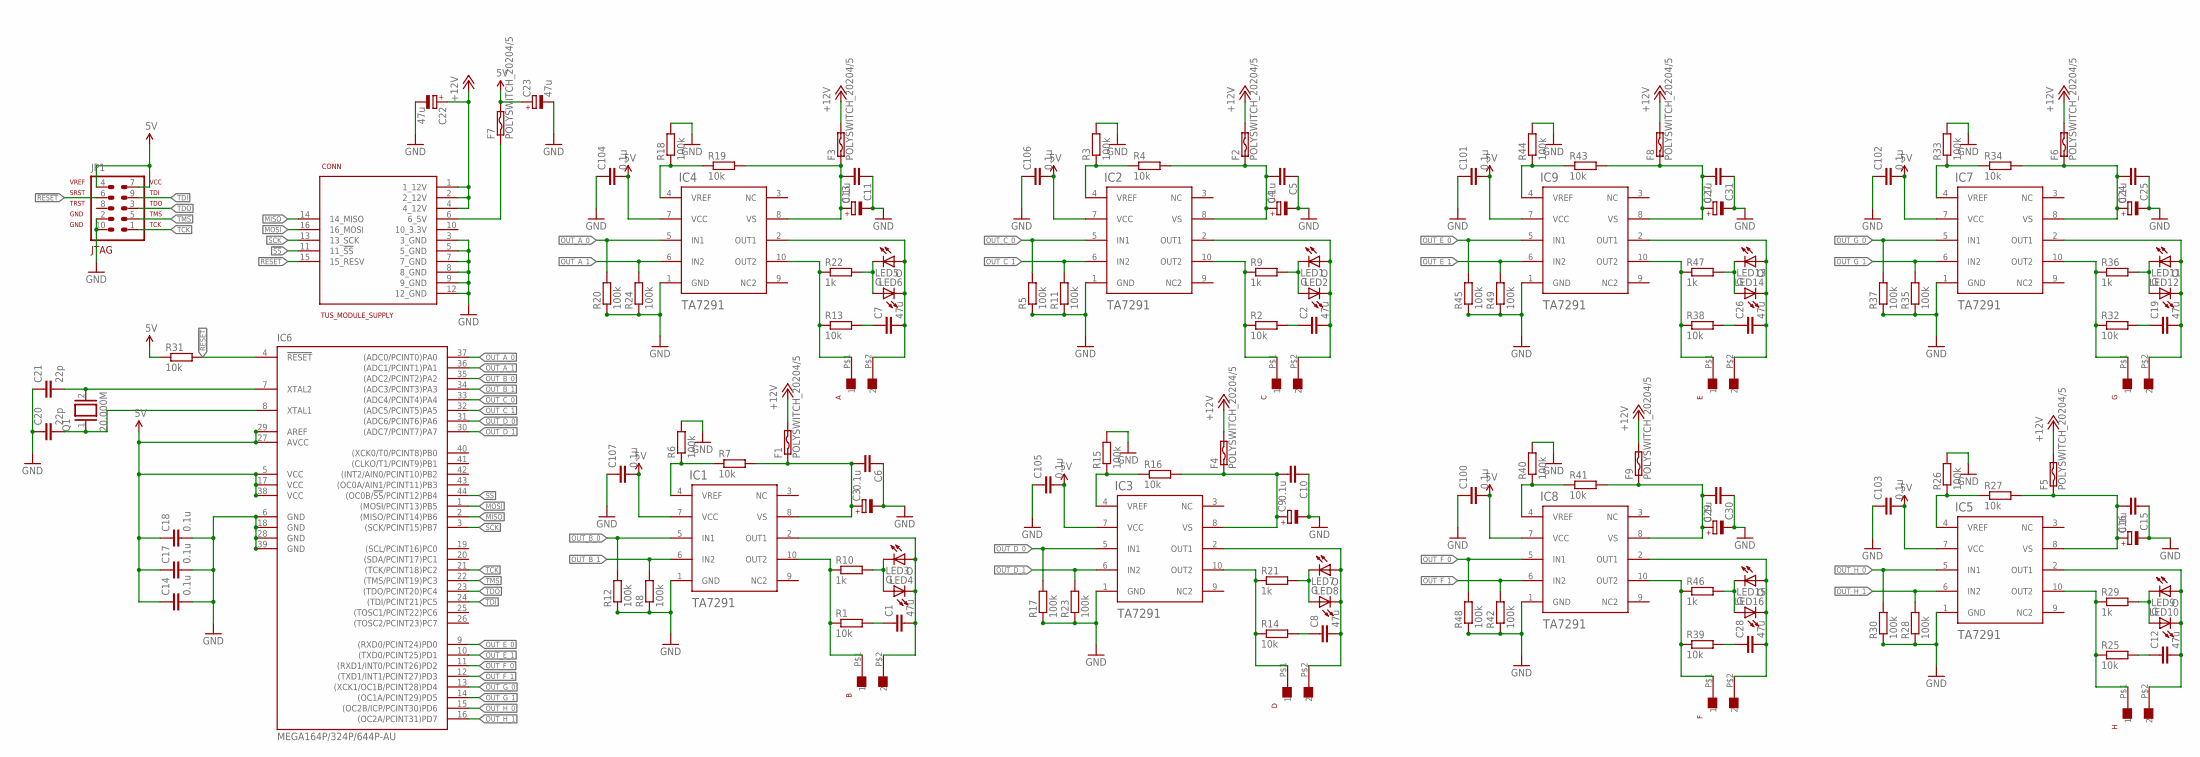
[picture p33: schematic PointController.sch]

Parts:
A: XH-2
B: XH-2
C: XH-2
C1, C2, C7, C8, C12, C19, C26, C28: 47u; C5B3
C3, C4, C9, C13, C16, C24, C27, C29: CPOL-EUE2.5-5; E2,5-5
C5, C6, C10, C11, C14, C15, C17, C18, C25, C30, C31, C100, C101, C102, C103, C104, C105, C106, C107: 0.1u; C1608
C20, C21: 22p; C1608
C22, C23: 47u; E2,5-5
CONN: TUS_MODULE_SUPPLY; 2X08
D: XH-2
E: XH-2
F: XH-2
F1, F2, F3, F4, F5, F6, F7, F8, F9: POLYSWITCH_20204/5; 0204/5
G: XH-2
H: XH-2
IC1, IC2, IC3, IC4, IC5, IC7, IC8, IC9: TA7291; HSIP10
IC6: MEGA164P/324P/644P-AU; TQFP44
JP1: AVR-JTAG-10
LED1, LED3, LED5, LED7, LED9, LED11, LED13, LED15: G; LED3MM
LED2, LED4, LED6, LED8, LED10, LED12, LED14, LED16: O; LED3MM
Q1: 20.000M; QS
R1, R2, R13, R14, R25, R32, R38, R39: 10k; 0204/7
R3, R5, R6, R8, R11, R12, R15, R17, R18, R20, R23, R24, R26, R28, R30, R33, R35, R37, R40, R42, R44, R45, R48, R49: 100k; R0603
R4, R7, R16, R19, R27, R31, R34, R41, R43: 10k; R0603
R9, R10, R21, R22, R29, R36, R46, R47: 1k; R0603

Connections:
5V: C14.1, C17.1, C18.1, C23.+, C100.2, C101.2, C102.2, C103.2, C104.2, C105.2, C106.2, C107.2, F7.2, IC1.7 (VCC), IC2.7 (VCC), IC3.7 (VCC), IC4.7 (VCC), IC5.7 (VCC), IC6.5 (VCC), IC6.17 (VCC), IC6.27 (AVCC), IC6.29 (AREF), IC6.38 (VCC), IC7.7 (VCC), IC8.7 (VCC), IC9.7 (VCC), JP1.4, JP1.7, R31.1
!RESET: CONN.15 (15_RESV), IC6.4 (!RESET), JP1.6, R31.2
!SS: CONN.11 (11_!SS), IC6.44 ((OC0B/!SS!/PCINT12)PB4)
+12V: C22.+, CONN.1 (1_12V), CONN.2 (2_12V), CONN.4 (4_12V), F1.2, F2.2, F3.2, F4.2, F5.2, F6.2, F8.2, F9.2
GND: C3.-, C4.-, C5.1, C6.1, C9.-, C10.1, C11.1, C13.-, C14.2, C15.1, C16.-, C17.2, C18.2, C20.1, C21.1, C22.-, C23.-, C24.-, C25.1, C27.-, C29.-, C30.1, C31.1, C100.1, C101.1, C102.1, C103.1, C104.1, C105.1, C106.1, C107.1, CONN.3 (3_GND), CONN.5 (5_GND), CONN.7 (7_GND), CONN.8 (8_GND), CONN.9 (9_GND), CONN.12 (12_GND), IC1.1 (GND), IC2.1 (GND), IC3.1 (GND), IC4.1 (GND), IC5.1 (GND), IC6.6 (GND), IC6.18 (GND), IC6.28 (GND), IC6.39 (GND), IC7.1 (GND), IC8.1 (GND), IC9.1 (GND), JP1.2, JP1.10, R3.2, R5.1, R6.2, R8.1, R11.1, R12.1, R15.2, R17.1, R18.2, R20.1, R23.1, R24.1, R26.2, R28.1, R30.1, R33.2, R35.1, R37.1, R40.2, R42.1, R44.2, R45.1, R48.1, R49.1
MISO: CONN.14 (14_MISO), IC6.2 ((MISO/PCINT14)PB6)
MOSI: CONN.16 (16_MOSI), IC6.1 ((MOSI/PCINT13)PB5)
unnamed: LED5.K (C), LED6.A, R22.2
unnamed: IC1.4 (VREF), R6.1, R7.1
unnamed: C20.2, IC6.8 (XTAL1), Q1.1
unnamed: C21.2, IC6.7 (XTAL2), Q1.2
unnamed: B.P$2 (2), C1.2, IC1.2 (OUT1), LED3.A, LED4.K (C)
unnamed: IC4.4 (VREF), R18.1, R19.1
unnamed: A.P$2 (2), C7.2, IC4.2 (OUT1), LED5.A, LED6.K (C)
unnamed: A.P$1 (1), IC4.10 (OUT2), R13.1, R22.1
unnamed: C7.1, R13.2
unnamed: B.P$1 (1), IC1.10 (OUT2), R1.1, R10.1
unnamed: C1.1, R1.2
unnamed: LED3.K (C), LED4.A, R10.2
unnamed: IC2.4 (VREF), R3.1, R4.1
unnamed: C.P$2 (2), C2.2, IC2.2 (OUT1), LED1.A, LED2.K (C)
unnamed: C.P$1 (1), IC2.10 (OUT2), R2.1, R9.1
unnamed: C2.1, R2.2
unnamed: LED1.K (C), LED2.A, R9.2
unnamed: IC3.4 (VREF), R15.1, R16.1
unnamed: C8.2, D.P$2 (2), IC3.2 (OUT1), LED7.A, LED8.K (C)
unnamed: D.P$1 (1), IC3.10 (OUT2), R14.1, R21.1
unnamed: C8.1, R14.2
unnamed: LED7.K (C), LED8.A, R21.2
unnamed: IC9.4 (VREF), R43.1, R44.1
unnamed: C26.2, E.P$2 (2), IC9.2 (OUT1), LED13.A, LED14.K (C)
unnamed: E.P$1 (1), IC9.10 (OUT2), R38.1, R47.1
unnamed: C26.1, R38.2
unnamed: LED13.K (C), LED14.A, R47.2
unnamed: IC8.4 (VREF), R40.1, R41.1
unnamed: C28.2, F.P$2 (2), IC8.2 (OUT1), LED15.A, LED16.K (C)
unnamed: F.P$1 (1), IC8.10 (OUT2), R39.1, R46.1
unnamed: C28.1, R39.2
unnamed: LED15.K (C), LED16.A, R46.2
unnamed: IC7.4 (VREF), R33.1, R34.1
unnamed: C19.2, G.P$2 (2), IC7.2 (OUT1), LED11.A, LED12.K (C)
unnamed: G.P$1 (1), IC7.10 (OUT2), R32.1, R36.1
unnamed: C19.1, R32.2
unnamed: LED11.K (C), LED12.A, R36.2
unnamed: IC5.4 (VREF), R26.1, R27.1
unnamed: C12.2, H.P$2 (2), IC5.2 (OUT1), LED9.A, LED10.K (C)
unnamed: H.P$1 (1), IC5.10 (OUT2), R25.1, R29.1
unnamed: C12.1, R25.2
unnamed: LED9.K (C), LED10.A, R29.2
unnamed: CONN.6 (6_5V), F7.1
unnamed: C11.2, C13.+, F3.1, IC4.8 (VS), R19.2
unnamed: C4.+, C5.2, F2.1, IC2.8 (VS), R4.2
unnamed: C27.+, C31.2, F8.1, IC9.8 (VS), R43.2
unnamed: C24.+, C25.2, F6.1, IC7.8 (VS), R34.2
unnamed: C15.2, C16.+, F5.1, IC5.8 (VS), R27.2
unnamed: C29.+, C30.2, F9.1, IC8.8 (VS), R41.2
unnamed: C9.+, C10.2, F4.1, IC3.8 (VS), R16.2
unnamed: C3.+, C6.2, F1.1, IC1.8 (VS), R7.2
OUT_A_0: IC4.5 (IN1), IC6.37 ((ADC0/PCINT0)PA0), R20.2
OUT_A_1: IC4.6 (IN2), IC6.36 ((ADC1/PCINT1)PA1), R24.2
OUT_B_0: IC1.5 (IN1), IC6.35 ((ADC2/PCINT2)PA2), R12.2
OUT_B_1: IC1.6 (IN2), IC6.34 ((ADC3/PCINT3)PA3), R8.2
OUT_C_0: IC2.5 (IN1), IC6.33 ((ADC4/PCINT4)PA4), R5.2
OUT_C_1: IC2.6 (IN2), IC6.32 ((ADC5/PCINT5)PA5), R11.2
OUT_D_0: IC3.5 (IN1), IC6.31 ((ADC6/PCINT6)PA6), R17.2
OUT_D_1: IC3.6 (IN2), IC6.30 ((ADC7/PCINT7)PA7), R23.2
OUT_E_0: IC6.9 ((RXD0/PCINT24)PD0), IC9.5 (IN1), R45.2
OUT_E_1: IC6.10 ((TXD0/PCINT25)PD1), IC9.6 (IN2), R49.2
OUT_F_0: IC6.11 ((RXD1/INT0/PCINT26)PD2), IC8.5 (IN1), R48.2
OUT_F_1: IC6.12 ((TXD1/INT1/PCINT27)PD3), IC8.6 (IN2), R42.2
OUT_G_0: IC6.13 ((XCK1/OC1B/PCINT28)PD4), IC7.5 (IN1), R37.2
OUT_G_1: IC6.14 ((OC1A/PCINT29)PD5), IC7.6 (IN2), R35.2
OUT_H_0: IC5.5 (IN1), IC6.15 ((OC2B/ICP/PCINT30)PD6), R30.2
OUT_H_1: IC5.6 (IN2), IC6.16 ((OC2A/PCINT31)PD7), R28.2
SCK: CONN.13 (13_SCK), IC6.3 ((SCK/PCINT15)PB7)
TCK: IC6.21 ((TCK/PCINT18)PC2), JP1.1
TDI: IC6.24 ((TDI/PCINT21)PC5), JP1.9
TDO: IC6.23 ((TDO/PCINT20)PC4), JP1.3
TMS: IC6.22 ((TMS/PCINT19)PC3), JP1.5

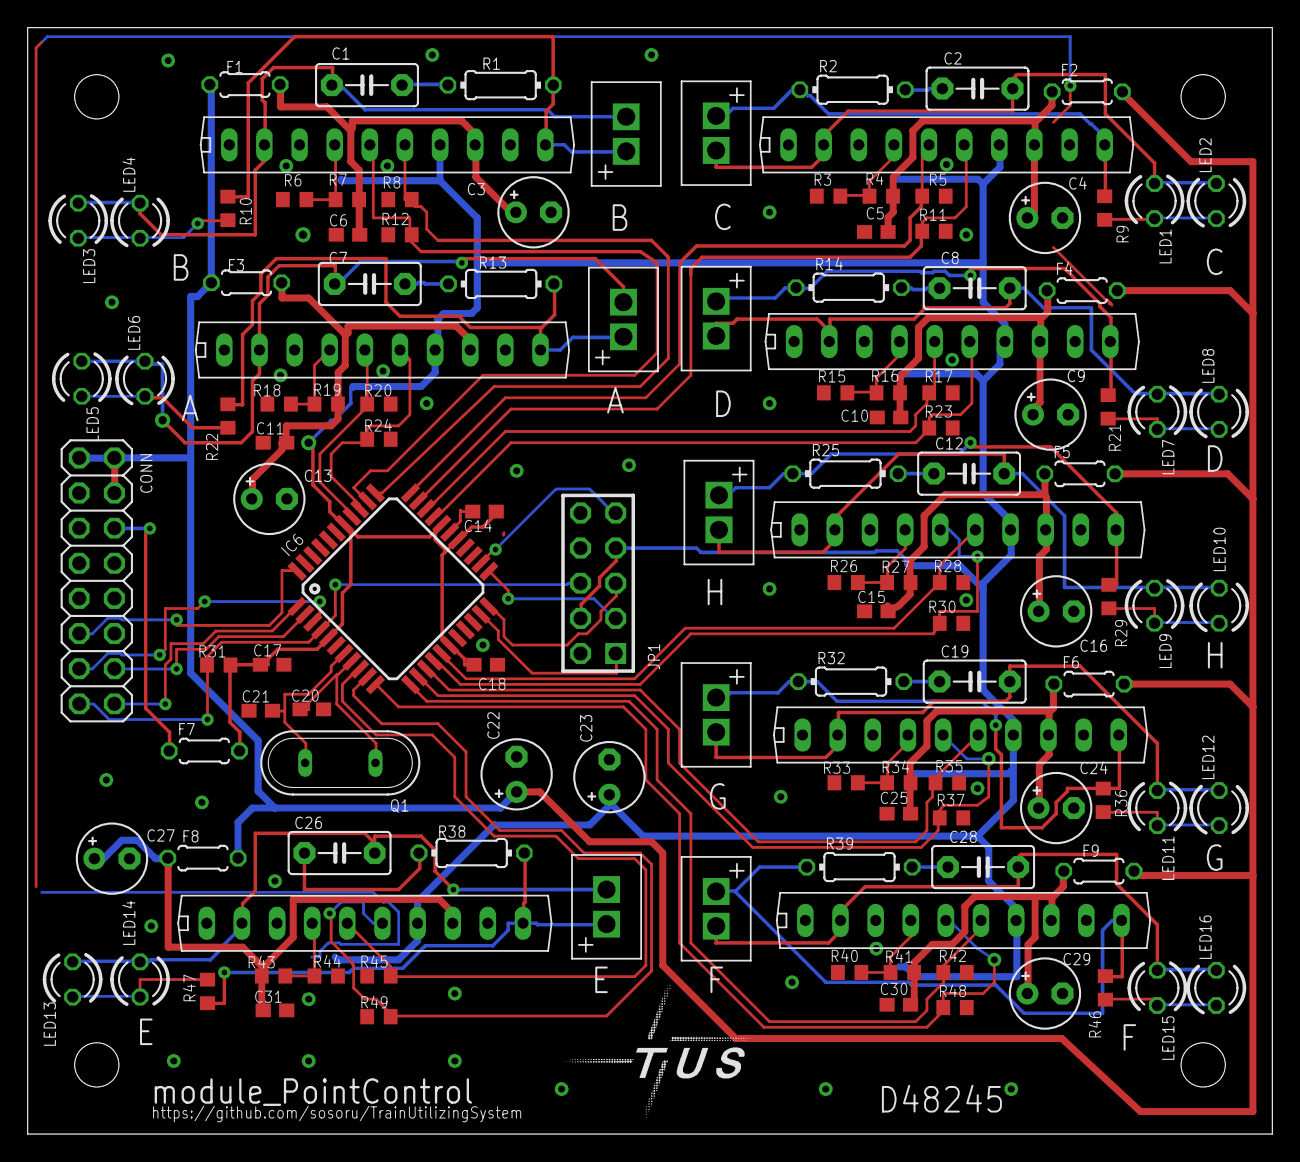
[picture p34: board PointController.brd from above]

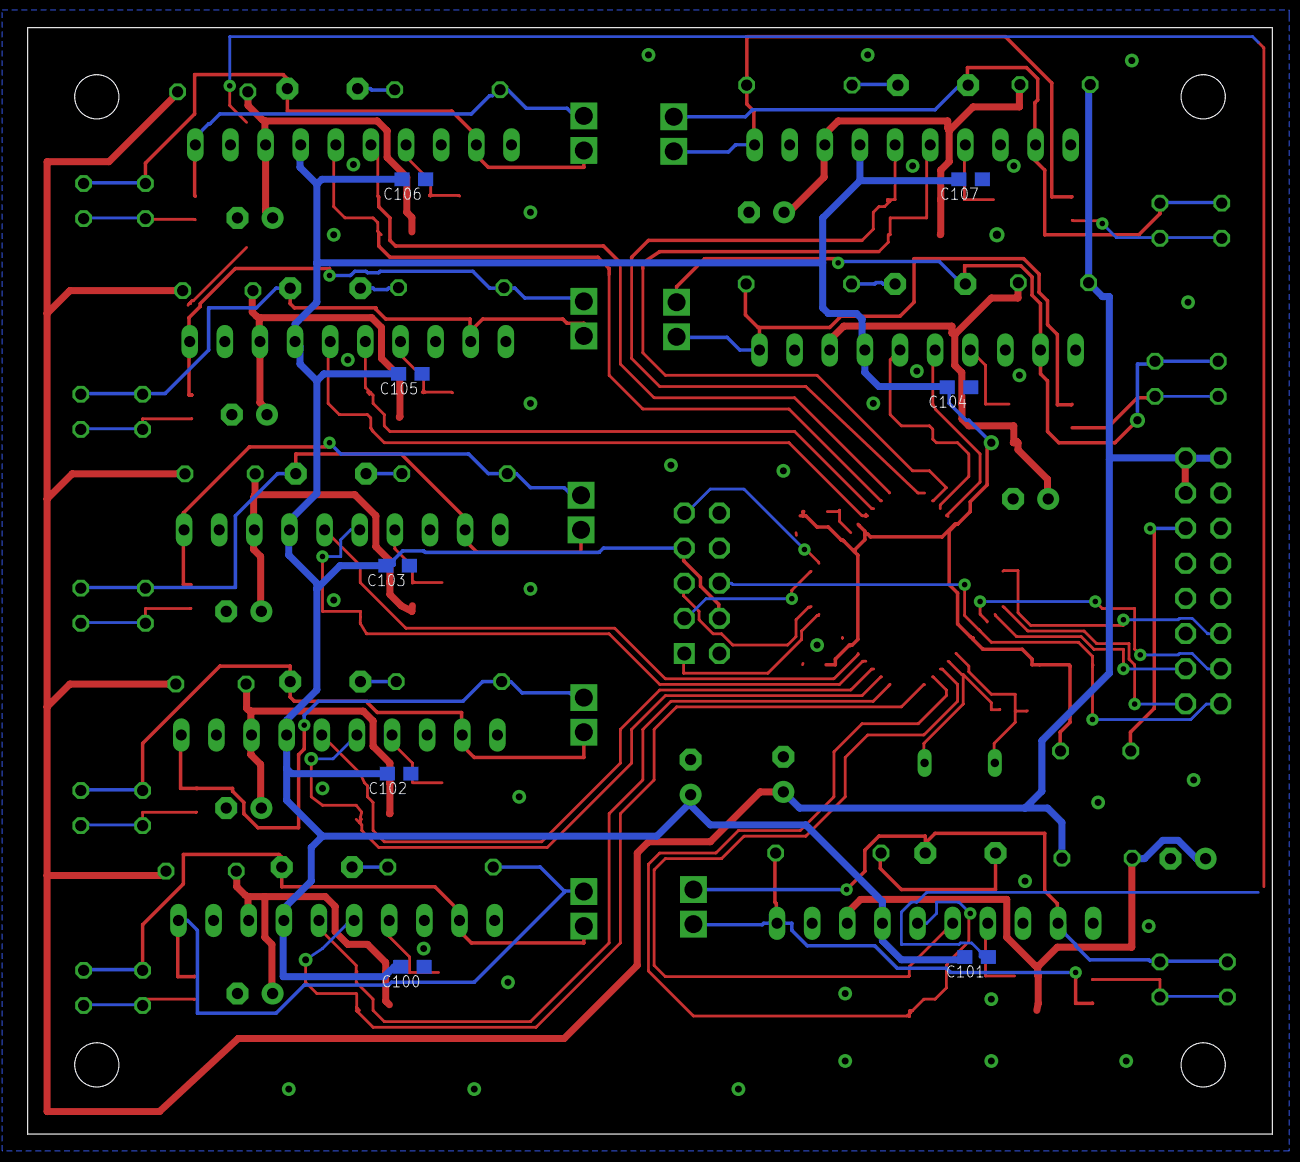
[picture p35: board PointController.brd from below]

Board: 2 copper layers, 90.0 x 80.0 mm, 133 parts (8 on the bottom side), 79 nets.
