sosoru/TrainUtilizingSystem/Schematics/EthControlling/AtxPowerDispatcher.brd

## EAGLE design Schematics/EthControlling/AtxPowerDispatcher.brd (2012-04-20)

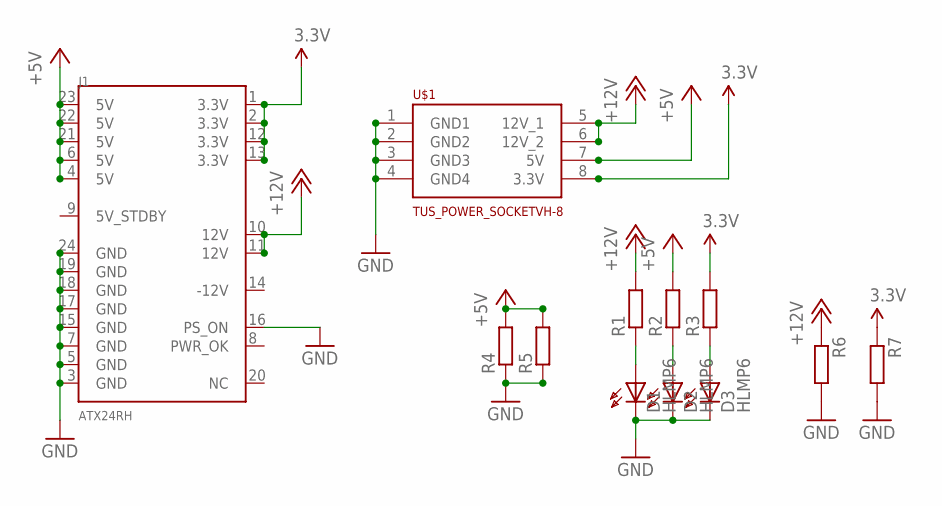
[picture p36: schematic AtxPowerDispatcher2.sch]

Parts:
D1: HLMP6
D2, D3: HLMP6; MPN HLMP-6500
J1: ATX24RH; ATX24_RIGHT_ANGLE
R1, R2, R3: R-EU_0207/7; 0207/7
R4, R5: R-EU_0922/22; 0922/22
R6, R7: R-EU_0414/15; 0414/15
U$1: TUS_POWER_SOCKETVH-8; VH_8

Connections:
3.3V: J1.1 (3.3V), J1.2 (3.3V), J1.12 (3.3V), J1.13 (3.3V), R3.2, R7.1, U$1.8 (3.3V)
+5V: J1.4 (5V), J1.6 (5V), J1.21 (5V), J1.22 (5V), J1.23 (5V), R2.2, R4.2, R5.2, U$1.7 (5V)
+12V: J1.10 (12V), J1.11 (12V), R1.2, R6.1, U$1.5 (12V_1), U$1.6 (12V_2)
GND: D1.K, D2.K, D3.K, J1.3 (GND), J1.5 (GND), J1.7 (GND), J1.15 (GND), J1.16 (PS_ON), J1.17 (GND), J1.18 (GND), J1.19 (GND), J1.24 (GND), R4.1, R5.1, R6.2, R7.2, U$1.1 (GND1), U$1.2 (GND2), U$1.3 (GND3), U$1.4 (GND4)
unnamed: D1.A, R1.1
unnamed: D2.A, R2.1
unnamed: D3.A, R3.1

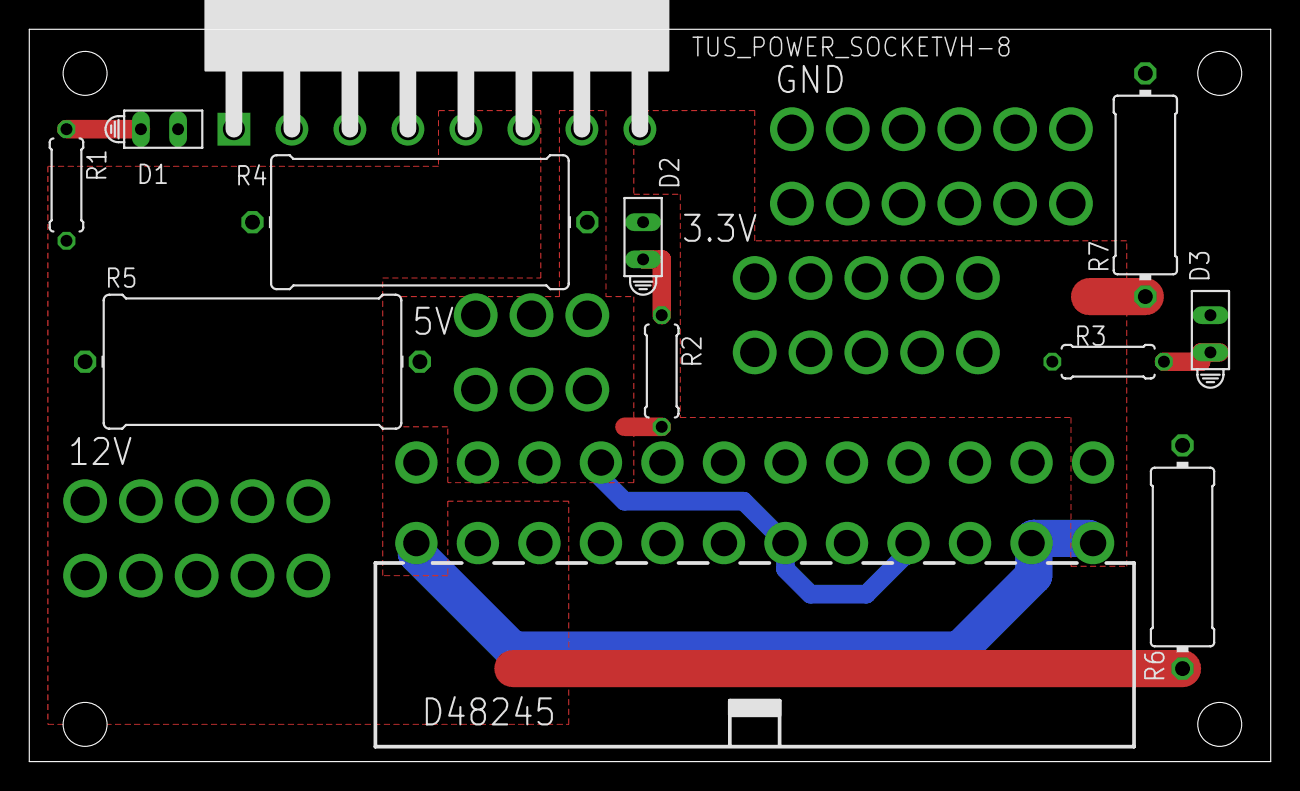
[picture p37: board AtxPowerDispatcher.brd from above]

Board: 2 copper layers, 84.8 x 50.0 mm, 12 parts (0 on the bottom side), 7 nets.
