sosoru/TrainUtilizingSystem/DeviceSoftware/TusDevice/module_ledController/module_ledController.h

/*
 * module_ledController.h
 *
 * Created: 2013/06/06 16:25:43
 *  Author: Administrator
 */ 


#ifndef MODULE_LEDCONTROLLER_H_
#define MODULE_LEDCONTROLLER_H_





#endif /* MODULE_LEDCONTROLLER_H_ */
