sosoru/TrainUtilizingSystem/DeviceSoftware/TusDevice/ph_TrainSensor/ph_TrainSensor.c

/*
 * ph_TrainSensor.c
 *
 * Created: 2012/02/07 5:55:08
 *  Author: root
 */ 

#include "global.h"
#include "string.h"
#include <avr/io.h>
#include <avr/interrupt.h>
#include <util/delay.h>
#include "suart.h"
#include "../module_UartControl/UartPacket.h"

#define nop() __asm__ __volatile__ ("nop")

#define UARTDEV_ID_TRAINSENSOR 0x01

#define SENDING_TYPE			UARTDEV_ID_TRAINSENSOR
#define SENDING_PACKET_SIZE		sizeof(UsartPacket_sensor)
#define ENTER_PARENT_TRANSFER	sbi(DDRB, 3);
#define LEAVE_PANRET_TRANSFER	cbi(DDRB, 3);

UsartDevicePacket_Header received_head;
uint8_t received_data[MAX_SIZE_USARTDATA];
uint8_t current_adc;

void device_init();
uint8_t validate_received_packet();
void receive_packet();
void send_parent_packet();
void send_parent_error();
void send_neighbor_packet();

ISR(ADC_vect)
{
	current_adc = current_adc / 2 + ADCL / 2;
	
	sbi(TIFR0, TOV0);
}

void send_neighbor_packet()
{
	uint8_t *ptr;
	
	received_head.number++;
	received_head.checksum_all++;

	xmit(received_head.type);
	xmit(received_head.packet_size);
	xmit(received_head.number);
	xmit(received_head.checksum_all);		

	ptr = received_data;
	while(ptr < received_data + received_head.packet_size)
	{
		xmit(*(ptr++));
	}
}

void send_parent_error()
{	
	ENTER_PARENT_TRANSFER
	
	xmit_parent(SENDING_TYPE);
	xmit_parent(0); //packet size
	xmit_parent(0xFF); //number
	xmit_parent(SENDING_TYPE ^ 0xFF);
	
	LEAVE_PANRET_TRANSFER
}

void send_parent_packet()
{	
	uint8_t checksum, number;
	uint8_t adc = current_adc;	
	
	number = received_head.number;
	checksum = (SENDING_TYPE ^ SENDING_PACKET_SIZE ^ number ^ adc);
	
	ENTER_PARENT_TRANSFER	
	xmit_parent(SENDING_TYPE);
	xmit_parent(SENDING_PACKET_SIZE);
	xmit_parent(number);
	xmit_parent(checksum);
	
	xmit_parent(adc);
	LEAVE_PANRET_TRANSFER
}

void receive_packet()
{		
	uint8_t *ptr;
	
	received_head.type = rcvr();
	received_head.packet_size = rcvr();
	received_head.number = rcvr();
	received_head.checksum_all = rcvr();
	
	if(received_head.packet_size > MAX_SIZE_USARTDATA)
		received_head.packet_size = MAX_SIZE_USARTDATA;
	
	ptr = received_data;
	while(ptr < received_data + received_head.packet_size)
	{
		*(ptr++) = rcvr();
	}
}

uint8_t validate_received_packet()
{
	uint8_t checking=0;
	uint8_t *ptr;
	
	checking ^= received_head.type;
	checking ^= received_head.number;
	checking ^= received_head.packet_size;
	
	ptr = received_data;
	while(ptr < received_data + received_head.packet_size)
	{
		checking ^= *(ptr++);
	}
	
	return checking == received_head.checksum_all;
}

void device_init()
{	
	PUEB	= 0b00000001;
	DDRB	= 0b11110100;

	// Timer 0 initializing
	OCR0AL = 16;			// 512usec at 8MHz
	TCCR0A |= 0b00000011;
	//TIMSK0 |= 0b00000001;	// interrupts enable
	TCCR0B |= 0b00011000;	// set to 8bit fast pwm (top=OCR0A)	
	TCCR0B |= 0b00000100;	// set prescale to f_osc/256 and starts Timer0
		
	// adc initialzing
	sbi(ADCSRA, ADIE); // ADC interrupt enable	
	ADMUX = 0;			
	sbi(DIDR0, ADC0D); // ADC0 enable
	ADCSRA |= 0b00000111; // CK/128
	ADCSRB = 0b100;		// triggering source is timer0 overflowing
	sbi(ADCSRA, ADATE); // Auto-trigger enabled
	sbi(ADCSRA, ADEN); // A/D converter enable
	sbi(ADCSRA, ADSC); // A/D convetsion is started
	
	memset(&received_head, 0x00, sizeof(received_head));
	memset(received_data, 0x00, sizeof(received_data));
	received_head.checksum_all = 0xff;
	current_adc = 0;
	
	sei();	// interrupt enable
	
}

void wait_collision()
{
	uint8_t i=200, result=1, current;
	
	while(i--)
	{
		nop();
		nop();
		nop();
		nop(); // 1us at 8MHz
		
		current = PINB & (1 << PINB1);
		if(result != current)
		{
			i=200;
		}
		result = current;
	}
	
}

int main(void)
{
	RSTFLR = 0;
	
	CCP = 0xD8;
    CLKMSR = 0x00;  // internal 8MHz
    CCP = 0xD8;
    CLKPSR = 0x00; // prescale = 1
	
	device_init();
			
    while(1)
    {
		receive_packet();
		
		if(validate_received_packet())
		{
			send_parent_packet();
			send_neighbor_packet();
		}		
		else
		{
			send_parent_error();
			wait_collision();
		}
	}
	
	return 0;
}
