sosoru/TrainUtilizingSystem/DeviceSoftware/TusDevice/module_PointController/module_PointController.hpp

/*
 * module_PointController.hpp
 *
 * Created: 2012/04/30 22:10:39
 *  Author: Administrator
 */ 


#ifndef MODULE_POINTCONTROLLER_H_
#define MODULE_POINTCONTROLLER_H_

#include <IO.h>
#include <DiverseIO.h>
#include <Assembler.h>
#include <Interrupt.h>
#include <ExternalInterrupt.h>
#include <Timer.h>
#include <Sleeping.h>
#include <ADC.h>
#include <EEPROM.h>
#include <USART.h>
#include <Delegate.h>
#include <StaticArray.h>
#include <DynamicArray.h>
#include <StaticQueue.h>
#include <PeekableStaticQueue.h>

#include <math.h>
#include "../libtus/packet.h"

#define F_CPU 20000000

#endif /* MODULE_POINTCONTROLLER_H_ */
