sosoru/TrainUtilizingSystem/DeviceSoftware/TusDevice/EthernetBridge/EthernetBridge.h

/*
 * EthernetBridge.h
 *
 * Created: 2012/01/04 16:08:17
 *  Author: root
 */ 


#ifndef ETHERNETBRIDGE_H_
#define ETHERNETBRIDGE_H_

#include "../libtus/packet.h"

extern BYTE g_parentid;



#endif /* ETHERNETBRIDGE_H_ */
