sosoru/TrainUtilizingSystem/DeviceSoftware/ModuleCodes/PointModuleProcess.c

#include "HardwareProfile.h"
#include "../Headers/ModuleBase.h"
#include "../Headers/MotherBoardModule.h"
#include "../Headers/PointModule.h"
#include "../Headers/PortMapping.h"
#include <stdlib.h>
#include <string.h>
#include <adc.h>

BYTE IsStoring = FALSE;
BYTE IsCreating = FALSE;
BYTE SendingPointInd = 0x00;

void ReadPointModuleSavedState(DeviceID * pid, PointModuleSavedState * psaved);
void WritePointModuleSavedState(DeviceID * pid, PointModuleSavedState * psaved);

void StateToSaved(PointModuleState* pstate, PointModuleSavedState* psaved);
void SavedToState(PointModuleSavedState* psaved, PointModuleState* pstate);

void StateToSaved(PointModuleState* pstate, PointModuleSavedState* psaved)
{
	memcpy((void*)psaved->directions, (void*)pstate->directions, SIZE_POINTMODULESTATE_DIRECTIONS);
}

void SavedToState(PointModuleSavedState* psaved, PointModuleState* pstate)
{
	memcpy((void*)pstate->directions, (void*)psaved->directions, SIZE_POINTMODULESTATE_DIRECTIONS);
}

void ReadPointModuleSavedState(DeviceID * pid, PointModuleSavedState * psaved)
{
	BYTE module = pid->ModuleAddr;
	
	ReadModuleSavedState(module, psaved);
}

void WritePointModuleSavedState(DeviceID * pid, PointModuleSavedState* psaved)
{
	BYTE module = pid->ModuleAddr;
	
	WriteModuleSavedState(module, psaved);
}


HRESULT GetFuncTablePointModule(DeviceID * pid, ModuleFuncTable* table)
{
	table->fncreate = CreatePointModuleState;
	table->fnstore = StorePointModuleState;
	table->fninit = InitPointModule;
	
	//table->fnclose = CloseEmpty;
	table->fninterrupt = InterruptPointModule;
	
	return S_OK;
}

HRESULT CreatePointModuleState(DeviceID * pid, PMODULE_DATA data)
{
	PointModuleState * pstate = (PointModuleState * ) data;
	PointModuleSavedState saved;
		
	IsCreating = TRUE;
	
	ReadPointModuleSavedState(pid, &saved);
	SavedToState(&saved, pstate);
	
	IsCreating = FALSE;
	
	return S_OK | REPEAT_TERMINATE;	
	
}

HRESULT StorePointModuleState(DeviceID * pid, PMODULE_DATA data)
{
	PointModuleState* pstate = (PointModuleState*)data;
	PointModuleSavedState saved;
	
	IsStoring = TRUE;
	StateToSaved(pstate, &saved);
	WritePointModuleSavedState(pid, &saved);
	
	IsStoring = FALSE;
	
	return S_OK;
}

HRESULT InitPointModule(DeviceID * pid)
{
	BYTE module = (pid->ModuleAddr-1) * PORT_PIN_COUNT + 1;
	
	setTris(module, INPUT_PIN); // analog
	setTris(module+1, OUTPUT_PIN);
	setTris(module+2, OUTPUT_PIN);
	setTris(module+3, OUTPUT_PIN);
	setTris(module+4, OUTPUT_PIN);
	setTris(module+5, OUTPUT_PIN);

	switch(pid->ModuleAddr) 
	{
		case 1:
			OpenADC(ADC_FOSC_4 & ADC_RIGHT_JUST & ADC_20_TAD,
			ADC_CH1 & ADC_INT_OFF & ADC_VREFPLUS_VDD & ADC_VREFMINUS_VSS,
			AD_PORT);
			break;
		case 2:
			OpenADC(ADC_FOSC_4 & ADC_RIGHT_JUST & ADC_20_TAD,
			ADC_CH0 & ADC_INT_OFF & ADC_VREFPLUS_VDD & ADC_VREFMINUS_VSS,
			AD_PORT);
			break;
		case 3:
			OpenADC(ADC_FOSC_4 & ADC_RIGHT_JUST & ADC_20_TAD,
			ADC_CH2 & ADC_INT_OFF & ADC_VREFPLUS_VDD & ADC_VREFMINUS_VSS,
			AD_PORT);
			break;
	}


	return S_OK;
}

void InterruptPointModule(DeviceID * pid)
{
	BYTE module = (pid->ModuleAddr-1) * PORT_PIN_COUNT + 1;
	PointModuleSavedState saved;
	
	if(IsStoring || IsCreating || g_usingAdc)
		return;
		
//	if(!getPort(module)) // device ack false
//		return;
	g_usingAdc = TRUE;
	switch(pid->ModuleAddr) 
	{
		case 1:
			SetChanADC(ADC_CH1);
			break;
		case 2:
			SetChanADC(ADC_CH0);
			break;
		case 3:
			SetChanADC(ADC_CH2);
			break;
	}
	ConvertADC();
	while(BusyADC());
	g_usingAdc = FALSE;
	
	if(ReadADC() <= 0x1FF) // device ask false
		return ;
		
	ReadPointModuleSavedState(pid, &saved);
	
	if(++SendingPointInd >= POINT_COUNT)
		SendingPointInd = 0;
		
	setLat(module+5, 0); // host ack disable
	
	setLat(module+1, saved.directions[SendingPointInd]&1);
	setLat(module+2, (SendingPointInd&1));
	setLat(module+3, (SendingPointInd&2)>>1);
	setLat(module+4, (SendingPointInd&4)>>2);
	
	setLat(module+5, 1); // host ack enable		

//	LATAbits.LATA4 = 0;
//	
//	LATA = 0b00001111 & (((SendingPointInd & 7)<<1) | (cachePointSaved.directions[SendingPointInd]&1));
//	
//	LATAbits.LATA4 = 1;
}
