sosoru/TrainUtilizingSystem/DeviceSoftware/TusDevice/EthernetBridgePp/EthernetBridge.hpp

/*
 * EthernetBridge.h
 *
 * Created: 2012/01/04 16:08:17
 *  Author: root
 */ 


#ifndef ETHERNETBRIDGE_H_
#define ETHERNETBRIDGE_H_

#include "avr_base.hpp"
#include "../libtus/packet.h"

//for boost including
#define BOOST_NO_STDLIB_CONFIG
//#define F_CPU 16000000UL

#endif /* ETHERNETBRIDGE_H_ */
