sosoru/TrainUtilizingSystem/DeviceSoftware/TusDevice/libtus/tus_cfg.h

/*
 * tus_cfg.h
 *
 * Created: 2012/01/21 11:51:59
 *  Author: root
 */ 


#ifndef TUS_CFG_H_
#define TUS_CFG_H_

#define TUS_CONTROL_PIN		PINB
#define TUS_CONTROL_PORT	PORTB
#define TUS_CONTROL_DDR		DDRB
#define TUS_CONTROL_MOSI	5
#define TUS_CONTROL_MISO	6
#define TUS_CONTROL_SCK		7
#define TUS_CONTROL_SS		4


#endif /* TUS_CFG_H_ */
