sosoru/TrainUtilizingSystem/DeviceSoftware/ModuleCodes/ModuleFuncDefs.c

#include "HardwareProfile.h"
#include "../Headers/ModuleFuncDefs.h"
#include "../Headers/MotherBoardModule.h"
#include <stdlib.h>
#include <string.h>

#if defined(VERSION_REV1) || defined (VERSION_REV2)
	#include "../Headers/MonoModules.h"
#elif defined(CONTROLLER_DEIVCE_REV1)
	#include "../Headers/ControllerModule.h"
#endif

//ModuleFuncTable g_ModuleFuncLower[SIZE_SPLITED_FUNCTABLE];
//ModuleFuncTable g_ModuleFuncHigher[SIZE_SPLITED_FUNCTABLE];
ModuleFuncTable g_ModuleFunc[MODULE_COUNT];

void SetFuncTable()
{
	MotherBoardSavedState state;
	DeviceID id;
	BYTE i;
	
	ReadMotherBoardSavedState(&state);
	if(READ_MBSTATE_MODULETYPE(state, 0) != MOTHER_BOARD_MODULE_TYPE)
	{
		memset((void*)&state, 0xFF, (size_t)sizeof(MotherBoardSavedState));
		WRITE_MBSTATE_MODULETYPE(state,0, MOTHER_BOARD_MODULE_TYPE);
			
		WriteMotherBoardSavedState(&state);
	}
	
	id.ParentPart = state.ParentId;
	for(i = 0; i < MODULE_COUNT; i++)
	{
		id.ModuleAddr = i;
		InitializeTable(&id, (BYTE)READ_MBSTATE_MODULETYPE(state, i), GET_FUNC_TABLE(i));
	}
	
	id.ModulePart = 0x00;
	GET_FUNC_TABLE(0)->fninit(&id);
}

void InitializeTable(DeviceID* pid, BYTE moduletype, ModuleFuncTable* ptable)
{
	BYTE empty = 0;
	HRESULT res = 0;
	switch(moduletype)
	{
#ifdef TRAIN_SENSOR_MODULE_TYPE
		case TRAIN_SENSOR_MODULE_TYPE:
			if(FAILED(GetFuncTableTrainSensor(pid, ptable)))
			{
				empty = 1;
			}
		break;
#endif

#ifdef MOTHER_BOARD_MODULE_TYPE
		case MOTHER_BOARD_MODULE_TYPE:
			if(FAILED(GetFuncTableMotherBoard(pid, ptable)))
			{
				empty = 1;
			}
		break;
#endif

#ifdef POINT_MODULE_MODULE_TYPE
		case POINT_MODULE_MODULE_TYPE:
			if(FAILED(GetFuncTablePointModule(pid, ptable)))
			{
				empty = 1;
			}
		break;
#endif

#ifdef TRAIN_CONTROLLER_MODULE_TYPE
		case TRAIN_CONTROLLER_MODULE_TYPE:
			if(FAILED(GetFuncTableTrainController(pid, ptable)))
			{
				empty = 1;
			}
		break;
#endif

#ifdef REMOTE_MODULE_MODULE_TYPE
		case REMOTE_MODULE_MODULE_TYPE:
			if(FAILED(GetFuncTableRemoteModule(pid, ptable)))
			{
				empty = 1;
			}
		break;
#endif

		default:
			empty = 1;
		break;
	}
	
	if(empty)
	{
		ptable->fncreate = CreateEmptyState;
		ptable->fnstore = StoreEmptySavedState;
		ptable->fninit = InitEmpty;
		//ptable->fnclose = CloseEmpty;
		ptable->fninterrupt = InterruptEmpty;
	}
}
