sosoru/TrainUtilizingSystem/ServerUtility/TusSolution/TusTestProject/SampleLayout/815.yaml

-
  name : AT1
  route : PT1 <> PT2
  sensor :
    addr : (24, 4, 18); (24, 4, 19)
    
-
  name : AT2
  route : PT1 <> PT2
  sensor :
    addr : (24, 4, 16); (24, 4, 17)
  
-
  name : BT1
  route : PT2 <> PT3
  motor :
    addr : (24, 2, 1)
    pos : PT2 > PT3
    neg : PT2 < PT3
  
-
  name : CT1
  route : PT3 <> PT4
  sensor :
    addr : (24, 4, 34); (24, 4, 35)
  
-
  name : CT2
  route : PT3 <> PT4
  sensor :
    addr : (24, 4, 32); (24, 4, 33)
  
-
  name : DT1
  route : PT1 <> PT4
  motor :
    addr : (24, 2, 2)
    pos : PT4 > PT1
    neg : PT4 < PT1
  
-
  name : PT1
  route : DT1 <> AT1, AT2
  point :
    addr : (24, 1, 1)
    s : DT1 <> AT1
    c : DT1 <> AT2
  
-
  name : PT2
  route : BT1 <> AT1, AT2
  point : 
    addr : (24, 1, 2)
    s : BT1 <> AT1
    c : BT1 <> AT2
  
-
  name : PT3
  route : BT1 <> CT1, CT2
  point : 
    addr : (24, 1, 3)
    s : BT1 <> CT1
    c : BT1 <> CT2
    
-
  name : PT4
  route : DT1 <> CT1, CT2
  point : 
    addr : (24, 1, 4)
    s : DT1 <> CT1
    c : DT1 <> CT2
  
