sosoru/TrainUtilizingSystem/ServerUtility/TusSolution/TusTestProject/SampleLayout/point_sample.yaml

-
  name : AT1
  route : nil <> AT2
  motor :
    addr : (1, 1, 1)
    pos : nil > AT2
    neg : nil < AT2
-
  name : AT2
  route : AT1 <> BT3, AT3
  switch :
    addr : (1, 2, 1)
    s : AT1 <> AT3
    c : AT1 <> BT3
-
  name : BT3
  route : AT2 <> AT4
  sensor :
    addr : (1, 3, 1)
-
  name : AT3
  route : AT2 <> AT4
  sensor : 
    addr : (1, 3, 2)
-
  name : AT4
  route : BT3, AT3 <> AT5
  switch :
    addr : (1, 2, 2)
    s : AT3 <> AT5
    c : BT3 <> AT5
  motor :
    addr : (1, 1, 2)
    pos : BT3, AT3 > AT5
    neg : BT3, AT3 < AT5
-
  name : AT5
  route : AT4 <> nil
  motor :
    addr : (1, 1, 3)
    pos : AT4 > nil
    neg : AT4 < nil
 
