sosoru/TrainUtilizingSystem/(commit log)

2011-07-19 add files about pic devices
2011-07-20 Device: sepalate header files
2011-07-23 Device: TrainController supports reading feedback voltage, and following ServerUtility supports it. (not debuged)
2011-07-25 Debug Point 1 : TrainController supporting feeding back voltage
2011-07-26 Debug Point 2: Implement PID Control on TrainController and Refactor the classes of TrainSensors (not debuging)
2011-08-01 Device: TrainController uses two ccp
2011-08-04 add prototype of visualizing project and modify motherboard packet checking strategy
2011-08-07 Device: Support for transmitting remote device by SPI (not debugged)
2011-08-10 Debug : device traincontroller for checking BEMF
2011-08-11 Schematics uploade
    [TrSensorModule.brd, TrSensorModule.sch, TrainAcceralator.sch, budget.ods, mono.sch, mono2.brd, mono2.sch, mono3.sch]
2011-08-14 Refactor DeviceServer : define factory class, Implement PendingList in remotemodule on Device
    [TrSensorModule.brd, TrSensorModule.sch, mono3.sch]
2011-09-08 TrSensorDev: Replace pic to 16f628a, Serv: Change drawing voltage graph by DxWrapper to Wpf geometry
    [TrSensorModule.brd, TrSensorModule.sch, TrainSensorModule.obj, mono3.sch, startup.obj]
2011-09-13 Refactor VoltageGraph (drawing by Wpf Animation)
    [TrSensorModule.brd, TrSensorModule.sch, mono3.sch]
2011-09-17 Debuged TrainSensor
    [TrSensorModule.brd, TrSensorModule.sch, TrainSensorModule.obj]
2011-09-19 Update PointModule schematics; Refactor PointModule device
    [pointModule.brd, pointModule.sch]
2011-09-20 Implement pullup-resistors and crumping diodes on signal lines
    [TrSensorModule.brd, TrSensorModule.sch, pointModule.brd, pointModule.sch]
2011-09-22 Update usb library of devices
    [PowerDispatcher.brd, PowerDispatcher.sch, mono3.brd, mono3.sch]
2011-09-23 modify bit manipulation on devices
    [mono3.brd, mono3.sch]
2011-09-23 rollback sending signals on devices
2011-09-23 remove ver1 on device of traincontroll
2011-09-23 show ids of the devices on serverutility
2011-09-23 update mono3 schematics
    [mono3.brd, mono3.sch]
2011-09-23 update port alignments on devices
2011-09-24 create SensorLibrary for sharing mvvm components
2011-09-25 upload LightFlicker schematics
    [LightFlicker.brd, LightFlicker.sch, mono3.brd, pointModule.brd]
2011-09-26 impl control methods on devices
    [outline.brd]
2011-09-28 restore developing environment, refactor usb and device mvvm
2011-09-29 impl pointModule comparer, refactor viewmodel projection and impl manipulating collection by System.Threading.Dispatcher on utility
2011-10-01 fix analog channels on devices
    [TrSensorModule.sch]
2011-10-01 impl pointmanipulate on utility (large debut)
    [mono3.brd, mono3.sch]
2011-10-01 update point manipulating for exhivision
    [mono3.brd, mono3.sch]
2011-10-03 delay interrupt interval on device; refactor trainsensor (delete meisuring and detecting device class)
    [mono3.brd, mono3.sch, pointModule.brd, pointModule.sch]
2011-10-05 refactor mvvm device classes on utility
2011-10-05 fix TrainSensor store method on device
    [TrainSensorProcess.c]
2011-10-07 fix gerberdata and rebinding some modules on utility
    [PowerDispatcher.brd, PowerDispatcher.sch, TrSensorModule.brd, mono3.brd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]
2011-10-11 impl debug pin on schematics, connect unconnectedpin on mono3 shcematics and impl device query and factory
    [TrSensorModule.brd, TrSensorModule.sch, mono3.brd, mono3.sch, pointModule.brd, pointModule.sch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]
2011-10-15 refactor factries on utility
    [pointModule.brd, pointModule.sch]
2011-10-19 restore paramP
    [pointModule.brd, pointModule.sch]
2011-10-21 dbg trcontroller on device
    [mono3.brd]
2011-10-22 abandon low-level interruption on device
2011-10-24 impl pid auto tuning on utility and fix mono3 on schematics
    [mono3.brd, mono3.sch]
2011-10-24 following duty ratio when changed period on utility and fix pointmodule storing method on device
    [pointModule.brd]
2011-10-24 ditto : fix schematics
    [pointModule.brd]
2011-10-25 fix schematics to output and fix packet id struct alignment on devices
    [PowerDispatcher.brd, TrSensorModule.brd, mono3.brd, mono3.sch, pointModule.brd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]
2011-10-25 disable interruption priority on device
2011-10-25 impl lower freqency train control on device
2011-10-29 debug lower frequency on device
2011-10-29 debug TrainController View on utility and create PlatformLight Powering board
    [plat_40pinControlSimple.brd, plat_40pinControlSimple.sch, plat_4pinTo40pin.brd, plat_4pinTo40pin.sch]
2011-11-01 add platformloght powering schematics; debug ditto
    [plat_40pinControlSimple.brd]
2011-11-01 modify HRESULT comparison when succeeded on device
2011-11-01 re-add platform powering schematics
    [plat_40pinControlSimple.drl]
2011-11-02 debug trainsensor, enable GIE bit when sending packet by usb on device
2011-11-07 improve trainsensor detecting process on utility
    [plat_40pinControlSimple.brd, plat_40pinControlSimple.sch]
2011-11-08 fix shcematics land width; create splash screen project
    [TrSensorModule.brd, TrSensorModule.sch, mono3.brd, mono3.sch, pointModule.brd, pointModule.sch]
2011-11-11 add spacer on schematics; impl device remove event
    [plat_40pinControlSimple.brd, plat_40pinControlSimple.sch, plat_4pinTo40pin.brd, plat_4pinTo40pin.sch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]
2011-11-12 mod itemspanel of device view on utility
2011-11-13 modify the schematics of platform powering device to be connectable by ide cable;and impl strategies to control points
    [plat_40pinControlSimple.brd, plat_40pinControlSimple.sch, plat_4pinTo40pin.brd, plat_4pinTo40pin.sch]
2011-11-27 impl components of railroader data reader; recreate TusSolution file
2011-11-29 impl rail viewmodel and refactor its components
2011-11-29 impl railelements viewmodels
2011-11-29 impl test for railelements and debgu them
2011-11-29 impl IEqualable<> to rail elements (not effective implement)
2011-11-29 debug loading railroader layout (confused point drawing)
2011-12-05 [temp] debug railviewmodel
2011-12-07 create EthernetBridge, EthernetBoard on schematics
    [EthernetBoard.brd, EthernetBoard.sch, EthernetBridge.brd, EthernetBridge.sch]
2011-12-08 impl port 6 -> 8 and EthernetBoard on EthernetBridge
    [EthernetBoard.brd, EthernetBridge.brd, EthernetBridge.sch]
2011-12-12 ebit ethernet schematics; impl lcd driver on device; debug layoutview on RouteVisualizer
    [EthernetBridge.brd, EthernetBridge.sch]
2011-12-13 debug lcd driver
2011-12-14 debug lcd test
    [EthernetBridge.brd, EthernetBridge.sch]
2011-12-20 change DeviceId Size (not changed on usb devices)
2012-01-06 some schematics changed
    [EthernetBridge.brd, EthernetBridge.sch]
2012-01-28 schematics update
    [EthernetBoard_panel.brd, EthernetBridge.brd, EthernetBridge.sch, MotorController.brd, MotorController.sch, PointController.brd, PointController.sch, sample.brd]
2012-02-05 add files of device software newly created
    [MotorController.brd, MotorController.sch]
2012-02-10 create route test; board edit
    [EthernetBridge.brd, EthernetBridge.sch, PointController.brd, PointController.sch]
2012-04-20 refactoring Schematics directory and add new files
    [AtxPowerDispatcher.brd, AtxPowerDispatcher.sch, EthernetBoard.brd, EthernetBoard.sch, EthernetBoardPanel.brd, EthernetBoardPanel.sch, EthernetBridge.brd, EthernetBridge.sch]
2012-04-20 add some device codes
2012-04-20 add submittted garber datas
    [D48245_1_10x10.GBL, D48245_1_10x10.GBO, D48245_1_10x10.GBS, D48245_1_10x10.GTL, D48245_1_10x10.GTO, D48245_1_10x10.GTS, D48245_2_10x10.GBL, D48245_2_10x10.GBO]
2012-04-21 testing software of motor controller for the submitted board module_Motorcontroller complile completed
2012-04-22 test of motor controlling device
2012-04-30 add new schematics : tus board
    [Box_Bottom.brd, Box_Side.brd, Box_Top.brd]
2012-05-15 add newer sensor controller schematic
    [SensorController.sch, SensorController_revB.brd, SensorController_revB.sch]
2012-05-18 impl of sc2004 driver
2012-05-18 fix some compile errors
    [EthernetBridge.cpp]
2012-05-23 restore repository
    [Box_Bottom.brd, SerialTrainSensor.brd, SerialTrainSensor.sch]
2012-05-23 impl switch module on software
2012-05-23 modify schematics
    [Box_Bottom.brd, Box_Top.brd]
2012-05-25 fix posiitons on schematics of tus_box
    [Box_Bottom.brd, Box_Side.brd, Box_Top.brd]
2012-05-27 wired SerialTrainSensor RevB
    [SerialTrainSensor.brd, SerialTrainSensor.sch]
2012-05-27 add drill rule file of FusionPCB
2012-06-11 compiled writing logic for lcd device
2012-06-12 hand wiring
2012-06-12 reallocate directories on submitted schematics
    [D48245_1_10x10.GBL, D48245_1_10x10.GBO, D48245_1_10x10.GBS, D48245_1_10x10.GTL, D48245_1_10x10.GTO, D48245_1_10x10.GTS, D48245_2_10x10.GBL, D48245_2_10x10.GBO]
2012-06-12 move tus mark on board of trsensor, and create gerbers
    [SerialTrainSensor.brd]
2012-06-12 commit gerbers
    [SensorController_revB.GBL, SensorController_revB.GBO, SensorController_revB.GBP, SensorController_revB.GBS, SensorController_revB.GTL, SensorController_revB.GTO, SensorController_revB.GTP, SensorController_revB.GTS]
2012-06-17 edit code for evaluating motor and point controller, and reconstructing budget
2012-06-20 fix wiring of MotorController.sch and clear DRC errors
    [MotorController.brd, MotorController.sch]
2012-06-20 renumber MotorController.brd
    [MotorController.brd, MotorController.sch]
2012-06-21 fixed clearance error in MotorController.brd
    [MotorController.brd]
2012-06-21 identify schematics by the order number on schematics and submitted gerber files
    [D53371_10x10_1.GBL, D53371_10x10_1.GBO, D53371_10x10_1.GBP, D53371_10x10_1.GBS, D53371_10x10_1.GTL, D53371_10x10_1.GTO, D53371_10x10_1.GTP, D53371_10x10_1.GTS]
2012-06-23 associating parts of MotorController
2012-06-24 associate of parts of SensorController_revB
    [SensorController_revB.brd, SensorController_revB.sch]
2012-07-10 fix box hole position
    [Box_Side.brd, Box_Top.brd]
2012-07-10 fix resistor value of MotorController
    [MotorController.brd, MotorController.sch]
2012-07-25 impl classes and tests of avr devices
2012-07-25 refactoring file allocation on SensorLibrary
2012-07-25 refactoring namespaces of SensorLibrary
2012-07-27 refactoring: device factories for impling avr devices
2012-08-02 add Box_WirePanel.brd
    [Box_WirePanel.brd]
2012-08-04 fix pin defines of SerialTrainSensor
    [module_UartControl.cpp, ph_TrainSensor.c]
2012-08-05 fix DeviceID member alignment on device side
    [EthConfig.hpp, EthernetBridge.cpp, module_UartControl.cpp, packet.h]
2012-08-05 debuging device transfer
    [SerialTrainSensor.brd, SerialTrainSensor.sch]
2012-08-15 done for cheching devices, sensors and points
2012-09-22 fixed train sensor board
    [EthernetBridge.brd, SerialTrainSensor.brd, SerialTrainSensor.sch]
2012-09-29 fixed controling of child board
    [EthernetBridge.cpp, ip_arp_udp_tcp.hpp]
2012-10-04 fix trainsensor, and add 'nothing' token as block
    [UartConfig.hpp, UartModule.hpp, module_UartControl.cpp, ph_TrainSensor.c]
2012-10-06 fix uart contorller for 1004
    [UartConfig.hpp, UartModule.hpp, module_UartControl.cpp]
2012-10-06 train sensor works
2012-10-16 add a resistor to transfer on TrSensor
    [SerialTrainSensor.brd, SerialTrainSensor.sch]
2012-10-16 add Led Controlling board an Emergency Switch board
    [EmergencySwitch.brd, EmergencySwitch.sch, pikahome.brd, pikahome.sch]
2012-10-16 add submitted gerber datas
    [D59557.GBL, D59557.GBO, D59557.GBP, D59557.GBS, D59557.GTL, D59557.GTO, D59557.GTP, D59557.GTS]
2012-10-22 add dialoging codes of MotorState and testing them
2012-10-22 add dialoging codes of switch controller and test them
2012-10-22 refactoring: separate device data serializing from device state
2012-10-23 impl packing device states to device packet
2012-10-23 apply packing for device code (motor controlling, ethernet bridge)
2012-10-23 impl avr kernel data, states and fix packed packet process in mtr device code
    [MotorProcess.hpp, module_MotorController.cpp, packet.h, tus_spi.c, tus_spi.h]
2012-10-23 [autosave] SensorLibrary/Packet/PacketDatas/AvrPacketDatas.cs
2012-10-23 [autosave] SensorLibrary/Devices/TusAvrDevices/KernelState.cs
2012-10-23 [autosave] SensorLibrary/Devices/TusAvrDevices/Kernel.cs
2012-10-23 [autosave] SensorLibrary/Devices/BasicDevices/DeviceFactory.cs
2012-10-23 [autosave] SensorLibrary/Packet/PacketDatas/PacketBasis.cs
2012-10-24 [autosave] TusSolution/RouteLibrary/Base/DeviceEffector.cs
2012-10-24 [autosave] SensorLibrary/Packet/PacketControl/PacketServer.cs
2012-10-25 impl motor current test
2012-10-26 separate packing packet on device side
2012-10-26 [autosave] SensorLibrary/Devices/TusAvrDevices/Sensor.cs
2012-10-26 [autosave] SensorLibrary/Devices/TusAvrDevices/SensorState.cs
2012-10-28 [autosave] SensorLibrary/Devices/TusAvrDevices/MotorState.cs
2012-10-28 [autosave] SensorLibrary/Devices/TusAvrDevices/MotorWaiting.cs
2012-10-28 [autosave] SensorLibrary/SensorLibrary.csproj
2012-10-28 [autosave] SensorLibrary/Devices/TusAvrDevices/ISensor.cs
2012-10-28 [autosave] SensorLibrary/Devices/TusAvrDevices/Motor.cs
2012-10-29 [autosave] SensorLibrary/Devices/BasicDevices/DeviceState.cs
2012-10-29 [autosave] SensorLibrary/Devices/BasicDevices/Device.cs
2012-10-31 [autosave] SensorLibrary/Devices/BasicDevices/KernelState.cs
2012-10-31 [autosave] SensorLibrary/Devices/BasicDevices/Kernel.cs
2012-11-02 [autosave] SensorLibrary/Packet/PacketIO/EthClient.cs
2012-11-03 [autosave] TestProject/SwitchStateTest.cs
2012-11-03 [autosave] SensorLibrary/Devices/TusAvrDevices/SwitchState.cs
2012-11-06 [autosave] TestProject/SampleLayout/point_sample.yaml
2012-11-15 [autosave] SensorLibrary/Packet/PacketIO/TusEthernetIO.cs
2012-11-16 [autosave] SensorLibrary/Packet/PacketIO/IDeviceIO.cs
2012-11-16 [autosave] SensorLibrary/Packet/PacketIO/USBGeneric.cs
2012-12-25 [autosave] TusSolution/DialogConsole/Factory/DeviceDefinitionFactory.cs
2012-12-25 [autosave] TusSolution/DialogConsole/Factory/DeviceControllerFactory.cs
2012-12-25 [autosave] TusSolution/DialogConsole/Properties/AssemblyInfo.cs
2012-12-29 extract Device classes and its factories to the new project : using MEF for factory classes
2012-12-29 sample files accessible as relative path
2012-12-30 Extract device communicating layer and device specificating layer from SensorLibrary to Tus.Communicate projects; delete SensorLibrary
2013-02-15 fix a bug that commands sending to devices is delaying
2013-04-06 閉塞極性の考慮とコンソールUIの改善．route inputのrevオプションを無効
2013-04-10 many vehicles に対応
2013-04-22 impl some attributes to MotorState, Motor, SwitchState, Switch for handling by serializer, and test them
2013-04-22 ditto. impl to SensorState, Sensor, and test them. and impl set methods to voltage properties of SensorState, and test them
    [VoltageTestCase.csv]
2013-04-23 add DeploymentItem attributes for supecifing sample files to test classes
2013-04-23 refactoring DeviceControllers
2013-04-26 SwitchPage refactoring
2013-04-27 impl SwitchPage
2013-04-29 refactoring CnosolePage, add Vehicle, Motor, Switch Pages and test them
2013-05-02 impl ignoring unconnected devices when transmiting on EhternetBridge
2013-05-12 rename test project
    [VoltageTestCase.csv]
2013-05-13 Vehicle側で編成長を動的に設定するように変更
2013-05-24 実機テストdone VehicleのStop時にはControlBlockを先頭とするようにAllocateし直せばよい？
2013-06-28 pass tests
    [VoltageTestCase.csv]
2013-08-01 MotorDataにCurrentMemoryを追加
    [LedSignalDispatcher.brd, LedSignalDispatcher.sch]
2013-08-09 閉塞チェックできたはず
2014-10-03 2014/10/04 NS exhibition (blockage feature works successfully)
    [AtxPowerDispatcher2.sch, PointAssistant.sch]
2014-10-11 Add new board AtxPowerDispatcher3 and some libraries
    [AtxPowerDispatcher3.brd, AtxPowerDispatcher3.sch]
2014-10-11 Add new method HaltHere, LeaveHere on class Vehicle. Haltableブロックのみをロックすることで，閉塞を他のVehicleに渡せる．追い越しサポートのため
2014-10-13 Add loging feature on TusSolution. ログ機能を追加，関連ライブラリでConsole.WriteLineしてるところを変更． マルチディスプレイだと表示に難点
2014-10-13 Submit AtxPowerDispatcher3
    [AtxPowerDispatcher3.GBL, AtxPowerDispatcher3.GBO, AtxPowerDispatcher3.GBP, AtxPowerDispatcher3.GBS, AtxPowerDispatcher3.GTL, AtxPowerDispatcher3.GTO, AtxPowerDispatcher3.GTP, AtxPowerDispatcher3.GTS]
2014-10-13 Add resuming last vehicles feature 最後に終了した状態に復帰する機能を追加
2015-11-19 Blockをシリアライズする際，Deviceの情報が冗長になることがある．シリアライズ用のクラスBlockSendingObjectを定義して，VehicleとRoute等々をシリアライズする際，そっちを返すようにした
2015-11-20 DevicePacket，EthPacketのサイズを増加，データ領域を拡大することで，パケット分割の抑止，オーバヘッドを抑える． これに伴いデバイス側のコードも変更．コード依存のトラブルがあるかもしれない．
    ・Tus.CommunicationのStructLayoutサイズを変更
    ・EthernetBridgePpはATmega128AのSRAMが足らないので，PacketDispatcherのバッファ等を変更
    ・ARPバッファとENC28J60から引っ張る際のバッファサイズを変更
    ・AtmelStudio7相当にプロジェクトファイルをアップデート
2015-11-20 DialogConsoleの基板間通信インターバルを変更
2015-11-20 AutoControllerのデバッグ
    ・現在位置の追加
    ・列車指定のコンボボックス周りの処理
    ・Phaseタブページの位置からスタートするよう変更
2015-11-20 MotorBoardで現在の状態をpackするところ、パケット分割していたのを消去
2015-11-20 バッファ数の調整
2015-11-20 DeviceChunckの実装
2015-11-20 DevicePacketのパケットサイズの調整
    ・あまり大きすぎると，基板側のバッファが間に合わず，通信が出来ない
    ・小さすぎると，オーバーヘッドになるのでうまい調整が必要
2015-11-20 Revert "DialogConsoleの基板間通信インターバルを変更"
    This reverts commit cce4b3bcaaf4426d47854d4190d95408c621826f.
2015-11-20 Revert "DevicePacket，EthPacketのサイズを増加，データ領域を拡大することで，パケット分割の抑止，オーバヘッドを抑える．"
    This reverts commit 25e1c792e467d24b6b1e54d99712ab3d4d0bdeb5.
    [EthConfig.hpp, EthernetBridge.cpp, arp_table.hpp, packet.h, tus_spi.c]
2015-11-24 AutoControllerで待機する閉塞数を設定出るようにした
    ・StayDistanceの追加
    ・Untenクラスで，StayDistanceとVehicle.Distanceを比較して，Phaseの進行を待機するように変更
2015-11-27 Revert "DevicePacketのパケットサイズの調整"
    This reverts commit 24cd721e900ec5d5549a4b02af50fcce498a80b5.
    Conflicts:
    DeviceSoftware/TusDevice/EthernetBridgePp/tus_mst/tus_mstcfg.hpp
    DeviceSoftware/TusDevice/libtus/packet.h
    ServerUtility/TusSolution/Tus.Communication/DevicePacket.cs
    ServerUtility/TusSolution/Tus.Communication/Ethernet/EthPacket.cs
2015-11-27 Revert "DeviceChunckの実装"
    This reverts commit 8cc489ddc1e2e57ec87ac8a6e8629e372b61f016.
    [packet.h]
2015-11-27 Revert "バッファ数の調整"
    This reverts commit b1aec50cd7cf9e136eeaa3588d1a4f891f35e9a4.
    DeviceSoftware/TusDevice/EthernetBridgePp/EthConfig.hpp
    DeviceSoftware/TusDevice/EthernetBridgePp/EthernetBridgePp_6_1.cppproj
    DeviceSoftware/TusDevice/libtus/libtus_6_1.cproj
    DeviceSoftware/TusDevice/libtuspp/libtuspp_6_1.cppproj
    DeviceSoftware/TusDevice/module_MotorController/module_MotorController_6_1.cppproj
    DeviceSoftware/TusDevice/module_PointController/module_PointController_6_1.cppproj
    DeviceSoftware/TusDevice/module_UartControl/module_UartControl_6_1.cppproj
    DeviceSoftware/TusDevice/module_ledController_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
    [EthernetBridge.cpp]
2015-11-27 Revert "MotorBoardで現在の状態をpackするところ、パケット分割していたのを消去"
    This reverts commit 153ce6e8aee79e08d63e82e37f2f13b1b50b55cd.
    [module_MotorController.cpp]
2015-11-27 EhernetBoardのLCD機能の削除
    ・DialogConsoleにマニフェストの追加
2015-12-12 モータコントローラのソフト修正
    ・WaitingPulseモードで，同じ基板の他の内部モジュールに命令をディスパッチする判定条件が間違っていた
    （おそらくエンディアンに関する修正を行ったときに巻き込まれた？）
    ・avr-gcc系の古いToolchainに関する設定を追加
    （c++系のフレームワークでwarningが出ていたため対応）
    [EthConfig.hpp, EthernetBridge.cpp, EthernetBridge.hpp, MotorProcess.hpp, avr_base.hpp]
2016-03-18 TUSEthernetIOのポート番号指定を変更
    [AtxPowerDispatcher3.brd, AtxPowerDispatcher3.sch]
2016-03-22 引き継ぎで動いたやつ
2016-03-28 テストケースの更新 デバイス側ソフトのビルドオプションの変更（avr-g++のオプション-mrelaxの有無で挙動が変化する？） ExtractPackedPacketで長さ不正なパケットの場合にはyield breakするようにした
